vivisect/vivisect/(threads)

Thread 51 (2015-02-24):

Sniper support for x64 on windows platform

cmaruti, 2015-02-24:
Hi,
I'm trying to figure out how to handle parameters (both for reading and writing argument) on platfrom that pass arguments to the win32 API not on the stack (like x64). I guess setPreCallArgs from CallingConvention object (vivisect/envi/__init__.py) is the right way to do but I have no success.
Let me explain with a snip of code.

```
import sys
import struct
import platform

VDB_ROOT = "C:\\vivisect"
sys.path.append(VDB_ROOT)

TARGET_EXE = "C:\\Windows\\System32\\calc.exe"

from vtrace import *
import envi.memory as e_mem

_log = lambda msg: sys.stderr.write("[+] VTRACE_LOG> " + msg + "\n")
_err = lambda msg: sys.stderr.write("[!] VTRACE_ERR> " + msg + "\n")

def HaxorPreHook(event, trace, ret_addr, args, callconv):
	if trace.isValidPointer(args[2]):
		buf = trace.readMemory(args[2], 255*2)
		ubuf = buf.decode('utf-16le','ignore')
		rstr = ubuf.split('\x00')[0]
		if trace.probeMemory(args[2], 6, e_mem.MM_WRITE):
			buf = ("H4x0r\0").encode('utf-16le')
			trace.writeMemory(args[2], buf)

	#does not work..
        #tmp = args[:]
	#tmp[3] = 0x2
	#callconv.setPreCallArgs(trace.getEmulator(),argc=tmp)

trace = vtrace.getTrace()

os = trace.getMeta('Platform').lower()
print ("System platform is: %s " % os)
print ("Architecture is: %s" % platform.machine() )
print ("The size of pointer is: %d bytez" % trace.getPointerSize() )

# detect calling convention
cc = None
# number of arguments (12 for user32.CreateWindowExW)
argc = None

if '64' in trace.getMeta('Architecture'):
	cc = trace.getEmulator().getCallingConvention('msx64call')
	argc = 12

# Hook call to  kernel32.CreateWindowExW
addHook(trace, "user32.CreateWindowExW", HaxorPreHook, cc=cc, argc=argc)

# Run TARGET_EXE
trace.execute(TARGET_EXE)

# Enter in the debug loop
while trace.isAttached():
	trace.run()
```

After I understand this kind of magic I 'd like to push a new updated version of the sniper module (vivisect/vdb/recon/sniper.py) that works both for 32 and 64 os

invisig0th, 2015-02-24:
Hey man! so the following code works for me on both i386 and amd64:

```
import vtrace
import vtrace.breakpoints as v_bp

def hookfunc(event, trace, retaddr, args, cc):
    print('ret: 0x%.8x: %r' % (retaddr,args))
    if trace.isValidPointer(args[2]):
        if trace.readMemory(args[2],20).decode('utf-16le') == 'Calculator':
            trace.writeMemory(args[2],'woot\x00'.encode('utf-16le'))

trace = vtrace.getTrace()

v_bp.addHook( trace, 'user32.CreateWindowExW', hookfunc )

trace.execute(r'c:\windows\system32\calc.exe')
trace.setMode('RunForever', True)
trace.run()
```

If you wanted, you could probably modify "args" and use setCallArgs(trace,args).  Keep in mind that when the breakpoint hits, we're *in* the function entry point, so setCallArgs rather than setPreCallArgs().

cmaruti, 2015-02-24:
Thanks; I will get a closer look at it tomorrow following your suggestion
Il 24/feb/2015 22:30 "invisig0th" <notifications@github.com> ha scritto:

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

cmaruti, 2015-02-27:
Trying this way
```
def HaxorPreHook(event, trace, ret_addr, args, callconv):
	new_args = args[:]
	new_args[3] = 0x8 #WS_EX_TOPMOST
	callconv.setCallArgs(trace.getEmulator(), args=new_args)
```
get my a segment violation error (Pre hook callback "<function HaxorPreHook at 0x0000000002A56978>" exception: SegmentationViolation('Bad Memory Access: 0x28L',). Any ideas or suggestion?

cmaruti, 2015-03-10:
the last problem I had reported seems related to the number of arguments passed to the addHook function (12); btw the below code does not achieve its goals :(
```
import vtrace
import vtrace.breakpoints as v_bp

def hookfunc(event, trace, retaddr, args, cc):
    if(args[0] == 0x100):
        print "make always on top..."
        args[0] = 0x8 #WS_EX_TOPMOST
        cc.setCallArgs(trace.getEmulator(), args=args)

trace = vtrace.getTrace()

if '64' in trace.getMeta('Architecture'):
	cc = trace.getEmulator().getCallingConvention('msx64call')
	argc = 4

v_bp.addHook( trace, 'user32.CreateWindowExW', hookfunc, cc=cc, argc=argc )

```

cmaruti, 2015-03-16:
Ok I figured out the problem. I incorrectly used the trace.getEmulator() obj instead of trace obj while calling the setCallArgs() function. I left here for further reference...

Closed 2015-03-16.

Thread 57 (2015-03-25):

generic ptr analysis on PEs should be ditched if relocatible

invisig0th, 2015-03-25:
A PE being compatible with rebasing means every in-memory pointer (that's legit) will have a reloc slot.  PEs that can be rebased should *not* be subject to generic ptr finding.

invisig0th, 2015-03-26:
fixed in mainline ( only opened the ticket because I thought I might not get a chance to squash immediately )

Closed 2015-03-26.

Thread 58 (2015-04-06):

Vdb exec inversed logic of continue after attached.

bat-serjo, 2015-04-06:
By default "config -s vdb.BreakOnEntry" is false. But behaves as if true!
example
serj@debian:~/examples/CRACKME$ python ~/netstock/vivisect/vdbbin Crackme
Invalid VDB_EXT_PATH dir: /home/serj/examples/CRACKME/vdb/ext
vdb > config
cli.verbose=false
vdb.BreakOnEntry=false
vdb.BreakOnMain=false
vdb.KillOnQuit=false
vdb.SymbolCacheActive=true
vdb.SymbolCachePath="/home/serj/.envi/symcache"
vdb > exec Crackme

ERROR: (Exception) PT_ATTACH failed! linux platformExec
vdb > exec Crackme
PID 4445 exited: 5 (0x00000005)
vdb > exec Crackme
vdb > Attached to : 4450
Loading Binary: /home/serj/examples/CRACKME/Crackme
Loading Binary: /lib/x86_64-linux-gnu/ld-2.19.so
Loading Binary: [vdso]
Thread: 4450 NOTIFY_BREAK

------------------------------------------------------------------------------------------------
On the oposite when you set it to true -

vdb > config -s vdb.BreakOnEntry=true
vdb.BreakOnEntry=true
saved configuration file to: /home/serj/.vdb/vdb.json
vdb > config
cli.verbose=false
vdb.BreakOnEntry=true
vdb.BreakOnMain=false
vdb.KillOnQuit=false
vdb.SymbolCacheActive=true
vdb.SymbolCachePath="/home/serj/.envi/symcache"
vdb > exec Crackme
vdb > Exit Thread: 4536 (ecode: 0x00000000 (0))
Attached to : 4536
Loading Binary: /home/serj/examples/CRACKME/Crackme
Loading Binary: /lib/x86_64-linux-gnu/ld-2.19.so
Loading Binary: [vdso]
Thread: 4536 NOTIFY_BREAK
No cookies for you
PID 4536 exited: 0 (0x00000000)

It should have waited in the later example and continue in the first.
Problem was traced back to vdb/__init__.py line (423) and should be replaced with something like:

            # only respect BreakOnEntry if we exec'd something
            if self.config.vdb.BreakOnEntry and trace.hasMeta('ExecCommand'):
                self.runagain = False # skip initial break
            else:
                self.runagain = True

invisig0th, 2015-04-11:
haha, looks like a good catch! i'll confirm and fix shortly :)

bat-serjo, 2015-04-13:
Glad to help.
Really like the code base, clean and ordered.

2015-04-11 23:49 GMT+02:00 invisig0th <notifications@github.com>:

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

l1berty, 2015-04-15:
The described symptoms appears to be a combination of 2 conditions:
1.  race condition due to parent/child relationship race for PT_TRACE_ME / PT_ATTACH
(https://github.com/vivisect/vivisect/blob/master/vtrace/platforms/linux.py#L313)
2.  not finding the __entry symbol
(https://github.com/vivisect/vivisect/blob/master/vdb/__init__.py#L78)

For example, I can repro the issue if I peg my other core's and remove the time.sleep call.

This does not appear to be inverted behavior of the BreakOnEntry.  @bat-serjo Can you confirm?

note: still should improve synchronization between parent/child.

bat-serjo, 2015-04-16:
Yes especially the race between [attach_me, attach] is easily
reproducible on my (weak) machine Sometime i get attached to the children
before it's address space have been repopulated and see the memory map of
the vdb.
I believe the parent must perform wait on the child for (i don't remember
the signals name) and then attach to it.

About the entry point symbol I have not experienced this yet even thou I
played with a little crackme that subverts the entry point.

However these two are independent from the logic behind the vdb
configuration for attach on entry.

2015-04-16 1:55 GMT+02:00 l1berty <notifications@github.com>:

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

bat-serjo, 2015-04-24:
After some experimenting in vtrace/platforms/linux.py this seems to be rock solid.
@v_base.threadwrap
    def platformExec(self, cmdline):
        # Very similar to posix, but not
        # quite close enough...
        self.execing = True
        cmdlist = e_cli.splitargs(cmdline)
        os.stat(cmdlist[0])

        pid = os.fork()

        # Child will be blocked after execv because of trace me!
        if pid == 0:
            v_posix.ptrace(v_posix.PT_TRACE_ME, 0, 0, 0)
            os.execv(cmdlist[0], cmdlist)
            sys.exit(-1)

        # Parent will wait for the child
        for i in xrange(0, 33):
            rid, status, rusage = os.wait4(pid, os.WCONTINUED |
                                                os.WUNTRACED  |
                                                os.WNOHANG)
            if status != 0:
                break
        
        res = v_posix.ptrace(PT_ATTACH, pid, 0, 0)
        if res < 0:
            raise Exception("Oh no can't PTRACE!")
            
        self.pthreads = [pid,]
        self.setMeta("ExeName", self._findExe(pid))
        return pid

Looks like the logic in vdb is perfectly fine! The problem was in this function.

Closed 2015-09-21.

Thread 61 (2015-04-28):

win32 platformResumeThread

cmaruti, 2015-04-28:
Seems that platformResumeThread doesn't work as expected on win32 systems. I track down the problem to the following code fragment (file `vtrace/platforms/win32.py`)

```
def platformResumeThread(self, thrid):
        if kernel32.ResumeThread(thrid) == 0xffffffff:
            raiseWin32Error()
```

Accordingly to the MSDN definition (https://msdn.microsoft.com/en-us/library/windows/desktop/ms685086(v=vs.85).aspx) and also the declaration at line `896` in the aforementioned source file, the function call takes an HANDLE as input parameter. Instead the code pass a the thread id so the final result is not consistent. Make sense?

invisig0th, 2015-05-09:
Yep! i'll go take a look.  sorry about the laaaag.  :)

invisig0th, 2015-05-09:
Committed a fix, dunno how that managed to stay dorked so long, thanks!

Closed 2015-05-09.

Thread 81 (2015-08-03):

Exception when trying to "go" rather than "stepi" for PE32 driver

msftsecurityteam, 2015-08-03:
Hi guys, I am trying to emulate a portion of code in a 32-bit PE Windows .sys driver.  I can "stepi" through the code but after setting a breakpoint, issuing "go" gives an exception.

vdb > bp 0x24ea8
 [ Breakpoints ]
[0] 0x00024ea8 Breakpoint: 0x24ea8 enabled: True fast: False
vdb > go
Running Tracer (use 'break' to stop it)

ERROR: (AttributeError) 'TraceEmulator' object has no attribute 'archGetBreakInstr'
vdb >

invisig0th, 2015-08-03:
Hrm, looks like the TraceEmulator may be either missing an arch mixin or be using an outdated API.  I'll take a look ( hopefully this afternoon ).  Probably an easy fix, but may be one of those "on to the next bug" situations in rarely traveled code :)

Thread 86 (2015-09-22):

Vivisect chokes on this file

bat-serjo, 2015-09-22:
This library chokes vivisect.
https://www.fireeye.com/blog/threat-research/2015/09/flare-on_challenges.html

How do you upload files here ?!?

It comes from the flare-on challenge. Level 6.
Validates the input. Should return "That's it!".
Basically forces you to enter the email your self.

```
libvalidate.so: ELF 32-bit LSB shared object, ARM, EABI5 version 1 (SYSV), dynamically linked, interpreter /system/bin/linker, stripped

serj@debian:~/examples/CRACKME/FLARE/6$ ~/netstock/vivisect/vivbin -B ./libvalidate.so                                                                                                 
Traceback (most recent call last):                                                                                                                                                     
File "/home/serj/netstock/vivisect/vivbin", line 142, in <module>                                                                                                                    
    main()                                                                                                                                                                             
File "/home/serj/netstock/vivisect/vivbin", line 98, in main                                                                                                                         
    vw.loadFromFile(fname, fmtname=parsemod)                                                                                                                                           
File "/home/serj/netstock/vivisect/vivisect/__init__.py", line 2071, in loadFromFile                                                                                                 
    fname = mod.parseFile(self, filename)                                                                                                                                              
File "/home/serj/netstock/vivisect/vivisect/parsers/elf.py", line 15, in parseFile                                                                                                   
    return loadElfIntoWorkspace(vw, elf, filename=filename)                                                                                                                            
File "/home/serj/netstock/vivisect/vivisect/parsers/elf.py", line 92, in loadElfIntoWorkspace                                                                                        
    platform = elf.getPlatform()                                                                                                                                                       
File "/home/serj/netstock/vivisect/Elf/__init__.py", line 535, in getPlatform                                                                                                        
    for note in self.getNotes():                                                                                                                                                       
File "/home/serj/netstock/vivisect/Elf/__init__.py", line 524, in getNotes                                                                                                           
    offset = note.vsParse(notebytes,offset=offset)                                                                                                                                     
File "/home/serj/netstock/vivisect/vstruct/__init__.py", line 143, in vsParse                                                                                                        
    offset = fobj.vsParse(sbytes, offset=offset)                                                                                                                                       
File "/home/serj/netstock/vivisect/vstruct/primitives.py", line 147, in vsParse                                                                                                      
    self._vs_value = struct.unpack(self._vs_fmt, b)[0]                                                                                                                                 
struct.error: unpack requires a string argument of length 4                                                                                                                            
serj@debian:~/examples/CRACKME/FLARE/6$
```

after some dirty pcatching i got

```
Loaded (0.1182 sec) ./libvalidate.so
parseOpcode error at 0x0200141f: InvalidInstruction("p_mult: invalid instruction 'd10f2a07' at 0x2001427L",)
parseOpcode error at 0x02001c15: InvalidInstruction("p_mult: invalid instruction 'b50f1c87' at 0x2001c1dL",)
parseOpcode error at 0x020017a7: InvalidInstruction("p_mult: invalid instruction 'b5041cc7' at 0x20017afL",)
parseOpcode error at 0x0200132d: InvalidInstruction("p_uncond (ontop=0): invalid instruction '6c7047f0' at 0x2001335L",)
parseOpcode error at 0x02001331: InvalidInstruction("p_uncond (ontop=2): invalid instruction 'b5cb6bf9' at 0x2001339L",)
parseOpcode error at 0x02001469: InvalidInstruction("p_mult: invalid instruction 'd10f2a07' at 0x2001471L",)
parseOpcode error at 0x02000e71: local variable 'Rn' referenced before assignment
ANALYSIS TIME: 0.89896607399
stats: {'functions': 38, 'relocations': 0}
Saving workspace: ./libvalidate.so.viv

~/netstock/vivisect/vivbin  ./libvalidate.so.viv
Loaded (0.0172 sec) ./libvalidate.so.viv
```

So far so good. Strings workspaces are there. Elf structures are parsed. Imports, Exports. Some functions exit but they don't look very good.
At one point we start getting this error

```
.text:0x020013f3  FUNC: void unknown libvalidate._Unwind_DeleteException( ) [1 XREFS]
.text:0x020013f3
.text:0x020013f3  Stack Variables:
.text:0x020013f3
.text:0x020013f3  b5836801         streqh r8,[r8, #-0x35]!
.text:0x020013f7  1c002b01         bxeq r12
.text:0x020013fb  d0012098         stmloda r0!,{r4, r6, r7, r8, }
.text:0x020013ff  4708bd10         adcnes r0,sp,r7, asr #16
.text:0x02001403
.text:0x02001403  FUNC: void unknown libvalidate._Unwind_VRS_Get( ) [0 XREFS]
.text:0x02001403
.text:0x02001403  Stack Variables:
.text:0x02001403
.text:0x02001403  b5041c04         ldreq r0,[r12] #-0x4b5
.text:0x02001407  2913d808         ldmeqia r8,{r0, r3, r5, r8, r9, r12, }^
.text:0x0200140b  1c00f072         rscvcs r0,r0,#0x1c
.text:0x0200140f  fd050311         strned r0,[r3, -sp]
.text:0x02001413  03030001         mrseq r0,
Render Exception At 0x2001413L: cannot concatenate 'str' and 'NoneType' objects
.text:0x02001413  03030001         mrseq r0,
Exception At 0x2001413L: Traceback (most recent call last):
File "/home/serj/netstock/vivisect/envi/memcanvas/__init__.py", line 304, in renderMemoryAppend
    rsize = rend.render(self, va)
File "/home/serj/netstock/vivisect/vivisect/renderers/__init__.py", line 51, in render
    self.renderLocation(mcanv, loc, name, func, cmnt, extra)
File "/home/serj/netstock/vivisect/vivisect/renderers/__init__.py", line 158, in renderLocation
    mcanv.addText("Opcode Render Failed: %s\n" % repr(extra))
File "/home/serj/netstock/vivisect/envi/archs/arm/disasm.py", line 1461, in __repr__
    x.append(o.repr(self))
File "/home/serj/netstock/vivisect/envi/archs/arm/disasm.py", line 2089, in repr
    return psrs[self.psr] + '_' + fields[self.val]
TypeError: cannot concatenate 'str' and 'NoneType' objects
```

Also code analisys doesn't do well.

```
.text:0x02000e65  FUNC: void unknown libvalidate.Java_com_flareon_flare_ValidateActivity_validate( ) [0 XREFS]
.text:0x02000e65
.text:0x02000e65  Stack Variables:
.text:0x02000e65
.text:0x02000e65  b5504c05         streqb r5,[r12, #-0xb5]
.text:0x02000e69  1c0021a5         strge r0,[r1, #-0x1c]!
.text:0x02000e6d  4402921e         cdpne p2,9,c0,c2,c4,2
.text:0x02000e71  a8
.text:0x02000e72  4e
.text:0x02000e73  4a
.text:0x02000e74  01
.text:0x02000e75  f0
.text:0x02000e76  48
.text:0x02000e77  f8
.text:0x02000e78  4d
.text:0x02000e79  49
.text:0x02000e7a  5c
.text:0x02000e7b  22
```

And some like this occurs

```
.plt:0x02000de4
.plt:0x02000de4  FUNC: void unknown sub_02000de4( ) [1 XREFS]
.plt:0x02000de4
.plt:0x02000de4  Stack Variables:
.plt:0x02000de4
.plt:0x02000de4  00c68fe2         adr r12,loc_02000dec
.plt:0x02000de8  04ca8ce2         add r12,r12,#0x4000
.plt:0x02000dec  loc_02000dec: [1 XREFS]
.plt:0x02000dec  00f2bce5         ldr pc,[r12, #0x200]!
.plt:0x02000df0  00
.plt:0x02000df1  c6
.plt:0x02000df2  8f
.plt:0x02000df3  e2
.plt:0x02000df4  loc_02000df4: [1 XREFS]
.plt:0x02000df4  04
.plt:0x02000df5  ca
.plt:0x02000df6  8c
.plt:0x02000df7  e2
.plt:0x02000df8  f8
.plt:0x02000df9  f1
.plt:0x02000dfa  bc
```

atlas0fd00m, 2015-09-22:
sergey,

could you please send the library to my email address atlas@r4780y.com?

thanks,
@

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
)
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
in
> __repr__ x.append(o.repr(self))
> 	File "/home/serj/netstock/vivisect/envi/archs/arm/disasm.py", line 2089,
in
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

--
3031303030303131303131303131313130313130313130313031313030313031303031303030303030313130313131303031313031313131303031303030303030313130303131303031313130313031303131313030313030313131303130303031313031303030303131303031303130313131303031303030313031313030303031303030303030313130303131303031313031313131303131313030313030303130303030303031313030313030303131303031303130313130303030313031313130313030303131303130303030303130303030303031313030303031303131313031313130313130303030313031313031303031303131313031303030313131303031313030313030303030303131313130303130313130313131313031313130313031303031303030303030313130303030313031313031313030303131303131303030303130303030303031313130313131303131303130303130313131303130303031313031303030303031303030303030313130313131303031313030303031303131313030313130313131303130303031313131303031303031303131303030303130303030303031313030303130303131303130303130313130303131313030313031313030303031303030303030313131303030303031313031313131303131303130303130313130313131303031313130313030303131313130303130303130303030303031313130313030303131303031303130313130303130313031313130313030303131303130303030303030313031300A

Closed 2016-11-15.

Thread 90 (2015-10-06):

makeName(None) exceptions

atlas0fd00m, 2015-10-06:
currently VivWorkspace indicates this method in order to remove a name:  "makeName(None)".

when attempting to clear out a name in the workspace (to reuse it), the following exception occurs.
this appears to be due to updates to the call graph.

Traceback (most recent call last):
  File ".../vivisect/base.py", line 499, in _fireEvent
    self.ehand[event](einfo)
  File ".../vivisect/base.py", line 314, in _handleSETNAME
    self._call_graph.setNodeProp(fnode,'repr',name)
  File ".../visgraph/graphcore.py", line 186, in setNodeProp
    raise Exception('graph prop values may not be None! %r' % (node,))
Exception: graph prop values may not be None! (33559537L, {'repr': 'libvalidate._Unwind_Complete'})

Closed 2020-07-27.

Thread 120 (2016-03-30):

Walk through

redheadedrod, 2016-03-30:
Can someone walk me through how to use this program?

And maybe have some example code to use with this?

Looks like I will be doing some work extending this software this summer but I want to demo it in my Architecture class to the other students for my end of semester presentation. I have briefly looked through the software but if someone could walk me through a basic run of the program that would save me a LOT of time and get me on the ground running for this summer. I don't really see much documentation on using it so a little help would go a long ways.

Thank you!

williballenthin, 2016-03-30:
There's a lot in vivisect, and sample code is spread all over the place. Here's a few quick points that definitely do not do the tool justice.

show vivisect analysis results and ui: `vivbin -A /usr/bin/ls`
debug with vivisect vdb: `vdb -Q /usr/bin/ls`

load a workspace:

    vw = vivisect.VivWorkspace()
    vw.verbose = verbose
    vw.config.viv.parsers.pe.nx = True
    vw.loadFromFile("/usr/bin/ls")
    vw.analyze()
    vw.saveWorkspace()

disassemble an instruction:

    o = vw.parseOpcode(0x401000)
    print(o)
    print(dir(o))

list functions:

    vw.getFunctions()

get cross references:

    vw.getXrefsTo(0x401000)

get basic blocks for function:

    vw.getFunctionBlocks(0x401000)

There's hundreds of functions and thousands of things you can easily do, so this is the smallest taste of its functionality. But hopefully it gives you ideas for some things you can include during your demo.

cmaruti, 2016-03-30:
I have collected a lot of pointers over the years to various vivisect materials. Here you go:
- https://www.singlehop.com/blog/binary-vivisection-part-1/
- https://www.singlehop.com/blog/binary-vivisection-part-2/
- https://www.singlehop.com/blog/binary-vivisection-part-3/
- http://nest.unm.edu/files/5514/1254/9114/Malware_Analysis_with_Vivsect.pdf
- https://www.fireeye.com/blog/threat-research/2013/02/custom-vdb-debugger-exploit-analysis.html
- https://github.com/fireeye/flare-dbg/
- http://shellsherpa.nl/stealing-keepasswords-with-vivisect
- http://dvlabs.tippingpoint.com/blog/2012/04/02/mindshare-vtrace-input-tracking

A bit outdated but still a good references:
- https://www.defcon.org/images/defcon-16/dc16-presentations/defcon-16-atlas.pdf
- https://github.com/pdasilva/vtrace_scripts

redheadedrod, 2016-04-01:
Thanks for the pointers. I will try working with this this weekend and go from there. I am going to try doing a demo of using this program for my Architecture class  so I have a couple weeks to learn how to use it.

I also received some other pointers offline so hopefully I have enough to get started playing with it.

Rodney

redheadedrod, 2016-04-09:
While trying these there seems to be a bug/issue that has come up.
With the part-1 the file reverseme.exe is converted to a .viv file and then opened up in the gui.
The instructions say to click on the "strings" tab which has nothing in it. I have tried this with other programs and I am
getting the same result. I have tried this on a machine running Windows 10, Windows 8.1 and under Ubuntu 15.10 and they all show the same issue so I am under the impression it is a bug at this point in time.

Or am I missing something?
I have been able to do some other stuff and look through stuff as well but I just don't see the strings.
I have also tried the atlas fork as well as the main fork for this.

Rodney

Date: Wed, 30 Mar 2016 08:42:15 -0700
From: notifications@github.com
To: vivisect@noreply.github.com
CC: redheadedrod@hotmail.com
Subject: Re: [vivisect/vivisect] Walk through (#120)

I have collected a lot of pointers over the years to various vivisect materials. Here you go:

https://www.singlehop.com/blog/binary-vivisection-part-1/
https://www.singlehop.com/blog/binary-vivisection-part-2/
https://www.singlehop.com/blog/binary-vivisection-part-3/
http://nest.unm.edu/files/5514/1254/9114/Malware_Analysis_with_Vivsect.pdf
https://www.fireeye.com/blog/threat-research/2013/02/custom-vdb-debugger-exploit-analysis.html
https://github.com/fireeye/flare-dbg/
http://shellsherpa.nl/stealing-keepasswords-with-vivisect
http://dvlabs.tippingpoint.com/blog/2012/04/02/mindshare-vtrace-input-tracking

A bit outdated but still a good references:

https://www.defcon.org/images/defcon-16/dc16-presentations/defcon-16-atlas.pdf
https://github.com/pdasilva/vtrace_scripts

—
You are receiving this because you authored the thread.
Reply to this email directly or view it on GitHub

cmaruti, 2016-04-11:
Hi @redheadedrod
first of all did you load a layout? (Use _View->Layouts->Load and select vivisect/qt/default.lyt_).
I just tested the binary referenced in the tutorial and I can see the strings pane correctly filled up...

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

redheadedrod, 2016-04-11:
Yes I am using the default load out.
I downloaded the latest vivisect from github by downloading a zip and copied this to its own directory as late as 4/8.

I am using anaconda under windows 10 and loaded the pyqt class.
Using ipython which is using the 2.7 python kernel.
Everything else I try is working so far but not the strings portion. Ive loaded all three of the programs mentioned in the first 3 tutorials but I am not seeing strings in any of them.

Ive also tried it under windows 8.1 and Ubuntu 15.10. The ubuntu I installed ipython via anaconda.

I wonder if I am missing something in the folder that might be preventing it from working?

Did you try it with the current github version?

I have also had issues when I maximize the screen that shows the graph. When I close it out my instance of vivisect crashes and I have to restart it.  So I have learned not to maximize the graph.

Thanks for your help! I really want to get down to the nitty gritty with this program in the next week or so since I hope to demo using this program end of next week as my presentation in my architecture class.

I look forward to working with this framework this summer and hopefully I will be productive in extending it in whatever manner my mentor has in mind for me. I do appreciate any help you or anyone else provides as it accelerates my understanding and hopefully will help me be productive that much sooner.

cmaruti, 2016-04-11:
Just checked out the last master and I had the same problem reported by @redheadedrod cc: @atlas0fd00m @invisig0th

atlas0fd00m, 2016-04-11:
i've been noticing a serious degradation of string identification recently.  so much so that i've written a temporary string-scraping script for some firmware i'm tearing apart right now.  we need to look into it better.  i believe i saw that only function analysis looks for strings in xrefs from within the functions.  ideally that would be enough, but with string arrays and such, this seems insufficient.

redheadedrod, 2016-04-12:
It seems to be a sporatic thing. I have tried running it on my laptop yesterday under Windows 10 and something must have been updated because now the strings are working but the layout system is touchy but just on my laptop. If I load a new layout instead of replacing the current layout it just takes some portion of the screen and combines it together in a weird manner. On my desktop running Win 8.1 but with same exact ipython setup I don't see the strings but the layouts work fine. I will try working with this under ubuntu a little more and see if anything changes. The lack of strings issue was happening on my desktop on a ubuntu 15.10 VM but my laptop triple boots so I will try to install it under Ubuntu 15.10 and Kali2.0 rolling and see if I have any better luck.

Date: Mon, 11 Apr 2016 08:54:04 -0700
From: notifications@github.com
To: vivisect@noreply.github.com
CC: redheadedrod@hotmail.com
Subject: Re: [vivisect/vivisect] Walk through (#120)

Just checked out the last master and I had the same problem reported by @redheadedrod cc: @atlas0fd00m @invisig0th

—
You are receiving this because you were mentioned.
Reply to this email directly or view it on GitHub

atlas0fd00m, 2016-04-12:
the strings analysis should happen during Bulk Analysis (vivbin -B somebin.exe) which doesn't use the GUI.  then the generated file (somebin.exe.viv) can be loaded on either machine.

can you describe exactly what happens?  try doing bulk analysis on both systems and loading both generated .viv files on both machines.  let us know if you can isolate anything further.  differences between systems is very odd for viv.

@

--
GUYTKOBVGE3DONJZGUZTIMRWIE2UCNJYGRATGMBVHE2TONSDG42TIOJUHA2DENZWGYYTKNZTGUZTANBZGQ3TMQZXGU2DSNBYGUZDOMBWGI2TONJVG4ZTIOJUHA2TENSGGVATKMZUGI3TSNKBGU4DINRTGE3DCNJYGRATMQZVIE2DGNBSG4ZTKQJVHA2UCNSDGYZDIMZUGI3TMNKBGY4TIMRWIE3DEMZSGMYTONZWGM3EINJWGZDDKQJVG4ZTKN2BGYYTKNZTHE3TKNBZGQ4DKMRXGY2DSNBXGQ3DMQJWGE2DONSDGZBTMNBWIQ2TKNRXGU4TKMZUGI3UCNRUGU3TIRJWIE2UCNJYGRCTOQJVIE3EKNJWG4ZTIOJUG42TMMZUGYZTINZXHA3TMNRRGU4DKMRWHA3DINBXGZBTONRWGI3DSNBSG44TKQJVG42DMNSBGYYTINZVGY3UCNBZGQ4DKMRWIY2UCNJTGQZDMQZVIE2DONRUGZBTIOJUG4ZTSNSEGQ4TINZWIM3TKNRTGMZDINRXGU3DCNJYGUZDGNJUIM3DSNBSGU2TMMJUG42TKNRXGYZTGMZUGI3TANRTGZCDMQZTGA2DSNBXGMYTMQZWGI2DQNJSG5ATIOJUHA3DINZQGY2DINZWG43DONRSGU3TINRWII3DENSEGU3DOQJWGM3TSNZXGY3TMNBTGI2TKNRXGY2DINZVGY3TINRTGQ3TGOJXHE2TSNJYGRATOMBWGI2DQNSCGY3TMMRUG4ZTSNZWGYZTGMRVGU3DONJZGU3TOOBXGM2DSNBXG42DOMBWGI3EINJRGY3TMMRTGI2TSNRXGYZTMRBUGYZTANRRGU3TGOJXGU2TSNJXG44DOMBWGQ2DQNSCGY3TKOJVG4ZTKNSCGQ4TIOBWGQ3EGNBZGQ3TKNRXGU3DINBXGU3DOOJUHE2DONBVGY3TMMZTGM2TENRYGY2DINZVGU3DONRSGMZDKOJWG43DCNJXG44DOMZWGQ2TOMZRG4YDMMRWIQ2DMMZQGYYTKNZTHE3TKNCDGY4TIMJXGQ2DSNBYGVATMQRVGE2DQNBSGZDDMMZWIQ2DMNSBGYYTOOJTGU3TMNRTGZCDMMZUII======

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

redheadedrod, 2016-04-12:
How I am doing this is running vivbin -B reverseme.exe which produces a reverseme.exe.viv file.

I then load this by using the command vivbin reverseme.exe.viv

I have tried this both in windows and linux and get the same result. This is a simple windows program that expects a key and kicks out with "evaluation period has ended". It is special made for reverse engineering to remove the "evaluation period has ended" warning. When you bypass the key it says something like "You completed it!"

While I can see strings in the .DATA segment I am seeing absolutely nothing in the Strings tab...
The strings in the .DATA segment show references in the listing so the program knows they are there.
And they also end with a 00 so it should be easy for the program to pick up those strings.

I get a little different response when running ELF binaries.

I compiled conditional.c from one of the tutorial links and loaded it via using the same command as before:
vivbin -B conditional
Then run the GUI via:
vivbin conditional.viv

With this I DO get some entries in the strings tab but they seem to be references to libraries installed by the program and I see a puts\x00 and printf\x00  Otherwise it appears to just be listing the libraries it is using and some versioning related to the libraries.

I do seem to be getting the same results with the strings tab regardless of where I am going and is very repeatable. I am not familiar enough (yet) with ELF format to know where to find strings.

Update on the layouts issue I was having too...
When loading a new layout the layout is laid on top of the current layout. In order to properly load a new layout I have to remove all of the windows until I just have the interactive window. Shouldn't the program clear the current layout before loading a new layout over the top of the screen? It really looks weird if you load the default layout over the top of the default layout.

Note I am a new user to this program and have not touched upon the CLI much yet. I have been trying to understand the program as much as I can for my presentation next week.

cmaruti, 2016-04-14:
@redheadedrod commit [#124](https://github.com/vivisect/vivisect/commit/e37aa4b3b649cd368be13171d405c5b503e301e1) resolve the issue you reported

Closed 2022-01-20.

Thread 122 (2016-04-11):

syscomments to allow the disassembly/analysis to insert/delete "system" comments without mucking with manual comments.

atlas0fd00m, 2016-04-11:
for example:
ARM binaries often perform a GOT-offset calculation and store the GOT location in a register, allowing register-math to access all the resources in a position-independent way.  it would be awesome to be able to have analysis modules look for such pointer math and stick a comment about where it points.  this may not be the end result for handling this particular PIE-like thing... but quickly devving up an impromptu analysis module which can write comments without fear of collision with user comments is a big plus.  being able to delete them (programmatically, or as a user interaction) without mucking with user comments is a great thing as well (eg. clean up after a bad analysis pass).

atlas0fd00m, 2021-03-12:
not worth the effort at this time...  best to just make the comment (prepending if one exists) which is just an extra 3 lines of code.

Closed 2021-03-12.

Thread 123 (2016-04-12):

Automatizing Strings + inline commented

jags613, 2016-04-12:
Hi!

I see that strings only show up in the strings pane if manually designated as such.

Is it possible to have automatic analysis to add strings (even if it adds some garbage or false positives)?
And if so, could these then be shown in line when referenced in the assembly/graph views?

This can be very helpful when analyzing for functionality.

Thanks!

invisig0th, 2016-04-12:
The automatic analysis pass (for most plaforms/formats) should be able to identify string constants in general.  Would you mind sharing a bit more about the circumstances?  Also, vivisect *strongly* prefers "correctness" over "completeness" ( primarily designed to facilitate algorithmic approaches rather than humon review ) so loosening strings and causing more false positives will probably not work.

jags613, 2016-04-12:
In that case, let me backtrack, the strings pane doesn't include anything (running vivisect on OS10.11) both when analyzing PE or Mach-O binaries. If I find the string and designate it as such then it'll show up but not otherwise.

invisig0th, 2016-04-12:
Did you create the workspace yourself ( via the API ) or via the cli?  ( If you were working directly with the workspace API, dont forget to call analyze() ).  Do you see functions and such?

jags613, 2016-04-12:
Not sure where the analyze() instruction would go (haven't found documentation for the API, though would love a means to invoke standalone emulator features if that's already in there). I'm creating/launching with vivbin -B <binary>. Am I missing a step for the analysis?

invisig0th, 2016-04-12:
Nope, vivbin -B should be doing the analysis pass and then saving the results (including emulation).

cmaruti, 2016-04-12:
Here you go with a sample snippet of code I did in the past to practice with the API
```python
import sys

VDB_ROOT = "K:\\vivisect_20140803"
sys.path.append(VDB_ROOT)

import vivisect.cli as viv_cli
import vivisect.parsers as viv_parsers

TARGET_NAME = "C:\\Windows\System32\calc.exe"
DEBUG = True

vw = viv_cli.VivCli()
parsemod = viv_parsers.guessFormatFilename(TARGET_NAME)
vw.loadFromFile(TARGET_NAME, fmtname=parsemod)
vw.analyze()

print "Segments #: %d" % len(vw.getSegments())

if DEBUG:
  print "[Segments]"
  for seg in vw.getSegments():
    print seg

print "Imports #: %d" % len(vw.getImports())

if DEBUG:
  print "[Imports]"
  for imp in vw.getImports():
    print imp

print "Exports #: %d" % len(vw.getExports())

if DEBUG:
  print "[Exports]"
  for exp in vw.getExports():
    print exp

print "Functions #: %d" % len(vw.getFunctions())

if DEBUG:
  print "[Functions list]"
  for func in vw.getFunctions():
    print "\t0x%08x %s" % (func, vw.getName(func))

print "Names #: %d" % len(vw.getNames())

if DEBUG:
  print "[Names]"
  for addr, name in vw.getNames():
    print "\t0x%08x %s" % (addr, name)```

atlas0fd00m, 2016-04-12:
i like to set verbose mode to 4 before calling analyze:

...
vw.verbose=4
vw.analyze()
...

but that's because i love all the nummy details (probably cuz it helps me develop)

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
--
4B5255474B345446454255584749444F4E34514732594C484E465253413544504542525736334C514F5632474B345454465151473633544D5045514732594C484E46525753594C4F4F4D5841553D3D3D
> https://github.com/vivisect/vivisect/issues/123#issuecomment-208962075

jags613, 2016-04-13:
Thank you for the script! I'll play around with this a bit.

Should I chuck up the no-string problem to OSX issues or is there a way to fix this?

atlas0fd00m, 2016-04-13:
@invisig0th visi: VivWorkspace.detectString() is horribly broken.  it bails if the second byte of a potential string is not a location....

invisig0th, 2016-04-15:
Commited your fix.  Without more specifics to address i'd like to close this ticket ( and start fresh if there are more issues )

atlas0fd00m, 2016-04-15:
works for me.  @jags613 work for you?  please pull the latest code and test.

jags613, 2016-04-15:
Thank you for the hard work guys!
Strings work perfectly on OSX host analyzing Windows binaries.
Not getting good results on macho binaries, either no strings at all or some chopped up strings.

Thread 149 (2016-09-13):

envi.memory.parseOpcode cannot decode instructions in last 15 bytes of section

williballenthin, 2016-09-13:
`envi.memory.IMemory.parseOpcode()` cannot decode instructions in the last 15 bytes of a memory map because it blindly asks for 16 bytes from which to decode instructions. see here: https://github.com/vivisect/vivisect/blob/master/envi/memory.py#L301

this always fails in the last 15 bytes because `.readMemory()` calls `.probeMemory()` on 16 bytes, and because at least one byte overruns the section, the entire return buffer is taint data ("AAAAAAA...").

a potential fix is to take 16 bytes, unless we're at the end of the section, and then fetch data only to the end of the section.

Closed 2021-03-08.

Thread 152 (2016-09-18):

Segment mismatch on PE binary

cmaruti, 2016-09-18:
I found that vivisect analyze() detect less segments than the PE parser. The following PoC presents the issue (you can find the sample binary used in the code fragment at the following URL http://www.singlehop.com/blog/wp-content/uploads/reverseme.exe.exe)

```python
import sys

VDB_ROOT = "C:\\vivisect-master"
sys.path.append(VDB_ROOT)

import PE
import vstruct
import vivisect.cli as viv_cli
import vivisect.parsers as viv_parsers

TARGET_NAME = "C:\\Users\\cm\\Documents\\reverseme.exe"

vw = viv_cli.VivCli()

parse_mod = viv_parsers.guessFormatFilename(TARGET_NAME)

if parse_mod != "pe":
	sys.exit("[!] Executable file format not supported by vivisect...");

vw.loadFromFile(TARGET_NAME, fmtname=parse_mod)
vw.analyze()

print("vivisect analyze() detect the following segments:")
for seg in vw.getSegments():
	print seg

def parseSections(pe):
	sections = []
	off = pe.IMAGE_DOS_HEADER.e_lfanew + len(pe.IMAGE_NT_HEADERS)

	secsize = len(vstruct.getStructure("pe.IMAGE_SECTION_HEADER"))

	sbytes = pe.readAtOffset(off, secsize * pe.IMAGE_NT_HEADERS.FileHeader.NumberOfSections)
	while sbytes:
		s = vstruct.getStructure("pe.IMAGE_SECTION_HEADER")
		s.vsParse(sbytes[:secsize])
		print s.Name
		sections.append(s)
		sbytes = sbytes[secsize:]

print("PE detect the following segments:")
pe = PE.peFromFileName(TARGET_NAME)
parseSections(pe)
```
And here is the output:
```
vivisect analyze() detect the following segments:
(4194304, 4096, 'PE_Header', 'reverseme')
(4198400, 4096, 'CODE', 'reverseme')
(4202496, 4096, 'DATA', 'reverseme')
(4206592, 4096, '.idata', 'reverseme')
(4210688, 4096, '.reloc', 'reverseme')
PE detect the following segments:
CODE
DATA
.idata
.reloc
.rsrc
```

Thread 203 (2017-12-29):

Website from the README (http://visi.kenshoto.com/) is down

pfalcon, 2017-12-29:
README refers to http://visi.kenshoto.com/ for additional information, but that site can't be contacted. More specifically, "visi.kenshoto.com" or "kenshoto.com" domain names can't be resolved, including when using Google's DNS 8.8.8.8. This happens at least for 2nd day.

Note that without that site, the README barely gives any information about the project, for example Vdb's descriptions starts with:

> As in previous vdb releases, the command python vdbbin

How is that relevant for a new user?

And Vivisect is described as:

> Fairly un-documented static analysis / emulation / symbolik analysis framework

follower, 2019-02-24:
FWIW archive.org has snapshots of the page to which that URL originally redirected:

 * Most recent: [http://visi.kenshoto.com/viki/MainPage (on archive.org)](http://web.archive.org/web/20161225225334/http://visi.kenshoto.com:80/viki/MainPage)

Snapshots of sub pages also seem to be present.

9527KGG, 2019-05-10:
Is it possible to move the doc to github? just wondering~

rakuy0, 2021-03-12:
Possibly? Though it be be more worth it to create new ones since I don't have ready access to them, so I have no idea what state they're in.

They're also definitely pre-python3 vivisect, so even if we migrated them, they'd need some touch ups.

But honestly, me or @atlas0fd00m need to carve out time to just make new docs. Enough has changed in the last few years. We've just been super busy. It's been a long time TODO, but I'm hoping now that python3 is off my plate and some of atlas's big PRs are coming down the home stretch we can carve out time for them.

TL;DR: Been super busy, gonna circle back once some big ticket items are done to write some fresher examples.

(and sorry about the delay in response. I completely missed the notifications about this thread)

Closed 2021-03-12.

Thread 211 (2018-04-21):

8d14f500000000 decodes incorrectly

atlas0fd00m, 2018-04-21:

atlas0fd00m, 2018-04-22:
Currently:
  .text:0x020b80fc  8d14f500000000   lea edx,dword [0x00000000 + esi * 8]

Should be:
  lea     edx, ds:0[esi*8]

rakuy0, 2019-05-09:
@atlas0fd00m Is this still valid (and do you have the binary that displays it)?

I've got a super small test binary that has that byte string in it, and nasm, binary ninja, vivisect, https://onlinedisassembler.com/odaweb/, and https://defuse.ca/online-x86-assembler.htm all seem to agree that 8d14f500000000 all encodes/decodes to lea edx,dword [0x00000000 + esi * 8].

Or does whatever binary this is also have some other segment shenanigans going on and we need to push segment info through the decoding or analysis passes?

atlas0fd00m, 2019-05-10:
damn, i'm dense.  for some reason i thought that said gs:.
closed.

Closed 2019-05-10.

Thread 260 (2019-11-25):

vdb View->Memory Maps crash: trace==None

atlas0fd00m, 2019-11-25:
when attached to a process ("vdbbin -Q -p ####") and attempting a "View->Memory Maps", vdb crashes with this error:

Traceback (most recent call last):
  File "/OTHER/home/atlas/hacking/git/vivisect/vivisect/vqt/menubuilder.py", line 87, in __call__
    return self.callback(*self.args, **self.kwargs)
  File "/OTHER/home/atlas/hacking/git/vivisect/vivisect/vdb/qt/main.py", line 347, in menuViewMemMaps
    self.vqBuildDockWidget('VQMemoryMapView')
  File "/OTHER/home/atlas/hacking/git/vivisect/vivisect/vqt/application.py", line 128, in vqBuildDockWidget
    obj = cls(*args)
  File "/OTHER/home/atlas/hacking/git/vivisect/vivisect/vtrace/qt.py", line 510, in __init__
    envi_qt_memmap.VQMemoryMapView.__init__(self, trace, parent=parent)
  File "/OTHER/home/atlas/hacking/git/vivisect/vivisect/envi/qt/memorymap.py", line 30, in __init__
    self.vqLoad()
  File "/OTHER/home/atlas/hacking/git/vivisect/vivisect/vtrace/qt.py", line 513, in vqLoad
    if not self.trace.isAttached():
AttributeError: 'NoneType' object has no attribute 'isAttached'
Aborted

rakuy0, 2019-11-27:
Interesting. Just tried this on a custom built vim I've got, and it works fine. At least on ubuntu linux. But there's a variety of other things that could have aligned to mess yours up.

Do you happen to have the binary that causes it laying around? Any other recreation steps (like what you were doing at the time, did you click on anything else)?

rakuy0, 2020-05-07:
Poke ^^

Thread 279 (2020-04-21):

ImportError:No module named constants vstruct.constants  as vs_const

maoguai, 2020-04-21:
i was able to use vivisect before ,but now when i import vivisect, i meet ImportError problem

rakuy0, 2020-04-21:
Odd. There's only one place we call `import vstruct.constants as vs_const` and that's in vivisect/base.py. That hasn't changed in a long time and the CI builds for vivisect's master branch say they still work. So that's a bit weird.

So a couple questions to try and help narrow down the problem:
* Do you have any idea as to what changed to make it not work all of a sudden? Was it a git pull or something else?
* What vivisect branch and commit hash are you on?
* Do you have any changes to vivisect sitting on your checkout?
* Just in case, do you have the full exception traceback?
* What python version are you on?
* What's your PYTHONPATH env var look like?

maoguai, 2020-04-22:
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
I use python 2.7,i meet this problem that i just import vivisect .
I use sys.path.append() to add vivisect to my path.
vivisect-master I used MD5 (vivisect-master.zip) = b9a93f09d87b3f201cf29a18c9d9c095 sha1= 280b299d2ff233f878bdadd66ba87637181a5206
I have no idea what have changed

rakuy0, 2020-04-22:
Can you re-download the latest vivisect (I don't know what git commit that md5 of vivisect corresponds to, but the latest zip file md5 is `16061452f7eda084c8399ebb91da1584` and I know that one works). Or you can git clone the latest vivisect master branch like so:
`git clone https://github.com/vivisect/vivisect.git`

That way we're at least on the same version, which should make debugging easier.

maoguai, 2020-04-22:
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
I have updated to the lastest vivisect, but it still doesn't work in python 2.7. could you make it work in python 2.7?
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

rakuy0, 2020-04-22:
It works for me on python 2.7.15 just as you're doing it, which makes me think something else is going on, like a mismatched path or you're colliding with something else like floss.

If you do `import vstruct`, and assuming that doesn't blow up, and then `print(vstruct.__file__)`, what comes out?

And if you just try to run vivbin directly using python, what happens?

maoguai, 2020-04-22:
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
Is problem happened in there?

rakuy0, 2020-04-22:
Yea, you have some conflicting versions of vivisect on your machine, one you seem to have installed via pip and another you're trying to just download and use. The constants module should still exist, which is odd, but conflicting versions are weird, so as a final check, can you do `import vstruct.constants` and `print(vstructs.constants.__file__)`?

But best to just remove the old version in any case and see if that fixes it.

maoguai, 2020-04-22:
ohh,i probably find the mistake that is mismatched path. I delete the vstruct file in python and now it works. Thanks for your patient reply. vivisect is very useful

williballenthin, 2020-04-22:
i bet this guy was the culprit: https://pypi.org/project/vivisect-vstruct-wb/ 😇

Closed 2020-04-22.

Thread 280 (2020-04-25):

vdb with fast-break, target exits on segfault

atlas0fd00m, 2020-04-25:
i would very much like to inspect what segfaults...
but with fast-break, this seems impossible.

without the fastbreakpoint:
```
vdb > Process Recieved Signal 11 (0x0000000b) (Thread: 13171 (0x00003373))
vdb > gui
```

with the following breakpoint:
```
bp -f binary.function+153
bpedit 0 "print '0x%x: 0x%x' % (poi(trace.getRegisterByName('rbp')-24), trace.getRegisterByName('al'))"
```
and we get:

```
Process Recieved Signal 11 (0x0000000b) (Thread: 13082 (0x0000331a))
PID 13082 exited: 0 (0x00000000)
```

the fastbreak is hit repeatedly before the crash.  this seems to be important

Thread 282 (2020-04-25):

vdbbin on amd64 reads memory oddly... and i'm not sure it's correct

atlas0fd00m, 2020-04-25:
you can see the "80484a8* at 0x200 below... but it's offset 4 bytes from what should be.
other seemingly 32-bit numbers look to be the upper 32 of a 64-bit address (see the stack-like addresses in f7f* adn f7e*).  such as the line with `(savedpc)` on it... clearly not in libc if it's a 32-bit number.

furthermore, the initial display of the stack addresses only show the lower 32bits.
see memory maps below.

```
vdb > dr rsp
 0    : 0xffdf16e0 (rsp)   : 0x400ffdf1748
 8    : 0xffdf16e8         : 0xf7dc5cd708f33570
 16   : 0xffdf16f0         : 0x6dcb300000000
 24   : 0xffdf16f8         : 0xf7eb5860f7d522f9
 32   : 0xffdf1700         : 0xf7eb5860f7d52c97
 40   : 0xffdf1708         : 0xf7d52188f7eb75c0
 48   : 0xffdf1710         : 0x8f3357000000000
 56   : 0xffdf1718         : 0x700000400
 64   : 0xffdf1720         : 0x7d4fbad2a84
 72   : 0xffdf1728         : 0xf7eb7d80f7eb5200
 80   : 0xffdf1730         : 0xf7ee9ff808049798
 88   : 0xffdf1738         : 0xf7eb75c0f7d5204b
 96   : 0xffdf1740         : 0xf7eb7000f7eb5860
 104  : 0xffdf1748 (rbp)   : 0xf7d532abffdf17a8(frame1)
 112  : 0xffdf1750         : 0xf7eb75c0(savepc) -rw- libc._IO_2_1_stdin_ + 0
 120  : 0xffdf1758         : 0xf7d52fbcffdf177c
 128  : 0xffdf1760         : 0xf7ed50c0f7d53277
 136  : 0xffdf1768         : 0xf7d463d9f7eb75c0
 144  : 0xffdf1770         : 0xf7ce36d8f7eb75c0
 152  : 0xffdf1778         : 0xf7eb7000f7d53b69
 160  : 0xffdf1780         : 0xf7ee9f49         -r-x 81c7b780010083ec2c8b48348b5...
 168  : 0xffdf1788         : 0xffdf1830f7eb7000
 176  : 0xffdf1790         : 0xf7eefe20ffdf18b8
 184  : 0xffdf1798         : 0xf7eb889c         -rw- libc.__abort_msg + 1748
 192  : 0xffdf17a0         : 0xffdf1824f7eb7000
 200  : 0xffdf17a8         : 0x80484a8ffdf18b8
 208  : 0xffdf17b0         : 0xffdf18acffdf1830
 216  : 0xffdf17b8         : 0xf7cec43800000001
 224  : 0xffdf17c0         : 0x6f6c6c6548
 232  : 0xffdf17c8         : 0x00000000
 240  : 0xffdf17d0         : 0x00000000
 248  : 0xffdf17d8         : 0x00000000
vdb > maps
[ address ] [ size ] [ perms ] [ File ]
0x08048000      4K      -r-x    /home/atlas/formatflaw
0x08049000      4K      -rw-    /home/atlas/formatflaw
0x08f33000    136K      -rw-    [heap]
0xf7cdf000   1876K      -r-x    /lib/i386-linux-gnu/libc-2.27.so
0xf7eb4000      4K      ----    /lib/i386-linux-gnu/libc-2.27.so
0xf7eb5000      8K      -r--    /lib/i386-linux-gnu/libc-2.27.so
0xf7eb7000      4K      -rw-    /lib/i386-linux-gnu/libc-2.27.so
0xf7eb8000     12K      -rw-
0xf7ed4000      8K      -rw-
0xf7ed6000     12K      -r--    [vvar]
0xf7ed9000      8K      -r-x    [vdso]
0xf7edb000    152K      -r-x    /lib/i386-linux-gnu/ld-2.27.so
0xf7f01000      4K      -r--    /lib/i386-linux-gnu/ld-2.27.so
0xf7f02000      4K      -rw-    /lib/i386-linux-gnu/ld-2.27.so
0xffdd2000    132K      -rw-    [stack]
Total Virtual Memory: 2.31 MB
```

atlas0fd00m, 2020-10-05:
this is a 32-bit binary running on 64-bit linux.  this still persists.
we have a number of things which rely on "current python's Pointersize" which *should not*.
on attach, we should identify (probably from the main proggy's ELF header) what the actual pointer-size is and use that instead of "<P" for parsing data.

Thread 294 (2020-07-22):

discussion: black and isort for code formatting

williballenthin, 2020-07-22:
Despite having written Python for some years, I've really appreciated using [black](https://github.com/psf/black) and [isort](https://pypi.org/project/isort/) recently. They generally align to my personal style (which is somewhat close to viv, with the exception of snake casing), and they take away all effort required to keep things consistent. Would the viv project consider using these tools to keep all code in a consistent format?

rakuy0, 2020-07-22:
I'm all for having code in a consistent format so that it all looks, feels, smells, tastes, and gives all glory to the hypnotoad the same. And I like how isort looks. it falls generally in line with how I already like to organize imports. So I'm down for using isort.

Though for most other things, I prefer flake8 or yapf enforcing pep8. There's no strong technical reason for them, I'm just boring and generally like single quotes and how they lay out long lists of function parameters as compared to how black lays them out.

@atlas0fd00m your opinions?

atlas0fd00m, 2020-10-05:
i like the idea of consistent cleanup.  i'm concerned about tools that are too prescriptive of what that looks like.  for instance, i'm a *huge* fan of camel-case for most things.  my personal style would take a serious hit if i were to have to use snake_case for everything.  i'm also a fan of import-ordering from small to large (Christmas-tree-like), but i also prefer having the Vivisect imports separate from external imports.
can `black` be made to support some sort of normalcy around camel-case for objects/classes/methods?

williballenthin, 2020-10-06:
black will format the code, but not rename symbols. however, it has a very specific style and there are essentially no options to configure it. in a way, that's part of the charm - to leave the style up to someone else. though, after years of python coding, we all have our ideal style.

isort has a mode to order by line length, and break the imports into groups: stdlib, external, current project.

we've been using this setup for capa and its pretty nice. takes any sort of debate away from how the code should be laid out. example here: https://github.com/fireeye/capa/blob/master/capa/main.py

williballenthin, 2021-02-08:
bump. with the wide ranging py3 fixes, this is a great time to reformat all the code into a consistent format.

would you accept a PR if i provided a configuration that could be run in GH actions? and/or with all the source reformatted?

williballenthin, 2021-02-08:
alternatively, please close out this issue if it will not be addressed.

rakuy0, 2021-02-08:
I agree that it's a good time to reformat things. And I would definitely accept a PR for something to be run in github actions to yell about formatting.

I'm undecided on bluntly have it refactor everything all at once, but I definitely want  to have it scream about making formatting/imports all look the same.

atlas0fd00m, 2021-02-08:
problem with reformatting everything is that the API's will change.

williballenthin, 2021-02-08:
@atlas0fd00m can you clarify what you mean? neither `black` nor `isort` will change the semantics or symbols of a program, but they will reformat the layout of text on/across lines.

williballenthin, 2021-02-08:
> I'm undecided on bluntly have it refactor everything all at once

understood, though with the recent merge of a 45k line PR across almost every file, it seemed now might be a ripe time to do wide ranging cleanup.

atlas0fd00m, 2021-02-09:
sorry, brainfart.
i was referring to a previous conversation about camel-case versus snake-case, and i thought i was tied into this discussion.  my bad.

rakuy0, 2021-02-10:
@williballenthin -- Ehh, it's more that I've never been particularly in love with how black formats code (having used it on previous projects). But that's a personal preference that I need to set aside since having an autoformatter is more important. It's not awful, I'm just picky.

I'll go merge #356  unless you have more you want to put in there?

williballenthin, 2021-02-10:
the action is simply going to fail if the format doesn't match what `black`/`isort` produces. therefore, you'll probably want to do a big reformat. i guess you could reconfigure it to warn, not fail, though i'm don't know how to limit its inspection to just a specific diff, so that probably wont be very helpful either.

rakuy0, 2021-02-11:
I'm okay with it failing, but yea. I'll throw up a big reformat later once all the current active branches (the latest 4) are merged in.

williballenthin, 2021-02-11:
sounds great, thank you!

Thread 296 (2020-07-24):

i386: incorrect disassembly for `6A FF`

williballenthin, 2020-07-24:
for intel x86/64, `6A FF` should be decoded to `push 0xFFFFFFFF[FFFFFFFF]`; however, its currently decoded to `push 0xFF`

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

originally identified here: https://github.com/fireeye/capa-rules/issues/49#issuecomment-663288748

i can provide a test case once i get a handle on this bug. i figure the relevant line is here: https://github.com/vivisect/vivisect/blob/master/envi/archs/i386/opcode86.py#L121

williballenthin, 2020-07-24:
i *think* we're dealing with this case:
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
https://www.intel.com/content/dam/www/public/us/en/documents/manuals/64-ia-32-architectures-software-developer-instruction-set-reference-manual-325383.pdf

rakuy0, 2020-07-24:
Ah. Yea. That's my copy of the manual says. The instruction declares that operand as a 8 bit value, but the intel manual sneaks in: `If the source operand is an immediate of size less than the operand size, a sign-extended value is pushed on the stack.`

So that line needs an OP_SIGNED and the decoder needs some other tweaks to better handle operand sizes for that. I should have something up by early next week to deal with this.

williballenthin, 2020-07-24:
awesome, thanks!

williballenthin, 2020-07-27:
thank you!

Closed 2020-07-27.

Thread 322 (2020-10-02):

vivisect 0.1.0 loops indefinitely

ankhazam, 2020-10-02:
Hi, while using flare-capa 1.3.0 (which uses vivisect 0.1.0) vivisect gets stuck on generating workspace (via viv-utils) for the attached file
[xonotic.zip](https://github.com/vivisect/vivisect/files/5317777/xonotic.zip)
Is there a way to prevent this from happening or introduces a timeout when vivisect aborts the analysis?

Killing the process gives the following stack-trace:
`Traceback (most recent call last):
  File "/usr/local/bin/capa", line 8, in <module>
    sys.exit(main())
  File "/usr/local/lib/python2.7/site-packages/capa/main.py", line 563, in main
    extractor = get_extractor(args.sample, args.format, disable_progress=args.quiet)
  File "/usr/local/lib/python2.7/site-packages/capa/main.py", line 309, in get_extractor
    return get_extractor_py2(path, format, disable_progress=disable_progress)
  File "/usr/local/lib/python2.7/site-packages/capa/main.py", line 282, in get_extractor_py2
    vw = get_workspace(path, format, should_save=False)
  File "/usr/local/lib/python2.7/site-packages/capa/main.py", line 267, in get_workspace
    vw = viv_utils.getWorkspace(path, should_save=should_save)
  File "/usr/local/lib/python2.7/site-packages/viv_utils/__init__.py", line 88, in getWorkspace
    vw.analyze()
  File "/usr/local/lib/python2.7/site-packages/vivisect/__init__.py", line 721, in analyze
    mod.analyze(self)
  File "/usr/local/lib/python2.7/site-packages/vivisect/analysis/generic/entrypoints.py", line 8, in analyze
    vw.processEntryPoints()
  File "/usr/local/lib/python2.7/site-packages/vivisect/__init__.py", line 705, in processEntryPoints
    self.makeFunction(eva)
  File "/usr/local/lib/python2.7/site-packages/vivisect/__init__.py", line 1406, in makeFunction
    realfva = self.cfctx.addEntryPoint(va, arch=arch)
  File "/usr/local/lib/python2.7/site-packages/envi/codeflow.py", line 278, in addEntryPoint
    calls_from = self.addCodeFlow(va, arch=arch)
  File "/usr/local/lib/python2.7/site-packages/envi/codeflow.py", line 254, in addCodeFlow
    self.addEntryPoint(fva, arch=arch)
  File "/usr/local/lib/python2.7/site-packages/envi/codeflow.py", line 278, in addEntryPoint
    calls_from = self.addCodeFlow(va, arch=arch)
  File "/usr/local/lib/python2.7/site-packages/envi/codeflow.py", line 254, in addCodeFlow
    self.addEntryPoint(fva, arch=arch)
  File "/usr/local/lib/python2.7/site-packages/envi/codeflow.py", line 278, in addEntryPoint
    calls_from = self.addCodeFlow(va, arch=arch)
  File "/usr/local/lib/python2.7/site-packages/envi/codeflow.py", line 254, in addCodeFlow
    self.addEntryPoint(fva, arch=arch)
  File "/usr/local/lib/python2.7/site-packages/envi/codeflow.py", line 278, in addEntryPoint
    calls_from = self.addCodeFlow(va, arch=arch)
  File "/usr/local/lib/python2.7/site-packages/envi/codeflow.py", line 254, in addCodeFlow
    self.addEntryPoint(fva, arch=arch)
  File "/usr/local/lib/python2.7/site-packages/envi/codeflow.py", line 278, in addEntryPoint
    calls_from = self.addCodeFlow(va, arch=arch)
  File "/usr/local/lib/python2.7/site-packages/envi/codeflow.py", line 254, in addCodeFlow
    self.addEntryPoint(fva, arch=arch)
  File "/usr/local/lib/python2.7/site-packages/envi/codeflow.py", line 284, in addEntryPoint
    self._cb_function(va, {'CallsFrom': calls_from})
  File "/usr/local/lib/python2.7/site-packages/vivisect/base.py", line 751, in _cb_function
    vw.analyzeFunction(fva)
  File "/usr/local/lib/python2.7/site-packages/vivisect/__init__.py", line 734, in analyzeFunction
    fmod.analyzeFunction(self, fva)
  File "/usr/local/lib/python2.7/site-packages/vivisect/analysis/amd64/emulation.py", line 127, in analyzeFunction
    emu.runFunction(fva, maxhit=1)
  File "/usr/local/lib/python2.7/site-packages/vivisect/impemu/emulator.py", line 386, in runFunction
    iscall = self.checkCall(starteip, endeip, op)
  File "/usr/local/lib/python2.7/site-packages/vivisect/impemu/emulator.py", line 188, in checkCall
    ret = self.emumon.apicall(self, op, endeip, api, argv)
  File "/usr/local/lib/python2.7/site-packages/vivisect/impemu/monitor.py", line 211, in apicall
    self.vw.makeFunction(pc, arch=op.iflags & envi.ARCH_MASK)
  File "/usr/local/lib/python2.7/site-packages/vivisect/__init__.py", line 1406, in makeFunction
    realfva = self.cfctx.addEntryPoint(va, arch=arch)
  File "/usr/local/lib/python2.7/site-packages/envi/codeflow.py", line 278, in addEntryPoint
    calls_from = self.addCodeFlow(va, arch=arch)
  File "/usr/local/lib/python2.7/site-packages/envi/codeflow.py", line 254, in addCodeFlow
    self.addEntryPoint(fva, arch=arch)
  File "/usr/local/lib/python2.7/site-packages/envi/codeflow.py", line 278, in addEntryPoint
    calls_from = self.addCodeFlow(va, arch=arch)
  File "/usr/local/lib/python2.7/site-packages/envi/codeflow.py", line 254, in addCodeFlow
    self.addEntryPoint(fva, arch=arch)
  File "/usr/local/lib/python2.7/site-packages/envi/codeflow.py", line 278, in addEntryPoint
    calls_from = self.addCodeFlow(va, arch=arch)
  File "/usr/local/lib/python2.7/site-packages/envi/codeflow.py", line 254, in addCodeFlow
    self.addEntryPoint(fva, arch=arch)
  File "/usr/local/lib/python2.7/site-packages/envi/codeflow.py", line 278, in addEntryPoint
    calls_from = self.addCodeFlow(va, arch=arch)
  File "/usr/local/lib/python2.7/site-packages/envi/codeflow.py", line 254, in addCodeFlow
    self.addEntryPoint(fva, arch=arch)
  File "/usr/local/lib/python2.7/site-packages/envi/codeflow.py", line 278, in addEntryPoint
    calls_from = self.addCodeFlow(va, arch=arch)
  File "/usr/local/lib/python2.7/site-packages/envi/codeflow.py", line 254, in addCodeFlow
    self.addEntryPoint(fva, arch=arch)
  File "/usr/local/lib/python2.7/site-packages/envi/codeflow.py", line 284, in addEntryPoint
    self._cb_function(va, {'CallsFrom': calls_from})
  File "/usr/local/lib/python2.7/site-packages/vivisect/base.py", line 751, in _cb_function
    vw.analyzeFunction(fva)
  File "/usr/local/lib/python2.7/site-packages/vivisect/__init__.py", line 734, in analyzeFunction
    fmod.analyzeFunction(self, fva)
  File "/usr/local/lib/python2.7/site-packages/vivisect/analysis/amd64/emulation.py", line 127, in analyzeFunction
    emu.runFunction(fva, maxhit=1)
  File "/usr/local/lib/python2.7/site-packages/vivisect/impemu/emulator.py", line 386, in runFunction
    iscall = self.checkCall(starteip, endeip, op)
  File "/usr/local/lib/python2.7/site-packages/vivisect/impemu/emulator.py", line 188, in checkCall
    ret = self.emumon.apicall(self, op, endeip, api, argv)
  File "/usr/local/lib/python2.7/site-packages/vivisect/impemu/monitor.py", line 211, in apicall
    self.vw.makeFunction(pc, arch=op.iflags & envi.ARCH_MASK)
  File "/usr/local/lib/python2.7/site-packages/vivisect/__init__.py", line 1406, in makeFunction
    realfva = self.cfctx.addEntryPoint(va, arch=arch)
  File "/usr/local/lib/python2.7/site-packages/envi/codeflow.py", line 278, in addEntryPoint
    calls_from = self.addCodeFlow(va, arch=arch)
  File "/usr/local/lib/python2.7/site-packages/envi/codeflow.py", line 254, in addCodeFlow
    self.addEntryPoint(fva, arch=arch)
  File "/usr/local/lib/python2.7/site-packages/envi/codeflow.py", line 278, in addEntryPoint
    calls_from = self.addCodeFlow(va, arch=arch)
  File "/usr/local/lib/python2.7/site-packages/envi/codeflow.py", line 254, in addCodeFlow
    self.addEntryPoint(fva, arch=arch)
  File "/usr/local/lib/python2.7/site-packages/envi/codeflow.py", line 278, in addEntryPoint
    calls_from = self.addCodeFlow(va, arch=arch)
  File "/usr/local/lib/python2.7/site-packages/envi/codeflow.py", line 254, in addCodeFlow
    self.addEntryPoint(fva, arch=arch)
  File "/usr/local/lib/python2.7/site-packages/envi/codeflow.py", line 278, in addEntryPoint
    calls_from = self.addCodeFlow(va, arch=arch)
  File "/usr/local/lib/python2.7/site-packages/envi/codeflow.py", line 254, in addCodeFlow
    self.addEntryPoint(fva, arch=arch)
  File "/usr/local/lib/python2.7/site-packages/envi/codeflow.py", line 278, in addEntryPoint
    calls_from = self.addCodeFlow(va, arch=arch)
  File "/usr/local/lib/python2.7/site-packages/envi/codeflow.py", line 254, in addCodeFlow
    self.addEntryPoint(fva, arch=arch)
  File "/usr/local/lib/python2.7/site-packages/envi/codeflow.py", line 278, in addEntryPoint
    calls_from = self.addCodeFlow(va, arch=arch)
  File "/usr/local/lib/python2.7/site-packages/envi/codeflow.py", line 254, in addCodeFlow
    self.addEntryPoint(fva, arch=arch)
  File "/usr/local/lib/python2.7/site-packages/envi/codeflow.py", line 278, in addEntryPoint
    calls_from = self.addCodeFlow(va, arch=arch)
  File "/usr/local/lib/python2.7/site-packages/envi/codeflow.py", line 254, in addCodeFlow
    self.addEntryPoint(fva, arch=arch)
  File "/usr/local/lib/python2.7/site-packages/envi/codeflow.py", line 278, in addEntryPoint
    calls_from = self.addCodeFlow(va, arch=arch)
  File "/usr/local/lib/python2.7/site-packages/envi/codeflow.py", line 254, in addCodeFlow
    self.addEntryPoint(fva, arch=arch)
  File "/usr/local/lib/python2.7/site-packages/envi/codeflow.py", line 278, in addEntryPoint
    calls_from = self.addCodeFlow(va, arch=arch)
  File "/usr/local/lib/python2.7/site-packages/envi/codeflow.py", line 254, in addCodeFlow
    self.addEntryPoint(fva, arch=arch)
  File "/usr/local/lib/python2.7/site-packages/envi/codeflow.py", line 278, in addEntryPoint
    calls_from = self.addCodeFlow(va, arch=arch)
  File "/usr/local/lib/python2.7/site-packages/envi/codeflow.py", line 254, in addCodeFlow
    self.addEntryPoint(fva, arch=arch)
  File "/usr/local/lib/python2.7/site-packages/envi/codeflow.py", line 278, in addEntryPoint
    calls_from = self.addCodeFlow(va, arch=arch)
  File "/usr/local/lib/python2.7/site-packages/envi/codeflow.py", line 254, in addCodeFlow
    self.addEntryPoint(fva, arch=arch)
  File "/usr/local/lib/python2.7/site-packages/envi/codeflow.py", line 278, in addEntryPoint
    calls_from = self.addCodeFlow(va, arch=arch)
  File "/usr/local/lib/python2.7/site-packages/envi/codeflow.py", line 254, in addCodeFlow
    self.addEntryPoint(fva, arch=arch)
  File "/usr/local/lib/python2.7/site-packages/envi/codeflow.py", line 278, in addEntryPoint
    calls_from = self.addCodeFlow(va, arch=arch)
  File "/usr/local/lib/python2.7/site-packages/envi/codeflow.py", line 254, in addCodeFlow
    self.addEntryPoint(fva, arch=arch)
  File "/usr/local/lib/python2.7/site-packages/envi/codeflow.py", line 278, in addEntryPoint
    calls_from = self.addCodeFlow(va, arch=arch)
  File "/usr/local/lib/python2.7/site-packages/envi/codeflow.py", line 254, in addCodeFlow
    self.addEntryPoint(fva, arch=arch)
  File "/usr/local/lib/python2.7/site-packages/envi/codeflow.py", line 278, in addEntryPoint
    calls_from = self.addCodeFlow(va, arch=arch)
  File "/usr/local/lib/python2.7/site-packages/envi/codeflow.py", line 254, in addCodeFlow
    self.addEntryPoint(fva, arch=arch)
  File "/usr/local/lib/python2.7/site-packages/envi/codeflow.py", line 278, in addEntryPoint
    calls_from = self.addCodeFlow(va, arch=arch)
  File "/usr/local/lib/python2.7/site-packages/envi/codeflow.py", line 254, in addCodeFlow
    self.addEntryPoint(fva, arch=arch)
  File "/usr/local/lib/python2.7/site-packages/envi/codeflow.py", line 278, in addEntryPoint
    calls_from = self.addCodeFlow(va, arch=arch)
  File "/usr/local/lib/python2.7/site-packages/envi/codeflow.py", line 254, in addCodeFlow
    self.addEntryPoint(fva, arch=arch)
  File "/usr/local/lib/python2.7/site-packages/envi/codeflow.py", line 284, in addEntryPoint
    self._cb_function(va, {'CallsFrom': calls_from})
  File "/usr/local/lib/python2.7/site-packages/vivisect/base.py", line 751, in _cb_function
    vw.analyzeFunction(fva)
  File "/usr/local/lib/python2.7/site-packages/vivisect/__init__.py", line 734, in analyzeFunction
    fmod.analyzeFunction(self, fva)
  File "/usr/local/lib/python2.7/site-packages/vivisect/analysis/amd64/emulation.py", line 127, in analyzeFunction
    emu.runFunction(fva, maxhit=1)
  File "/usr/local/lib/python2.7/site-packages/vivisect/impemu/emulator.py", line 386, in runFunction
    iscall = self.checkCall(starteip, endeip, op)
  File "/usr/local/lib/python2.7/site-packages/vivisect/impemu/emulator.py", line 188, in checkCall
    ret = self.emumon.apicall(self, op, endeip, api, argv)
  File "/usr/local/lib/python2.7/site-packages/vivisect/impemu/monitor.py", line 211, in apicall
    self.vw.makeFunction(pc, arch=op.iflags & envi.ARCH_MASK)
  File "/usr/local/lib/python2.7/site-packages/vivisect/__init__.py", line 1406, in makeFunction
    realfva = self.cfctx.addEntryPoint(va, arch=arch)
  File "/usr/local/lib/python2.7/site-packages/envi/codeflow.py", line 284, in addEntryPoint
    self._cb_function(va, {'CallsFrom': calls_from})
  File "/usr/local/lib/python2.7/site-packages/vivisect/base.py", line 751, in _cb_function
    vw.analyzeFunction(fva)
  File "/usr/local/lib/python2.7/site-packages/vivisect/__init__.py", line 734, in analyzeFunction
    fmod.analyzeFunction(self, fva)
  File "/usr/local/lib/python2.7/site-packages/vivisect/analysis/amd64/emulation.py", line 127, in analyzeFunction
    emu.runFunction(fva, maxhit=1)
  File "/usr/local/lib/python2.7/site-packages/vivisect/impemu/emulator.py", line 370, in runFunction
    self.executeOpcode(op)
  File "/usr/local/lib/python2.7/site-packages/envi/archs/i386/emu.py", line 228, in executeOpcode
    newpc = meth(op)
  File "/usr/local/lib/python2.7/site-packages/envi/archs/i386/emu.py", line 491, in i_add
    self.setOperValue(op, 0, ures)
  File "/usr/local/lib/python2.7/site-packages/envi/__init__.py", line 673, in setOperValue
    return oper.setOperValue(op, self, value)
  File "/usr/local/lib/python2.7/site-packages/envi/archs/i386/disasm.py", line 297, in setOperValue
    emu.writeMemValue(self.getOperAddr(op, emu), val, self.tsize)
  File "/usr/local/lib/python2.7/site-packages/envi/archs/i386/emu.py", line 205, in writeMemValue
    self.writeMemory(addr, bytes)
  File "/usr/local/lib/python2.7/site-packages/vivisect/impemu/emulator.py", line 587, in writeMemory
    return e_mem.MemoryObject.writeMemory(self, va, bytes)
  File "/usr/local/lib/python2.7/site-packages/envi/memory.py", line 472, in writeMemory
    mapdef[3] = mbytes[:offset] + bytes + mbytes[offset+len(bytes):]
KeyboardInterrupt`

rakuy0, 2020-10-02:
Ah. Fun. I think I know what this is doing. The emulator is running off into lalaland and just spinning through a bunch of bad bytes. Typically when this happens there's some edge case that we just haven't had a chance to take into account, so I'll go over this and see what's missing.

Thanks for sharing the binary! Makes fixing this a lot easier. Do you mind if I end up incorporating this into our unittests?

ankhazam, 2020-10-02:
Hey,
thanks for the fast response.
As for the binary, I don't mind. Don't know bout the owners though ;)
I've grabbed it from: https://www.xonotic.org/
BR,
Ank

rakuy0, 2021-02-02:
Should be fixed in v0.2.0

Closed 2021-02-02.

Thread 325 (2020-10-05):

Vivisect Patching API

atlas0fd00m, 2020-10-05:
Vivisect is powerful for analysis modules and fast solutions.  arguably it's greatest superpowers are symboliks, emulation, and ease of developing analysis modules.

make an easy api for Vivisect to be used for patching binaries, without having to consider `addbase`

atlas0fd00m, 2020-10-13:
woops.  i thought the first one failed to create.

Thread 348 (2021-02-02):

switch table regression in v0.2.0

williballenthin, 2021-02-02:
During upgrade of vivisect in capa, we found that one of our [test cases newly failed](https://github.com/fireeye/capa/pull/413). We traced this to a regression in vivisect's switch case analysis released with v0.2.0.

to reproduce:

[mimikatz.exe](https://github.com/fireeye/capa-testfiles/blob/master/mimikatz.exe_) (32-bit)
function: 0x0046d6ce
indirect jump at: 0x46D7D8
*want* to see instructions recognized at addresses: 0x46D9CA, 0x46D7DF, and 0x46DA23

in v0.1.0, vivisect successfully explored many instructions following this indirect jump. in v0.2.0, vivisect is stymied.

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

williballenthin, 2021-02-02:
this is probably a blocking issue for us before we upgrade capa to use viv v0.2.x.

rakuy0, 2021-02-03:
Probably. I'm triaging it now. I can easily replicate it, which is nice. I'll ping you when I put up a PR for it.

Ana06, 2021-02-10:
It seems this is fixed in master with Python 3: https://github.com/fireeye/capa/pull/421

williballenthin, 2021-03-03:
@rakuy0  can we get one last v0.2.1 on the py2 branch to address this? capa is migrating to py3 after one final minor release that should incorporate this fix, so i don't expect we'll have further requests for the py2 branch beyond this.

rakuy0, 2021-03-04:
Yea, juuuust threw up a branch. Just needed a bit of time to get back to it since I've been swamped recently.

rakuy0, 2021-03-07:
@williballenthin @Ana06 0.2.1 should be up on pypi. Let me know if it works for you.

Ana06, 2021-03-08:
It does, thanks @rakuy0!

williballenthin, 2021-03-08:
thank you @rakuy0 !

Closed 2021-03-07.

Thread 349 (2021-02-04):

-c/--config option CLI option does not work

sprout42, 2021-02-04:
I was trying to figure out why I couldn't get a vivisect configuration file created and discovered that the `--config` command line option does not save the argument as a string (https://github.com/vivisect/vivisect/blob/master/vivisect/vivbin.py#L52)
```
$ python -m vivisect.vivbin -c ~/.viv -a
Traceback (most recent call last):
  File "/Users/user/.pyenv/versions/3.8.2/bin/vivbin", line 11, in <module>
    load_entry_point('vivisect==0.2.0', 'console_scripts', 'vivbin')()
  File "/Users/user/.pyenv/versions/3.8.2/Python.framework/Versions/3.8/lib/python3.8/site-packages/vivisect/vivbin.py", line 59, in main
    vw = viv_cli.VivCli(confdir=args.config, autosave=args.autosave)
  File "/Users/user/.pyenv/versions/3.8.2/Python.framework/Versions/3.8/lib/python3.8/site-packages/vivisect/cli.py", line 53, in __init__
    vivisect.VivWorkspace.__init__(self, **kwargs)
  File "/Users/user/.pyenv/versions/3.8.2/Python.framework/Versions/3.8/lib/python3.8/site-packages/vivisect/__init__.py", line 81, in __init__
    self.vivhome = os.path.abspath(cfgdir)
  File "/Users/user/.pyenv/versions/3.8.2/Python.framework/Versions/3.8/lib/python3.8/posixpath.py", line 374, in abspath
    path = os.fspath(path)
TypeError: expected str, bytes or os.PathLike object, not bool
```

rakuy0, 2021-02-04:
Thanks! Should be easy to fix. I'll have it up after I deal with #348 , which I'm waist deep in right now.

Closed 2021-03-08.

Thread 350 (2021-02-04):

default config not created in python3

sprout42, 2021-02-04:
I'm trying out the latest python 3 changes and found if I don't have a config file already, a new one doesn't get created even when I add the `--autosave` CLI option.  If I add
```
if self.autosave:
    self.saveConfigFile()
```
to the end of the `envi.config.EnviConfig` class constructor it will save the default values into a config for me, but I'm not sure if this is what the autosave command option is meant to do.

I also had to change the file mode in `EnviConfig.saveConfigFile()` function to be "w" instead of "wb".

```
$ ls ~/.viv
ls: .viv: No such file or directory
$ python -m vivisect.vivbin -a
$ ls ~/.viv/
viv.json
```

Here is a diff of the changes I made:
```
diff --git a/envi/config.py b/envi/config.py
index 886861c..dc74000 100644
--- a/envi/config.py
+++ b/envi/config.py
@@ -67,6 +67,9 @@ class EnviConfig:
         if docs is not None:
             self.setDocsPrimitive(docs)

+        if self.autosave:
+            self.saveConfigFile()
+
     def getOptionDoc(self, optname):
         '''
         Retrieve docs about the given option if present.
@@ -219,7 +222,7 @@ class EnviConfig:
             filename = self.filename

         cfgdict = self.getConfigPrimitive()
-        with open(filename, 'wb') as fd:
+        with open(filename, 'w') as fd:
             json.dump(cfgdict, fd, indent=2)

     def loadConfigFile(self, filename=None):
```

rakuy0, 2021-02-04:
So autosave (originally) would only save config options on change. So if nothing deviates from the defaults, nothing should get written (as there's no need as of yet to write the file out). There was an ask a while ago to make it so that the .viv directory wouldn't get automagically generated (PR #310 ). So unless autosave is on and someone has changed a config option, the config file shouldn't get generated unless a save is explicitly requested. But we should expose something to make that a little easier.

As for the `wb` -> `w` stuff, if you just left it as the `wb` version, does it error out? Or does it just produce garbage? In either case, I'm open to switching that up (I can do it or you can throw up a PR for it, just lemme know). I'm more just curious what's happening.

But Overall, the config stuff hasn't been touched in a while. It's kinda become a second class citizen now since we've been focusing so much on getting analysis more correct.

sprout42, 2021-02-04:
if I don't do the `wb`->`w` change I get this error when trying to save the config:
```
Traceback (most recent call last):
  File "/Users/user/.pyenv/versions/3.8.2/Python.framework/Versions/3.8/lib/python3.8/runpy.py", line 193, in _run_module_as_main
    return _run_code(code, main_globals, None,
  File "/Users/user/.pyenv/versions/3.8.2/Python.framework/Versions/3.8/lib/python3.8/runpy.py", line 86, in _run_code
    exec(code, run_globals)
  File "/Users/user/.local/src/vivisect/vivisect/vivbin.py", line 150, in <module>
    main()
  File "/Users/user/.local/src/vivisect/vivisect/vivbin.py", line 59, in main
    vw = viv_cli.VivCli(confdir=args.config, autosave=args.autosave)
  File "/Users/user/.local/src/vivisect/vivisect/cli.py", line 53, in __init__
    vivisect.VivWorkspace.__init__(self, **kwargs)
  File "/Users/user/.local/src/vivisect/vivisect/__init__.py", line 97, in __init__
    self.config = e_config.EnviConfig(filename=cfgpath, defaults=defconfig, docs=docconfig, autosave=autosave)
  File "/Users/user/.local/src/vivisect/envi/config.py", line 71, in __init__
    self.saveConfigFile()
  File "/Users/user/.local/src/vivisect/envi/config.py", line 226, in saveConfigFile
    json.dump(cfgdict, fd, indent=2)
  File "/Users/user/.pyenv/versions/3.8.2/Python.framework/Versions/3.8/lib/python3.8/json/__init__.py", line 180, in dump
    fp.write(chunk)
TypeError: a bytes-like object is required, not 'str'
```
I suppose the `EnviConfig.loadConfigFile()` function needs similar changes.

sprout42, 2021-02-04:
Regarding the autosave functionality - is there a preferred way to get vivisect to generate a default config file?  If I don't have a configuration file then I am not sure what the preferred way to generate one is.  I have a blob file that I was trying to analyze and I couldn't figure out how to change the `baseaddr` to be 0 before running an analysis on it.

I thought that perhaps the autosave option could do it, but as I said in the issue description I wasn't sure if that is correct or not.

rakuy0, 2021-02-05:
So there's two ways to get a default config. Best way I can think of, is If you're in the UI, drop into the python REPL, and then try and call `vw.config.saveConfigFile()`.

I'm not quite sure what the best way to go about making that a little easier to use it yet, but I would like to keep it so it doesn't just autogenerate the configson startup, since we've had requests to specifically not do that in the past. But it does need to change.

And I'll wrap your bytes changes into my general bugfix branch that should be up later today. Thanks for that find!

sprout42, 2021-02-05:
Makes sense, thanks!

Closed 2022-04-29.

Thread 358 (2021-02-10):

Analysis Exception introduced with Python3 (maximum recursion depth exceeded in comparison)

Ana06, 2021-02-10:
Vivisect doesn't extract the same features for this file with the current master (Python 3) and with vivisect 0.2.0 (Python 2):
https://github.com/fireeye/capa-testfiles/blob/master/kernel32.dll_

I think it is caused by the following exception I see in the logs:
```
INFO:vivisect:Function Analysis Exception for function 0x7de00e11, module: vivisect.analysis.i386.calling
INFO:vivisect:Exception Traceback: Traceback (most recent call last):
  File "/path/vivisect/__init__.py", line 781, in analyzeFunction
    fmod.analyzeFunction(self, fva)
  File "/path/vivisect/analysis/i386/calling.py", line 142, in analyzeFunction
    emumon.addAnalysisResults(vw, emu)
  File "/path/vivisect/impemu/monitor.py", line 112, in addAnalysisResults
    reprargs = [emu.reprVivValue(val) for val in argv]
  File "/path/vivisect/impemu/monitor.py", line 112, in <listcomp>
    reprargs = [emu.reprVivValue(val) for val in argv]
  File "/path/vivisect/impemu/emulator.py", line 578, in reprVivValue
    return self.reprVivTaint(taint)
  File "/path/vivisect/impemu/emulator.py", line 548, in reprVivTaint
    argsstr = ','.join([self.reprVivValue(x) for x in argv])
  File "/path/vivisect/impemu/emulator.py", line 548, in <listcomp>
    argsstr = ','.join([self.reprVivValue(x) for x in argv])
  File "/path/vivisect/impemu/emulator.py", line 578, in reprVivValue

[...]

  File "/path/vivisect/impemu/emulator.py", line 578, in reprVivValue
    return self.reprVivTaint(taint)
  File "/path/vivisect/impemu/emulator.py", line 547, in reprVivTaint
    callstr = self.reprVivValue(pc)
  File "/path/vivisect/impemu/emulator.py", line 571, in reprVivValue
    taint = self.getVivTaint(val)
  File "/path/vivisect/impemu/emulator.py", line 510, in getVivTaint
    return self.taints.get( va & self.taintmask )
RecursionError: maximum recursion depth exceeded in comparison
```

### Steps to reproduce

```
> python 3
>>> # Enable logging
>>> import logging
>>> logging.basicConfig(level=logging.INFO)
>>>
>>> import vivisect
>>> file = 'kernel32.dll_' # https://github.com/fireeye/capa-testfiles/blob/master/kernel32.dll_
>>> vw = vivisect.VivWorkspace()
>>> vw.loadFromFile(file)
>>> vw.analyze() # Exception!
```

rakuy0, 2021-02-10:
Cool. I'm triaging this today. I'm naively hopeful my cleanup branch will address this, but I have nothing to base that on, but I will update this once I get a chance to run it.

Ana06, 2021-02-11:
I have just tried master + Py3 Cleanup (#353) + Python3 fixes (#357) and this still happens.

rakuy0, 2021-02-11:
Yea, I saw the same this morning when I tried it. Unfortunate, but I wasn't confident it would fix it. I'll dig deeper into this once I get some of the other bugfix branches merged.

rakuy0, 2021-02-12:
Oh, as with the other ticket, can you be more specific about what features are missing? That way I know what to look for once I squash this bug and can confirm things are working.

Ana06, 2021-02-12:
I have just checked again, and it seems that the feature extraction problem is solved in master + Py3 Cleanup (#353) + Python3 fixes (#357). This also means that this was not related to the exception above, because it still happens. Sorry, I should have checked both things.

Closed 2021-02-12.

Thread 359 (2021-02-11):

Analysis Exception introduced with Python3 (Attempt to get location)

Ana06, 2021-02-11:
Vivisect doesn't extract the same features for this binary with the Python 3 (master) and with Python 2 (vivisect 0.2.0):
[https://github.com/fireeye/capa-testfiles/blob/master/9ff8e68343cc29c1036650fc153e69f7.exe_](https://github.com/fireeye/capa-testfiles/blob/master/9ff8e68343cc29c1036650fc153e69f7.exe_)

I think it is caused by this exceptions I see in the logs:
```
INFO:vivisect:Function Analysis Exception for function 0x412783, module: vivisect.analysis.generic.nore
INFO:vivisect:Exception Traceback: Traceback (most recent call last):
  File "/path/vivisect/__init__.py", line 781, in analyzeFunction
    fmod.analyzeFunction(self, fva)
  File "/path/vivisect/analysis/generic/noret.py", line 31, in analyzeFunction
    g = v_t_graph.buildFunctionGraph(vw, fva)
  File "/path/vivisect/tools/graphutil.py", line 470, in buildFunctionGraph
    raise Exception("buildFunctionGraph: Attempt to get location at 0x%x" % nextva)
Exception: buildFunctionGraph: Attempt to get location at 0x4127c0
```

### Steps to reproduce

```
> python 3
>>> # Enable logging
>>> import logging
>>> logging.basicConfig(level=logging.INFO)
>>>
>>> import vivisect
>>> file = '9ff8e68343cc29c1036650fc153e69f7.exe_' # https://github.com/fireeye/capa-testfiles/blob/master/9ff8e68343cc29c1036650fc153e69f7.exe_
>>> vw = vivisect.VivWorkspace()
>>> vw.loadFromFile(file)
>>> vw.analyze() # Exception!
```

rakuy0, 2021-02-11:
So could you point out what features are missing or different? Maybe not all of them, but if you could point out a couple, that would go a long way in helping us track down what changed.

But that exception message may (or may not, it depends) be a red herring in that it does happen from time to time in terms when trying to determine if a function is no-return. It is still something we need to fix, but I'd hesitate to say that that message is the definitive cause of the missing features (because that message has appeared in both py2 and py3).

Ana06, 2021-02-12:
Similarly as with https://github.com/vivisect/vivisect/issues/358, this is also fixed in current master + Py3 Cleanup #353 + Python3 fixes #357.

> but I'd hesitate to say that that message is the definitive cause of the missing features (because that message has appeared in both py2 and py3).

You are right that this message appeared in py2:
```
Function Analysis Exception for 0x4096f8 vivisect.analysis.generic.noret: buildFunctionGraph: Attempt to get location at 0x409791
Function Analysis Exception for 0x42b550 vivisect.analysis.generic.noret: buildFunctionGraph: Attempt to get location at 0x42b5ce
Function Analysis Exception for 0x43d5d0 vivisect.analysis.generic.noret: buildFunctionGraph: Attempt to get location at 0x43d5f3
Function Analysis Exception for 0x409788 vivisect.analysis.generic.noret: buildFunctionGraph: Attempt to get location at 0x409791
Function Analysis Exception for 0x42bb28 vivisect.analysis.generic.noret: buildFunctionGraph: Attempt to get location at 0x42bb2e
Function Analysis Exception for 0x401408 vivisect.analysis.generic.noret: buildFunctionGraph: Attempt to get location at 0x4014c5
Function Analysis Exception for 0x447154 vivisect.analysis.generic.noret: buildFunctionGraph: Attempt to get location at 0x4471e9
```

but in py3 it appears one more time:
`Exception: buildFunctionGraph: Attempt to get location at 0x4127c0`

Closed 2021-02-12.

Thread 363 (2021-02-17):

Python2 .viv files are not compatible with Python3

Ana06, 2021-02-17:
Calling `loadWorkspace` using an old `.viv` file generated by vivisect 0.2.0 (Python2) with current master (Python3) raises the following error:
```
  File "/path/vivisect/__init__.py", line 262, in loadWorkspace
    mod.loadWorkspace(self, wsname)
  File "/path/vivisect/storage/basicfile.py", line 57, in loadWorkspace
    events = vivEventsFromFile(filename)
  File "/path/vivisect/storage/basicfile.py", line 47, in vivEventsFromFile
    events.extend(pickle.load(f))
UnicodeDecodeError: 'ascii' codec can't decode byte 0x90 in position 2: ordinal not in range(128)
```

I think this is caused by Python3 default encoding being UTF-8, while it is ASCII for Python2. This could be a problem for applications relaying in the compatibility of .viv files. It may be a good idea to continue storing `.viv` files in ASCII or to provide a compatibility option. Otherwise the next release should document this breaking change.

rakuy0, 2021-02-17:
So...this is a compatibility thing caused by python's pickle module. I can try later to see if encoding='latin1' or something else works, but as a failsafe measure I also plumbed `vivisect/storage/mpfile.py`, as a compatibility option for 2 to 3 (it's msgpack based instead of pickle).

But yes this is on my list of things to document for the release. I just have to devote most of my time this month to contract work, which is why I haven't been able to do any of the last fiddly bits for a release yet.

So until @atlas0fd00m or I can get around to seeing if we can pickle to work across 2/3, can you give the msgpack module a whirl and see if it works for you? You should be able to invoke it from vivbin via `python -m vivisect.vivbin -s vivisect.storage.mpfile`.

rakuy0, 2021-04-06:
So with the migration scripts and what not, @Ana06 do those help alleviate this?

Ana06, 2021-04-07:
We decided in the end not to support compatibility between Python2 and Python3 `.viv` files. We have documented it and we raise an `IncompatibleVivVersion`: https://github.com/williballenthin/viv-utils/blob/master/viv_utils/__init__.py#L70  So this can be closed if you want.

Closed 2021-04-07.

Thread 383 (2021-03-25):

New vivisect release

mr-tz, 2021-03-25:
Can you estimate when there's going to be a new release?

capa's currently blocked in multiple places and we're joyfully anticipating your fixes and improvements 😉

evandrix, 2021-03-28:
on a related note of `capa`/`vivisect`, is there any way (e.g. command-line switch parameter) to disable the creation of the extra ".viv" workspace file?

rakuy0, 2021-03-29:
@mr-tz - Aye, should be relatively soon. I'm just trying to get two last relatively important bugfix PRs into master before that  (#384 and #385). Everything else is too far in the WIP stage to consider being in the release.

@evandrix - So that's a separate issue, but vivisect doesn't automatically save the workspace to the .viv file after analysis is done, unless you're doing bulk analysis via the vivbin script, (at which point you're accepting that the workspace file will be created). I don't have specifics on how capa uses vivisect, so I would raise this question towards the capa devs.

mr-tz, 2021-03-29:
Great, thank you!

@evandrix let's discuss the workspace creation in https://github.com/fireeye/capa/issues/507

mr-tz, 2021-04-05:
Would it be a good time for a new release now with the two PRs merged?

rakuy0, 2021-04-05:
I ended up taking the weekend off to celebrate easter with my family (I actually forgot it was this last weekend until someone told me :laughing:). That, and there were two last things I wanted in for vdb/intel decodings.

Those are all in and v1.0.1 is up on pypi/tagged on github.

rakuy0, 2021-04-05:
(@Ana06 @williballenthin pinging you guys for awareness as well)

mr-tz, 2021-04-06:
Thank you very much!

Closed 2021-03-29.

Thread 414 (2021-08-09):

i386 idiv emulation faulty

atlas0fd00m, 2021-08-09:
while stepping the emulator and debugger side by side, i noticed the results of IDIV are different.

duplicate the bug here:
```
import envi.archs.i386.emu as eaie
emu = eaie.IntelEmulator()
emu.addMemoryMap(0x41414140, 7, 'foo', b'\xf7\xff')
op = emu.parseOpcode(0x41414140)

emu.setRegisterByName('eax', 0xffffffe2)
emu.setRegisterByName('edx', 0xffffffff)
emu.setRegisterByName('edi', 60)

emu.executeOpcode(op)

print("eax: ", hex(emu.getRegisterByName('eax')))
print("edx: ", hex(emu.getRegisterByName('edx')))
```

our emulator currently gives these results:
```
eax:  0xffffffff
edx:  0x1e
```

but the real processor gives:
```
eax:  0x0
edx:  0xffffffe2
```

Closed 2021-12-08.

Thread 415 (2021-08-10):

platforms/win32 broken on non-Windows platforms

williballenthin, 2021-08-10:
```
> python vivisect/vivbin.py --bulk samples/004e32a0f3610532cf08ce0ca4ee3ce2628faa0a143b732151706a8b7fda0df1                                                                    
Traceback (most recent call last):
  File "vivisect/vivbin.py", line 144, in <module>
    main()
  File "vivisect/vivbin.py", line 98, in main
    vw.loadFromFile(fname, fmtname=args.parsemod)
  File "/home/user/code/vivisect/vivisect/__init__.py", line 2724, in loadFromFile
    mod = viv_parsers.getParserModule(fmtname)
  File "/home/user/code/vivisect/vivisect/parsers/__init__.py", line 89, in getParserModule
    __import__(mname)
  File "/home/user/code/vivisect/vivisect/parsers/pe.py", line 13, in <module>
    import vtrace.platforms.win32 as vt_win32
  File "/home/user/code/vivisect/vtrace/platforms/win32.py", line 32, in <module>
    from ctypes import wintypes
  File "/usr/lib/python3.8/ctypes/wintypes.py", line 20, in <module>
    class VARIANT_BOOL(ctypes._SimpleCData):
ValueError: _type_ 'v' not supported
```

see: https://stackoverflow.com/a/63274446/87207 and https://bugs.python.org/issue16396

ultimately, as far as i can tell, `ctypes.wintypes` should not be used on anything but Windows. so, its not appropriate to be used in [vtrace.platform.win32](https://github.com/vivisect/vivisect/blob/726afe014aee77dafe745380daa293c363b3eae3/vtrace/platforms/win32.py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). we may need to revert a portion of #404 that introduced these changes. also, I'd recommend configuring CI to also run on Linux/MacOS so similar issues can be caught sooner.

rakuy0, 2021-08-10:
So our CI is already configured to run on linux. That's how it's always been. We don't (currently) run on windows/macos mostly because those are waaaay more expensive than running on a linux box, to the point we'd be blowing the time allotment we get as an open source project on just a couple PRs.

But also, I can't recreate this. And looking at our CI logs, neither can it. So can you give us a few details  about what versions of vivisect and python you're running under? I'm on python3.9 and ubuntu 18.04 and I can't recreate this at all.

williballenthin, 2021-08-10:
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

williballenthin, 2021-08-10:
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

rakuy0, 2021-08-10:
Yea. I see it now on 3.8.5. I like making sure that I can also reproduce issues like this in case it pops up again.

The other thing that I'd like to confirm is that unit tests still pass on windows. Can you confirm that your branch still passes the unit tests on windows? If yes, then I'll update your branch and merge it along with a couple others, since I know there's some dependency's between them.

williballenthin, 2021-08-10:
see #430. let me do a test case diff with my PR and then you decide if to merge.

williballenthin, 2021-08-11:
PR #416 shows the same test behavior as master, no regressions.

```
(env) PS C:\Users\user\Downloads\vivisect> git log -1
commit a9230c69199f7f5d0c3946480cdc0da3614734f7 (HEAD -> fix-415)
Author: William Ballenthin <william.ballenthin@fireeye.com>
Date:   Mon Aug 9 19:33:06 2021 -0600

    win32: remove wintypes import

    closes #415
(env) PS C:\Users\user\Downloads\vivisect> python -V
Python 3.8.5

======================================================================
ERROR: test_cobra_proxy (cobra.tests.testbasic.CobraBasicTest)
----------------------------------------------------------------------
Traceback (most recent call last):
  File "C:\Users\user\Downloads\vivisect\cobra\tests\testbasic.py", line 21, in test_cobra_proxy
    daemon = cobra.CobraDaemon(port=60600)
  File "C:\Users\user\Downloads\vivisect\cobra\__init__.py", line 512, in __init__
    ThreadingTCPServer.__init__(self, (host, port), CobraRequestHandler)
  File "c:\users\user\appdata\local\programs\python\python38\lib\socketserver.py", line 452, in __init__
    self.server_bind()
  File "c:\users\user\appdata\local\programs\python\python38\lib\socketserver.py", line 466, in server_bind
    self.socket.bind(self.server_address)
OSError: [WinError 10013] An attempt was made to access a socket in a way forbidden by its access permissions
    self._target(*self._args, **self._kwargs)

======================================================================
  File "C:\Users\user\Downloads\vivisect\vtrace\platforms\base.py", line 177, in _doWait
ERROR: test_cobra_newobj (cobra.tests.testnewobj.CobraNewObjTest)
----------------------------------------------------------------------
    self.platformProcessEvent(event)
Traceback (most recent call last):
  File "C:\Users\user\Downloads\vivisect\cobra\tests\testnewobj.py", line 18, in test_cobra_newobj
    daemon = cobra.CobraDaemon(port=60500, msgpack=True)
  File "C:\Users\user\Downloads\vivisect\cobra\__init__.py", line 512, in __init__
    ThreadingTCPServer.__init__(self, (host, port), CobraRequestHandler)
  File "c:\users\user\appdata\local\programs\python\python38\lib\socketserver.py", line 452, in __init__
    self.server_bind()
  File "c:\users\user\appdata\local\programs\python\python38\lib\socketserver.py", line 466, in server_bind
    self.socket.bind(self.server_address)
OSError: [WinError 10013] An attempt was made to access a socket in a way forbidden by its access permissions
  File "C:\Users\user\Downloads\vivisect\vtrace\platforms\win32.py", line 1684, in platformProcessEvent

======================================================================
ERROR: test_emu_lockstep (envi.tests.test_emu_lockstep.LockStepTest)
----------------------------------------------------------------------
Traceback (most recent call last):
  File "C:\Users\user\Downloads\vivisect\vtrace\tests\__init__.py", line 31, in tearDown
    self.trace.run()
  File "C:\Users\user\Downloads\vivisect\vtrace\__init__.py", line 283, in run
    self.wait()
  File "C:\Users\user\Downloads\vivisect\vtrace\platforms\base.py", line 167, in wait
    self._doWait()
  File "C:\Users\user\Downloads\vivisect\vtrace\platforms\base.py", line 177, in _doWait
    self.platformProcessEvent(event)
  File "C:\Users\user\Downloads\vivisect\vtrace\platforms\win32.py", line 1684, in platformProcessEvent
    self.platformDetach()
  File "C:\Users\user\Downloads\vivisect\vtrace\platforms\base.py", line 890, in trfunc
    raise ret
  File "C:\Users\user\Downloads\vivisect\vtrace\platforms\base.py", line 924, in run
    queue.put(meth(*args, **kwargs))
  File "C:\Users\user\Downloads\vivisect\vtrace\platforms\win32.py", line 1440, in platformDetach
    kernel32.CloseHandle(phandle)
ctypes.ArgumentError: argument 1: <class 'TypeError'>: wrong type

    self.platformDetach()
======================================================================
  File "C:\Users\user\Downloads\vivisect\vtrace\platforms\base.py", line 890, in trfunc
ERROR: test_vdb_stalker (vdb.tests.teststalker.VdbStalkerTest)
----------------------------------------------------------------------
    raise ret
  File "C:\Users\user\Downloads\vivisect\vtrace\platforms\base.py", line 924, in run
Traceback (most recent call last):
  File "C:\Users\user\Downloads\vivisect\vdb\tests\teststalker.py", line 19, in test_vdb_stalker
    self.runUntilExit()
  File "C:\Users\user\Downloads\vivisect\vtrace\tests\__init__.py", line 62, in runUntilExit
    self.trace.run()
  File "C:\Users\user\Downloads\vivisect\vtrace\__init__.py", line 283, in run
    self.wait()
  File "C:\Users\user\Downloads\vivisect\vtrace\platforms\base.py", line 167, in wait
    self._doWait()
  File "C:\Users\user\Downloads\vivisect\vtrace\platforms\base.py", line 177, in _doWait
    self.platformProcessEvent(event)
  File "C:\Users\user\Downloads\vivisect\vtrace\platforms\win32.py", line 1684, in platformProcessEvent
    self.platformDetach()
  File "C:\Users\user\Downloads\vivisect\vtrace\platforms\base.py", line 890, in trfunc
    raise ret
  File "C:\Users\user\Downloads\vivisect\vtrace\platforms\base.py", line 924, in run
    queue.put(meth(*args, **kwargs))
  File "C:\Users\user\Downloads\vivisect\vtrace\platforms\win32.py", line 1440, in platformDetach
    kernel32.CloseHandle(phandle)
ctypes.ArgumentError: argument 1: <class 'TypeError'>: wrong type
    queue.put(meth(*args, **kwargs))
  File "C:\Users\user\Downloads\vivisect\vtrace\platforms\win32.py", line 1440, in platformDetach

======================================================================
ERROR: test_symboliks_reduce_op_and (vivisect.symboliks.tests.test_reduce.TestReduceCase)
    kernel32.CloseHandle(phandle)
ctypes.ArgumentError: argument 1: <class 'TypeError'>: wrong type
----------------------------------------------------------------------
Traceback (most recent call last):
  File "C:\Users\user\Downloads\vivisect\vivisect\symboliks\tests\test_reduce.py", line 34, in test_symboliks_reduce_op_and
    self.assertReduce('foo[5] & 0', '0')
  File "C:\Users\user\Downloads\vivisect\vivisect\symboliks\tests\test_reduce.py", line 11, in assertReduce
    sym1 = symexp(s1).reduce(foo=True)
  File "C:\Users\user\Downloads\vivisect\vivisect\symboliks\expression.py", line 40, in symexp
    return p.parseExpression(expr)
  File "C:\Users\user\Downloads\vivisect\vivisect\symboliks\expression.py", line 67, in parseExpression
    return self.astToSymboliks(a.body[0])
  File "C:\Users\user\Downloads\vivisect\vivisect\symboliks\expression.py", line 90, in astToSymboliks
    return self.astToSymboliks(a.value)
  File "C:\Users\user\Downloads\vivisect\vivisect\symboliks\expression.py", line 93, in astToSymboliks
    left = self.astToSymboliks(a.left)
  File "C:\Users\user\Downloads\vivisect\vivisect\symboliks\expression.py", line 135, in astToSymboliks
    raise Exception('Unsupported Expression (symbolik width index)')
Exception: Unsupported Expression (symbolik width index)

======================================================================
ERROR: test_mimikatz_segments (vivisect.tests.testpe.PETests)
----------------------------------------------------------------------
Traceback (most recent call last):
  File "C:\Users\user\Downloads\vivisect\vivisect\tests\testpe.py", line 501, in test_mimikatz_segments
    self.assertEqual(ans[sname][0], sva)
KeyError: '.rsrc'

======================================================================
ERROR: test_firefox_segments (vivisect.tests.testvivisect.VivisectTest)
----------------------------------------------------------------------
Traceback (most recent call last):
  File "C:\Users\user\Downloads\vivisect\vivisect\tests\testvivisect.py", line 830, in test_firefox_segments
    self.assertEqual(ans[sname][0], sva)
KeyError: '.rsrc'

======================================================================
ERROR: vqt.tests.testmenubuilder (unittest.loader._FailedTest)
----------------------------------------------------------------------
ImportError: Failed to import test module: vqt.tests.testmenubuilder
Traceback (most recent call last):
  File "c:\users\user\appdata\local\programs\python\python38\lib\unittest\loader.py", line 436, in _find_test_path
    module = self._get_module_from_name(name)
  File "c:\users\user\appdata\local\programs\python\python38\lib\unittest\loader.py", line 377, in _get_module_from_name
    __import__(name)
  File "C:\Users\user\Downloads\vivisect\vqt\tests\testmenubuilder.py", line 3, in <module>
    import vqt.menubuilder as vmb
  File "C:\Users\user\Downloads\vivisect\vqt\menubuilder.py", line 3, in <module>
    from PyQt5.QtWidgets import *
ModuleNotFoundError: No module named 'PyQt5'

======================================================================
ERROR: vstruct.qt (unittest.loader._FailedTest)
----------------------------------------------------------------------
ImportError: Failed to import test module: vstruct.qt
Traceback (most recent call last):
  File "c:\users\user\appdata\local\programs\python\python38\lib\unittest\loader.py", line 470, in _find_test_path
    package = self._get_module_from_name(name)
  File "c:\users\user\appdata\local\programs\python\python38\lib\unittest\loader.py", line 377, in _get_module_from_name
    __import__(name)
  File "C:\Users\user\Downloads\vivisect\vstruct\qt\__init__.py", line 4, in <module>
    import vqt.tree as vq_tree
  File "C:\Users\user\Downloads\vivisect\vqt\tree.py", line 1, in <module>
    from PyQt5 import QtCore
ModuleNotFoundError: No module named 'PyQt5'

======================================================================
ERROR: test_baselib (vtrace.tests.test_expressions.VtraceExpressionTest)
----------------------------------------------------------------------
Traceback (most recent call last):
  File "C:\Users\user\Downloads\vivisect\vtrace\tests\__init__.py", line 31, in tearDown
    self.trace.run()
  File "C:\Users\user\Downloads\vivisect\vtrace\__init__.py", line 283, in run
    self.wait()
  File "C:\Users\user\Downloads\vivisect\vtrace\platforms\base.py", line 167, in wait
    self._doWait()
  File "C:\Users\user\Downloads\vivisect\vtrace\platforms\base.py", line 177, in _doWait
    self.platformProcessEvent(event)
  File "C:\Users\user\Downloads\vivisect\vtrace\platforms\win32.py", line 1684, in platformProcessEvent
    self.platformDetach()
  File "C:\Users\user\Downloads\vivisect\vtrace\platforms\base.py", line 890, in trfunc
    raise ret
  File "C:\Users\user\Downloads\vivisect\vtrace\platforms\base.py", line 924, in run
    queue.put(meth(*args, **kwargs))
  File "C:\Users\user\Downloads\vivisect\vtrace\platforms\win32.py", line 1440, in platformDetach
    kernel32.CloseHandle(phandle)
ctypes.ArgumentError: argument 1: <class 'TypeError'>: wrong type

======================================================================
ERROR: test_vtrace_sym (vtrace.tests.test_expressions.VtraceExpressionTest)
----------------------------------------------------------------------
Traceback (most recent call last):
  File "C:\Users\user\Downloads\vivisect\vtrace\tests\__init__.py", line 31, in tearDown
    self.trace.run()
  File "C:\Users\user\Downloads\vivisect\vtrace\__init__.py", line 283, in run
    self.wait()
  File "C:\Users\user\Downloads\vivisect\vtrace\platforms\base.py", line 167, in wait
    self._doWait()
  File "C:\Users\user\Downloads\vivisect\vtrace\platforms\base.py", line 177, in _doWait
    self.platformProcessEvent(event)
  File "C:\Users\user\Downloads\vivisect\vtrace\platforms\win32.py", line 1684, in platformProcessEvent
    self.platformDetach()
  File "C:\Users\user\Downloads\vivisect\vtrace\platforms\base.py", line 890, in trfunc
    raise ret
  File "C:\Users\user\Downloads\vivisect\vtrace\platforms\base.py", line 924, in run
    queue.put(meth(*args, **kwargs))
  File "C:\Users\user\Downloads\vivisect\vtrace\platforms\win32.py", line 1440, in platformDetach
    kernel32.CloseHandle(phandle)
ctypes.ArgumentError: argument 1: <class 'TypeError'>: wrong type

======================================================================
ERROR: test_vtrace_breakpoint (vtrace.tests.testbasic.VtraceBasicExecTest)
----------------------------------------------------------------------
Traceback (most recent call last):
  File "C:\Users\user\Downloads\vivisect\vtrace\tests\testbasic.py", line 38, in test_vtrace_breakpoint
    self.runUntilExit()
  File "C:\Users\user\Downloads\vivisect\vtrace\tests\__init__.py", line 90, in runUntilExit
    self.trace.run()
  File "C:\Users\user\Downloads\vivisect\vtrace\__init__.py", line 283, in run
    self.wait()
  File "C:\Users\user\Downloads\vivisect\vtrace\platforms\base.py", line 167, in wait
    self._doWait()
  File "C:\Users\user\Downloads\vivisect\vtrace\platforms\base.py", line 177, in _doWait
    self.platformProcessEvent(event)
  File "C:\Users\user\Downloads\vivisect\vtrace\platforms\win32.py", line 1684, in platformProcessEvent
    self.platformDetach()
  File "C:\Users\user\Downloads\vivisect\vtrace\platforms\base.py", line 890, in trfunc
    raise ret
  File "C:\Users\user\Downloads\vivisect\vtrace\platforms\base.py", line 924, in run
    queue.put(meth(*args, **kwargs))
  File "C:\Users\user\Downloads\vivisect\vtrace\platforms\win32.py", line 1440, in platformDetach
    kernel32.CloseHandle(phandle)
ctypes.ArgumentError: argument 1: <class 'TypeError'>: wrong type

======================================================================
ERROR: test_vtrace_exename (vtrace.tests.testbasic.VtraceBasicExecTest)
----------------------------------------------------------------------
Traceback (most recent call last):
  File "C:\Users\user\Downloads\vivisect\vtrace\tests\__init__.py", line 83, in tearDown
    self.trace.run()
  File "C:\Users\user\Downloads\vivisect\vtrace\__init__.py", line 283, in run
    self.wait()
  File "C:\Users\user\Downloads\vivisect\vtrace\platforms\base.py", line 167, in wait
    self._doWait()
  File "C:\Users\user\Downloads\vivisect\vtrace\platforms\base.py", line 177, in _doWait
    self.platformProcessEvent(event)
  File "C:\Users\user\Downloads\vivisect\vtrace\platforms\win32.py", line 1684, in platformProcessEvent
    self.platformDetach()
  File "C:\Users\user\Downloads\vivisect\vtrace\platforms\base.py", line 890, in trfunc
    raise ret
  File "C:\Users\user\Downloads\vivisect\vtrace\platforms\base.py", line 924, in run
    queue.put(meth(*args, **kwargs))
  File "C:\Users\user\Downloads\vivisect\vtrace\platforms\win32.py", line 1440, in platformDetach
    kernel32.CloseHandle(phandle)
ctypes.ArgumentError: argument 1: <class 'TypeError'>: wrong type

======================================================================
ERROR: test_vtrace_getregisters (vtrace.tests.testbasic.VtraceBasicExecTest)
----------------------------------------------------------------------
Traceback (most recent call last):
  File "C:\Users\user\Downloads\vivisect\vtrace\tests\testbasic.py", line 18, in test_vtrace_getregisters
    self.runUntilExit()
  File "C:\Users\user\Downloads\vivisect\vtrace\tests\__init__.py", line 90, in runUntilExit
    self.trace.run()
  File "C:\Users\user\Downloads\vivisect\vtrace\__init__.py", line 283, in run
    self.wait()
  File "C:\Users\user\Downloads\vivisect\vtrace\platforms\base.py", line 167, in wait
    self._doWait()
  File "C:\Users\user\Downloads\vivisect\vtrace\platforms\base.py", line 177, in _doWait
    self.platformProcessEvent(event)
  File "C:\Users\user\Downloads\vivisect\vtrace\platforms\win32.py", line 1684, in platformProcessEvent
    self.platformDetach()
  File "C:\Users\user\Downloads\vivisect\vtrace\platforms\base.py", line 890, in trfunc
    raise ret
  File "C:\Users\user\Downloads\vivisect\vtrace\platforms\base.py", line 924, in run
    queue.put(meth(*args, **kwargs))
  File "C:\Users\user\Downloads\vivisect\vtrace\platforms\win32.py", line 1440, in platformDetach
    kernel32.CloseHandle(phandle)
ctypes.ArgumentError: argument 1: <class 'TypeError'>: wrong type

======================================================================
ERROR: test_vtrace_mmaps (vtrace.tests.testbasic.VtraceBasicExecTest)
----------------------------------------------------------------------
Traceback (most recent call last):
  File "C:\Users\user\Downloads\vivisect\vtrace\tests\__init__.py", line 83, in tearDown
    self.trace.run()
  File "C:\Users\user\Downloads\vivisect\vtrace\__init__.py", line 283, in run
    self.wait()
  File "C:\Users\user\Downloads\vivisect\vtrace\platforms\base.py", line 167, in wait
    self._doWait()
  File "C:\Users\user\Downloads\vivisect\vtrace\platforms\base.py", line 177, in _doWait
    self.platformProcessEvent(event)
  File "C:\Users\user\Downloads\vivisect\vtrace\platforms\win32.py", line 1684, in platformProcessEvent
    self.platformDetach()
  File "C:\Users\user\Downloads\vivisect\vtrace\platforms\base.py", line 890, in trfunc
    raise ret
  File "C:\Users\user\Downloads\vivisect\vtrace\platforms\base.py", line 924, in run
    queue.put(meth(*args, **kwargs))
  File "C:\Users\user\Downloads\vivisect\vtrace\platforms\win32.py", line 1440, in platformDetach
    kernel32.CloseHandle(phandle)
ctypes.ArgumentError: argument 1: <class 'TypeError'>: wrong type

======================================================================
ERROR: test_vtrace_setregisters (vtrace.tests.testbasic.VtraceBasicExecTest)
----------------------------------------------------------------------
Traceback (most recent call last):
  File "C:\Users\user\Downloads\vivisect\vtrace\tests\testbasic.py", line 27, in test_vtrace_setregisters
    self.runUntilExit()
  File "C:\Users\user\Downloads\vivisect\vtrace\tests\__init__.py", line 90, in runUntilExit
    self.trace.run()
  File "C:\Users\user\Downloads\vivisect\vtrace\__init__.py", line 283, in run
    self.wait()
  File "C:\Users\user\Downloads\vivisect\vtrace\platforms\base.py", line 167, in wait
    self._doWait()
  File "C:\Users\user\Downloads\vivisect\vtrace\platforms\base.py", line 177, in _doWait
    self.platformProcessEvent(event)
  File "C:\Users\user\Downloads\vivisect\vtrace\platforms\win32.py", line 1684, in platformProcessEvent
    self.platformDetach()
  File "C:\Users\user\Downloads\vivisect\vtrace\platforms\base.py", line 890, in trfunc
    raise ret
  File "C:\Users\user\Downloads\vivisect\vtrace\platforms\base.py", line 924, in run
    queue.put(meth(*args, **kwargs))
  File "C:\Users\user\Downloads\vivisect\vtrace\platforms\win32.py", line 1440, in platformDetach
    kernel32.CloseHandle(phandle)
ctypes.ArgumentError: argument 1: <class 'TypeError'>: wrong type

======================================================================
ERROR: test_vtrace_breakpoint (vtrace.tests.testbasic.VtraceBasicTest)
----------------------------------------------------------------------
Traceback (most recent call last):
  File "C:\Users\user\Downloads\vivisect\vtrace\tests\testbasic.py", line 38, in test_vtrace_breakpoint
    self.runUntilExit()
  File "C:\Users\user\Downloads\vivisect\vtrace\tests\__init__.py", line 62, in runUntilExit
    self.trace.run()
  File "C:\Users\user\Downloads\vivisect\vtrace\__init__.py", line 283, in run
    self.wait()
  File "C:\Users\user\Downloads\vivisect\vtrace\platforms\base.py", line 167, in wait
    self._doWait()
  File "C:\Users\user\Downloads\vivisect\vtrace\platforms\base.py", line 177, in _doWait
    self.platformProcessEvent(event)
  File "C:\Users\user\Downloads\vivisect\vtrace\platforms\win32.py", line 1684, in platformProcessEvent
    self.platformDetach()
  File "C:\Users\user\Downloads\vivisect\vtrace\platforms\base.py", line 890, in trfunc
    raise ret
  File "C:\Users\user\Downloads\vivisect\vtrace\platforms\base.py", line 924, in run
    queue.put(meth(*args, **kwargs))
  File "C:\Users\user\Downloads\vivisect\vtrace\platforms\win32.py", line 1440, in platformDetach
    kernel32.CloseHandle(phandle)
ctypes.ArgumentError: argument 1: <class 'TypeError'>: wrong type

======================================================================
ERROR: test_vtrace_exename (vtrace.tests.testbasic.VtraceBasicTest)
----------------------------------------------------------------------
Traceback (most recent call last):
  File "C:\Users\user\Downloads\vivisect\vtrace\tests\__init__.py", line 31, in tearDown
    self.trace.run()
  File "C:\Users\user\Downloads\vivisect\vtrace\__init__.py", line 283, in run
    self.wait()
  File "C:\Users\user\Downloads\vivisect\vtrace\platforms\base.py", line 167, in wait
    self._doWait()
  File "C:\Users\user\Downloads\vivisect\vtrace\platforms\base.py", line 177, in _doWait
    self.platformProcessEvent(event)
  File "C:\Users\user\Downloads\vivisect\vtrace\platforms\win32.py", line 1684, in platformProcessEvent
    self.platformDetach()
  File "C:\Users\user\Downloads\vivisect\vtrace\platforms\base.py", line 890, in trfunc
    raise ret
  File "C:\Users\user\Downloads\vivisect\vtrace\platforms\base.py", line 924, in run
    queue.put(meth(*args, **kwargs))
  File "C:\Users\user\Downloads\vivisect\vtrace\platforms\win32.py", line 1440, in platformDetach
    kernel32.CloseHandle(phandle)
ctypes.ArgumentError: argument 1: <class 'TypeError'>: wrong type

======================================================================
ERROR: test_vtrace_getregisters (vtrace.tests.testbasic.VtraceBasicTest)
----------------------------------------------------------------------
Traceback (most recent call last):
  File "C:\Users\user\Downloads\vivisect\vtrace\tests\testbasic.py", line 18, in test_vtrace_getregisters
    self.runUntilExit()
  File "C:\Users\user\Downloads\vivisect\vtrace\tests\__init__.py", line 62, in runUntilExit
    self.trace.run()
  File "C:\Users\user\Downloads\vivisect\vtrace\__init__.py", line 283, in run
    self.wait()
  File "C:\Users\user\Downloads\vivisect\vtrace\platforms\base.py", line 167, in wait
    self._doWait()
  File "C:\Users\user\Downloads\vivisect\vtrace\platforms\base.py", line 177, in _doWait
    self.platformProcessEvent(event)
  File "C:\Users\user\Downloads\vivisect\vtrace\platforms\win32.py", line 1684, in platformProcessEvent
    self.platformDetach()
  File "C:\Users\user\Downloads\vivisect\vtrace\platforms\base.py", line 890, in trfunc
    raise ret
  File "C:\Users\user\Downloads\vivisect\vtrace\platforms\base.py", line 924, in run
    queue.put(meth(*args, **kwargs))
  File "C:\Users\user\Downloads\vivisect\vtrace\platforms\win32.py", line 1440, in platformDetach
    kernel32.CloseHandle(phandle)
ctypes.ArgumentError: argument 1: <class 'TypeError'>: wrong type

======================================================================
ERROR: test_vtrace_mmaps (vtrace.tests.testbasic.VtraceBasicTest)
----------------------------------------------------------------------
Traceback (most recent call last):
  File "C:\Users\user\Downloads\vivisect\vtrace\tests\__init__.py", line 31, in tearDown
    self.trace.run()
  File "C:\Users\user\Downloads\vivisect\vtrace\__init__.py", line 283, in run
    self.wait()
  File "C:\Users\user\Downloads\vivisect\vtrace\platforms\base.py", line 167, in wait
    self._doWait()
  File "C:\Users\user\Downloads\vivisect\vtrace\platforms\base.py", line 177, in _doWait
    self.platformProcessEvent(event)
  File "C:\Users\user\Downloads\vivisect\vtrace\platforms\win32.py", line 1684, in platformProcessEvent
    self.platformDetach()
  File "C:\Users\user\Downloads\vivisect\vtrace\platforms\base.py", line 890, in trfunc
    raise ret
  File "C:\Users\user\Downloads\vivisect\vtrace\platforms\base.py", line 924, in run
    queue.put(meth(*args, **kwargs))
  File "C:\Users\user\Downloads\vivisect\vtrace\platforms\win32.py", line 1440, in platformDetach
    kernel32.CloseHandle(phandle)
ctypes.ArgumentError: argument 1: <class 'TypeError'>: wrong type

======================================================================
ERROR: test_vtrace_setregisters (vtrace.tests.testbasic.VtraceBasicTest)
----------------------------------------------------------------------
Traceback (most recent call last):
  File "C:\Users\user\Downloads\vivisect\vtrace\tests\testbasic.py", line 27, in test_vtrace_setregisters
    self.runUntilExit()
  File "C:\Users\user\Downloads\vivisect\vtrace\tests\__init__.py", line 62, in runUntilExit
    self.trace.run()
  File "C:\Users\user\Downloads\vivisect\vtrace\__init__.py", line 283, in run
    self.wait()
  File "C:\Users\user\Downloads\vivisect\vtrace\platforms\base.py", line 167, in wait
    self._doWait()
  File "C:\Users\user\Downloads\vivisect\vtrace\platforms\base.py", line 177, in _doWait
    self.platformProcessEvent(event)
  File "C:\Users\user\Downloads\vivisect\vtrace\platforms\win32.py", line 1684, in platformProcessEvent
    self.platformDetach()
  File "C:\Users\user\Downloads\vivisect\vtrace\platforms\base.py", line 890, in trfunc
    raise ret
  File "C:\Users\user\Downloads\vivisect\vtrace\platforms\base.py", line 924, in run
    queue.put(meth(*args, **kwargs))
  File "C:\Users\user\Downloads\vivisect\vtrace\platforms\win32.py", line 1440, in platformDetach
    kernel32.CloseHandle(phandle)
ctypes.ArgumentError: argument 1: <class 'TypeError'>: wrong type

======================================================================
ERROR: test_emulatorFromTrace (vtrace.tests.tests_envitools.EnvitoolsTests)
----------------------------------------------------------------------
Traceback (most recent call last):
  File "C:\Users\user\Downloads\vivisect\vtrace\tests\__init__.py", line 31, in tearDown
    self.trace.run()
  File "C:\Users\user\Downloads\vivisect\vtrace\__init__.py", line 283, in run
    self.wait()
  File "C:\Users\user\Downloads\vivisect\vtrace\platforms\base.py", line 167, in wait
    self._doWait()
  File "C:\Users\user\Downloads\vivisect\vtrace\platforms\base.py", line 177, in _doWait
    self.platformProcessEvent(event)
  File "C:\Users\user\Downloads\vivisect\vtrace\platforms\win32.py", line 1684, in platformProcessEvent
    self.platformDetach()
  File "C:\Users\user\Downloads\vivisect\vtrace\platforms\base.py", line 890, in trfunc
    raise ret
  File "C:\Users\user\Downloads\vivisect\vtrace\platforms\base.py", line 924, in run
    queue.put(meth(*args, **kwargs))
  File "C:\Users\user\Downloads\vivisect\vtrace\platforms\win32.py", line 1440, in platformDetach
    kernel32.CloseHandle(phandle)
ctypes.ArgumentError: argument 1: <class 'TypeError'>: wrong type

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

Thread 417 (2021-08-10):

Exception: Machine aa64 is not supported for PE!

williballenthin, 2021-08-10:
```
> python vivisect/vivbin.py --bulk samples/004e32a0f3610532cf08ce0ca4ee3ce2628faa0a143b732151706a8b7fda0df1                                                                            fix-415?
Traceback (most recent call last):
  File "vivisect/vivbin.py", line 144, in <module>
    main()
  File "vivisect/vivbin.py", line 98, in main
    vw.loadFromFile(fname, fmtname=args.parsemod)
  File "/home/user/code/vivisect/vivisect/__init__.py", line 2725, in loadFromFile
    fname = mod.parseFile(self, filename=filename, baseaddr=baseaddr)
  File "/home/user/code/vivisect/vivisect/parsers/pe.py", line 37, in parseFile
    return loadPeIntoWorkspace(vw, pe, filename=filename, baseaddr=baseaddr)
  File "/home/user/code/vivisect/vivisect/parsers/pe.py", line 90, in loadPeIntoWorkspace
    raise Exception("Machine %.4x is not supported for PE!" % mach)
Exception: Machine aa64 is not supported for PE!
```

would like a more specific exception that can be handled and rendered by a client application.

source: https://github.com/fireeye/capa/issues/702
sample: https://www.virustotal.com/gui/file/004e32a0f3610532cf08ce0ca4ee3ce2628faa0a143b732151706a8b7fda0df1/details

rakuy0, 2021-08-10:
Aye, more specific exceptions are good :+1:

Closed 2021-08-11.

Thread 419 (2021-08-10):

ZeroDivisionError: integer division or modulo by zero

williballenthin, 2021-08-10:
```
> python vivisect/vivbin.py --bulk samples/007ab1f8eb4ef62e9ea7607363dbacd205c7e89b159e5db554cfebef308a4c42                                                                          1 fix-417?
Traceback (most recent call last):
  File "vivisect/vivbin.py", line 144, in <module>
    main()
  File "vivisect/vivbin.py", line 98, in main
    vw.loadFromFile(fname, fmtname=args.parsemod)
  File "/home/user/code/vivisect/vivisect/__init__.py", line 2725, in loadFromFile
    fname = mod.parseFile(self, filename=filename, baseaddr=baseaddr)
  File "/home/user/code/vivisect/vivisect/parsers/pe.py", line 38, in parseFile
    return loadPeIntoWorkspace(vw, pe, filename=filename, baseaddr=baseaddr)
  File "/home/user/code/vivisect/vivisect/parsers/pe.py", line 181, in loadPeIntoWorkspace
    secrem = len(header) % secalign
ZeroDivisionError: integer division or modulo by zero
```

this file appears corrupt. still, it would be nice for a specific exception to be raised, such as `CorruptFile("invalid section alignment")`

source: https://github.com/fireeye/capa/issues/704

williballenthin, 2021-08-10:
clearly corrupt file:

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

rakuy0, 2021-08-10:
Similar to the others, I like more specific exceptions :+1:

Closed 2021-08-11.

Thread 421 (2021-08-10):

struct.error: unpack requires a buffer of 4 bytes

williballenthin, 2021-08-10:
```
> python vivisect/vivbin.py --bulk samples/021aa79573478322e1e3f419f20be9c7543d9754d99cad9d6499e7f43596a068                                                                            fix-415?
Traceback (most recent call last):
  File "vivisect/vivbin.py", line 144, in <module>
    main()
  File "vivisect/vivbin.py", line 98, in main
    vw.loadFromFile(fname, fmtname=args.parsemod)
  File "/home/user/code/vivisect/vivisect/__init__.py", line 2725, in loadFromFile
    fname = mod.parseFile(self, filename=filename, baseaddr=baseaddr)
  File "/home/user/code/vivisect/vivisect/parsers/pe.py", line 37, in parseFile
    return loadPeIntoWorkspace(vw, pe, filename=filename, baseaddr=baseaddr)
  File "/home/user/code/vivisect/vivisect/parsers/pe.py", line 523, in loadPeIntoWorkspace
    pebytes = subpe.readAtOffset(0, subpe.getFileSize())
  File "/home/user/code/vivisect/PE/carve.py", line 68, in getFileSize
    for sec in self.getSections():
  File "/home/user/code/vivisect/PE/__init__.py", line 489, in getSections
    return self.sections
  File "/home/user/code/vivisect/PE/__init__.py", line 1208, in __getattr__
    self.parseSections()
  File "/home/user/code/vivisect/PE/__init__.py", line 709, in parseSections
    s.vsParse(sbytes[:secsize])
  File "/home/user/code/vivisect/vstruct/__init__.py", line 167, in vsParse
    offset = fobj.vsParse(sbytes, offset=offset)
  File "/home/user/code/vivisect/vstruct/primitives.py", line 186, in vsParse
    self._vs_value = struct.unpack(self._vs_fmt, b)[0]
struct.error: unpack requires a buffer of 4 bytes
```

this file appears corrupt. still, it would be nice for a specific exception to be raised, such as `CorruptFile("truncated section data")`.

source: https://github.com/fireeye/capa/issues/705

rakuy0, 2021-08-10:
:+1:

Closed 2021-08-11.

Thread 423 (2021-08-10):

ModuleNotFoundError: No module named 'vivisect.impapi.windows.arm'

williballenthin, 2021-08-10:
```
> python vivisect/vivbin.py --bulk samples/0391b7a9407757a5efb72cff837509bc07635da64eb5645d3aa3284052287c17                                                                            working?
Traceback (most recent call last):
  File "vivisect/vivbin.py", line 144, in <module>
    main()
  File "vivisect/vivbin.py", line 98, in main
    vw.loadFromFile(fname, fmtname=args.parsemod)
  File "/home/user/code/vivisect/vivisect/__init__.py", line 2730, in loadFromFile
    self._snapInAnalysisModules()
  File "/home/user/code/vivisect/vivisect/base.py", line 197, in _snapInAnalysisModules
    viv_analysis.addAnalysisModules(self)
  File "/home/user/code/vivisect/vivisect/analysis/__init__.py", line 42, in addAnalysisModules
    vw.addImpApi('windows','arm')
  File "/home/user/code/vivisect/vivisect/impapi/__init__.py", line 66, in addImpApi
    __import__(modname)
ModuleNotFoundError: No module named 'vivisect.impapi.windows.arm'
```

is there a file missing here? https://github.com/vivisect/vivisect/tree/v1.0.3/vivisect/impapi/windows

source: https://github.com/fireeye/capa/issues/706
sample: https://www.virustotal.com/gui/file/0391b7a9407757a5efb72cff837509bc07635da64eb5645d3aa3284052287c17/detection

rakuy0, 2021-08-10:
Yea, I'd want to know if @atlas0fd00m has this file floating around on his box and just forgot to commit it before just removing the ref.

atlas0fd00m, 2021-08-11:
for review: https://github.com/vivisect/vivisect/pull/431

williballenthin, 2021-08-19:
closed in #431

Closed 2021-08-19.

Thread 425 (2021-08-10):

AttributeError: 'NoneType' object has no attribute 'split'

williballenthin, 2021-08-10:
```
> python vivisect/vivbin.py --bulk samples/0a50a0582cf414bae644be1ae2164183c1549e869f0ef8ea8d6b3002a098dd0b                                                                            working?
Traceback (most recent call last):
  File "vivisect/vivbin.py", line 144, in <module>
    main()
  File "vivisect/vivbin.py", line 98, in main
    vw.loadFromFile(fname, fmtname=args.parsemod)
  File "/home/user/code/vivisect/vivisect/__init__.py", line 2725, in loadFromFile
    fname = mod.parseFile(self, filename=filename, baseaddr=baseaddr)
  File "/home/user/code/vivisect/vivisect/parsers/pe.py", line 38, in parseFile
    return loadPeIntoWorkspace(vw, pe, filename=filename, baseaddr=baseaddr)
  File "/home/user/code/vivisect/vivisect/parsers/pe.py", line 128, in loadPeIntoWorkspace
    dllname = pe.getDllName()
  File "/home/user/code/vivisect/PE/__init__.py", line 457, in getDllName
    return rawname.split(b'\x00')[0].decode('utf-8')
AttributeError: 'NoneType' object has no attribute 'split'
```

the DLL name pointer is invalid so it fails to read data and the `None` cannot be split.

rakuy0, 2021-08-10:
:+1:

Closed 2021-08-10.

Thread 427 (2021-08-10):

struct.error: unpack requires a buffer of 32754 bytes

williballenthin, 2021-08-10:
```
> python vivisect/vivbin.py --bulk samples/526ff9827564a4464da55accdbaa060655dbe831487ebb663230e454d21b81b7             
Traceback (most recent call last):
  File "vivisect/vivbin.py", line 144, in <module>
    main()
  File "vivisect/vivbin.py", line 98, in main
    vw.loadFromFile(fname, fmtname=args.parsemod)
  File "/home/user/code/vivisect/vivisect/__init__.py", line 2725, in loadFromFile
    fname = mod.parseFile(self, filename=filename, baseaddr=baseaddr)
  File "/home/user/code/vivisect/vivisect/parsers/pe.py", line 38, in parseFile
    return loadPeIntoWorkspace(vw, pe, filename=filename, baseaddr=baseaddr)
  File "/home/user/code/vivisect/vivisect/parsers/pe.py", line 349, in loadPeIntoWorkspace
    for rva, rtype in pe.getRelocations():
  File "/home/user/code/vivisect/PE/__init__.py", line 914, in getRelocations
    return self.relocations
  File "/home/user/code/vivisect/PE/__init__.py", line 1216, in __getattr__
    self.parseRelocations()
  File "/home/user/code/vivisect/PE/__init__.py", line 948, in parseRelocations
    rels = struct.unpack("<%dH" % relcnt, relbytes[8:chunksize])
struct.error: unpack requires a buffer of 32754 bytes
```

i think the file is corrupt. still, would like to see a more specific error that can be handled and rendered.

source: https://github.com/fireeye/capa/issues/713

williballenthin, 2021-08-10:
another bug `relcnt` is a float here: https://github.com/vivisect/vivisect/blob/6de41d2f238ec4531ae0f85b57ea9d11ac8d5f9e/PE/__init__.py#L935

Closed 2021-08-11.

Thread 429 (2021-08-10):

windows platformDetach reports TypeError

midgen42, 2021-08-10:
```
Loading Binary: C:\\Windows\System32\ole32.dll
Loading Binary: C:\\Windows\System32\dwmapi.dll
New Thread: 11832
Thread: 11832 NOTIFY_BREAK
vdb > quit
Detached from 7140
Traceback (most recent call last):
  File "C:\Vivisect\vdb\__init__.py", line 1509, in do_quit
    self.trace.detach()
  File "C:\Vivisect\vtrace\__init__.py", line 311, in detach
    self.platformDetach()
  File "C:\Vivisect\vtrace\platforms\base.py", line 890, in trfunc
    raise ret
  File "C:\Vivisect\vtrace\platforms\base.py", line 924, in run
    queue.put(meth(*args, **kwargs))
  File "C:\Vivisect\vtrace\platforms\win32.py", line 1438, in platformDetach
    kernel32.CloseHandle(phandle)
ctypes.ArgumentError: argument 1: <class 'TypeError'>: wrong type

Exception during quit (may need: quit force): argument 1: <class 'TypeError'>: wrong type
vdb >
```

midgen42, 2021-08-10:
need to move `self.phandle = None` after `phandle = self.phandle`  to prevent the call `kernel32.CloseHandle(phandle)` from failing

rakuy0, 2021-08-10:
Yea. @atlas0fd00m and I just found this the other day. Ends up being the result of some git conflicts that didn't get resolved properly. We'll get this sorted out shortly, but thanks for letting us know!

atlas0fd00m, 2021-08-10:
good catch and thank you for pointing it out!  yup, this is part of the current Vtrace PR we're working on.

Closed 2021-08-11.

Thread 430 (2021-08-10):

tests do not pass on Windows

williballenthin, 2021-08-10:
In summary:
  - `ctypes.ArgumentError: argument 1: <class 'TypeError'>: wrong type` in `platformDetach`
  - `Exception: Unsupported Expression (symbolik width index)` in `astToSymboliks`
  - `KeyError: '.rsrc'` in `test_mimikatz_segments` and `test_firefox_segments`
  - `AssertionError: Items in the second set but not the first:` in `test_memorymaps_basicperms`
  - `vtrace.PlatformException: Win32 Error kernel32.WriteProcessMemory failed: 998`
  - `AssertionError: Tuples differ` in `test_basic_apis`

There are some other errors in cobra and gui that I've ignored because I'm not running this as admin nor with pyqt.

I'd recommend running these tests via CI against all PRs and other commits. We have such a setup for capa that runs all tests taking 15mins each against (linux, mac, win) by (py3.6, py3.9). We do this all on GH Action free tier without any trouble. May you can adapt our config for more thorough testing of vivisect?

https://github.com/fireeye/capa/blob/master/.github/workflows/tests.yml

```
======================================================================
ERROR: test_cobra_authentication (cobra.tests.testbasic.CobraBasicTest)
----------------------------------------------------------------------
OSError: [WinError 10013] An attempt was made to access a socket in a way forbidden by its access permissions
======================================================================
ERROR: test_cobra_msgpack (cobra.tests.testbasic.CobraBasicTest)
----------------------------------------------------------------------
OSError: [WinError 10013] An attempt was made to access a socket in a way forbidden by its access permissions

======================================================================
ERROR: test_cobra_proxy (cobra.tests.testbasic.CobraBasicTest)
----------------------------------------------------------------------
OSError: [WinError 10013] An attempt was made to access a socket in a way forbidden by its access permissions

======================================================================
ERROR: test_cobra_refcount (cobra.tests.testbasic.CobraBasicTest)
----------------------------------------------------------------------
OSError: [WinError 10013] An attempt was made to access a socket in a way forbidden by its access permissions

======================================================================
ERROR: test_cobra_shadowauth (cobra.tests.testbasic.CobraBasicTest)
----------------------------------------------------------------------
OSError: [WinError 10013] An attempt was made to access a socket in a way forbidden by its access permissions

======================================================================
ERROR: test_cobra_newobj (cobra.tests.testnewobj.CobraNewObjTest)
----------------------------------------------------------------------
OSError: [WinError 10013] An attempt was made to access a socket in a way forbidden by its access permissions

======================================================================
ERROR: test_emu_lockstep (envi.tests.test_emu_lockstep.LockStepTest)
----------------------------------------------------------------------
Traceback (most recent call last):
...
  File "C:\Users\user\Downloads\vivisect\vtrace\platforms\win32.py", line 1438, in platformDetach
    kernel32.CloseHandle(phandle)
ctypes.ArgumentError: argument 1: <class 'TypeError'>: wrong type

======================================================================
ERROR: test_vdb_stalker (vdb.tests.teststalker.VdbStalkerTest)
----------------------------------------------------------------------
Traceback (most recent call last):
...
  File "C:\Users\user\Downloads\vivisect\vtrace\platforms\win32.py", line 1438, in platformDetach
    kernel32.CloseHandle(phandle)
ctypes.ArgumentError: argument 1: <class 'TypeError'>: wrong type

======================================================================
ERROR: test_symboliks_reduce_op_and (vivisect.symboliks.tests.test_reduce.TestReduceCase)
----------------------------------------------------------------------
Traceback (most recent call last):
...
  File "C:\Users\user\Downloads\vivisect\vivisect\symboliks\expression.py", line 135, in astToSymboliks
    raise Exception('Unsupported Expression (symbolik width index)')
Exception: Unsupported Expression (symbolik width index)

======================================================================
ERROR: test_mimikatz_segments (vivisect.tests.testpe.PETests)
----------------------------------------------------------------------
Traceback (most recent call last):
  File "C:\Users\user\Downloads\vivisect\vivisect\tests\testpe.py", line 501, in test_mimikatz_segments
    self.assertEqual(ans[sname][0], sva)
KeyError: '.rsrc'

======================================================================
ERROR: test_firefox_segments (vivisect.tests.testvivisect.VivisectTest)
----------------------------------------------------------------------
Traceback (most recent call last):
  File "C:\Users\user\Downloads\vivisect\vivisect\tests\testvivisect.py", line 830, in test_firefox_segments
    self.assertEqual(ans[sname][0], sva)
KeyError: '.rsrc'

======================================================================
ERROR: vqt.tests.testmenubuilder (unittest.loader._FailedTest)
----------------------------------------------------------------------
ModuleNotFoundError: No module named 'PyQt5'

======================================================================
ERROR: vstruct.qt (unittest.loader._FailedTest)
----------------------------------------------------------------------
ModuleNotFoundError: No module named 'PyQt5'

======================================================================
ERROR: test_baselib (vtrace.tests.test_expressions.VtraceExpressionTest)
----------------------------------------------------------------------
Traceback (most recent call last):
...
  File "C:\Users\user\Downloads\vivisect\vtrace\platforms\win32.py", line 1438, in platformDetach
    kernel32.CloseHandle(phandle)
ctypes.ArgumentError: argument 1: <class 'TypeError'>: wrong type

======================================================================
ERROR: test_vtrace_sym (vtrace.tests.test_expressions.VtraceExpressionTest)
----------------------------------------------------------------------
Traceback (most recent call last):
...
  File "C:\Users\user\Downloads\vivisect\vtrace\platforms\win32.py", line 1438, in platformDetach
    kernel32.CloseHandle(phandle)
ctypes.ArgumentError: argument 1: <class 'TypeError'>: wrong type

======================================================================
ERROR: test_vtrace_breakpoint (vtrace.tests.testbasic.VtraceBasicExecTest)
----------------------------------------------------------------------
Traceback (most recent call last):
...
  File "C:\Users\user\Downloads\vivisect\vtrace\platforms\win32.py", line 1438, in platformDetach
    kernel32.CloseHandle(phandle)
ctypes.ArgumentError: argument 1: <class 'TypeError'>: wrong type

======================================================================
ERROR: test_vtrace_exename (vtrace.tests.testbasic.VtraceBasicExecTest)
----------------------------------------------------------------------
Traceback (most recent call last):
...
  File "C:\Users\user\Downloads\vivisect\vtrace\platforms\win32.py", line 1438, in platformDetach
    kernel32.CloseHandle(phandle)
ctypes.ArgumentError: argument 1: <class 'TypeError'>: wrong type

======================================================================
ERROR: test_vtrace_getregisters (vtrace.tests.testbasic.VtraceBasicExecTest)
----------------------------------------------------------------------
Traceback (most recent call last):
...
  File "C:\Users\user\Downloads\vivisect\vtrace\platforms\win32.py", line 1438, in platformDetach
    kernel32.CloseHandle(phandle)
ctypes.ArgumentError: argument 1: <class 'TypeError'>: wrong type

======================================================================
ERROR: test_vtrace_mmaps (vtrace.tests.testbasic.VtraceBasicExecTest)
----------------------------------------------------------------------
Traceback (most recent call last):
...
  File "C:\Users\user\Downloads\vivisect\vtrace\platforms\win32.py", line 1438, in platformDetach
    kernel32.CloseHandle(phandle)
ctypes.ArgumentError: argument 1: <class 'TypeError'>: wrong type

======================================================================
ERROR: test_vtrace_setregisters (vtrace.tests.testbasic.VtraceBasicExecTest)
----------------------------------------------------------------------
Traceback (most recent call last):
...
  File "C:\Users\user\Downloads\vivisect\vtrace\platforms\win32.py", line 1438, in platformDetach
    kernel32.CloseHandle(phandle)
ctypes.ArgumentError: argument 1: <class 'TypeError'>: wrong type

======================================================================
ERROR: test_vtrace_breakpoint (vtrace.tests.testbasic.VtraceBasicTest)
----------------------------------------------------------------------
Traceback (most recent call last):
...
  File "C:\Users\user\Downloads\vivisect\vtrace\platforms\win32.py", line 1438, in platformDetach
    kernel32.CloseHandle(phandle)
ctypes.ArgumentError: argument 1: <class 'TypeError'>: wrong type

======================================================================
ERROR: test_vtrace_exename (vtrace.tests.testbasic.VtraceBasicTest)
----------------------------------------------------------------------
Traceback (most recent call last):
...
  File "C:\Users\user\Downloads\vivisect\vtrace\platforms\win32.py", line 1438, in platformDetach
    kernel32.CloseHandle(phandle)
ctypes.ArgumentError: argument 1: <class 'TypeError'>: wrong type

======================================================================
ERROR: test_vtrace_getregisters (vtrace.tests.testbasic.VtraceBasicTest)
----------------------------------------------------------------------
Traceback (most recent call last):
...
  File "C:\Users\user\Downloads\vivisect\vtrace\platforms\win32.py", line 1438, in platformDetach
    kernel32.CloseHandle(phandle)
ctypes.ArgumentError: argument 1: <class 'TypeError'>: wrong type

======================================================================
ERROR: test_vtrace_mmaps (vtrace.tests.testbasic.VtraceBasicTest)
----------------------------------------------------------------------
Traceback (most recent call last):
...
  File "C:\Users\user\Downloads\vivisect\vtrace\platforms\win32.py", line 1438, in platformDetach
    kernel32.CloseHandle(phandle)
ctypes.ArgumentError: argument 1: <class 'TypeError'>: wrong type

======================================================================
ERROR: test_vtrace_setregisters (vtrace.tests.testbasic.VtraceBasicTest)
----------------------------------------------------------------------
Traceback (most recent call last):
...
  File "C:\Users\user\Downloads\vivisect\vtrace\platforms\win32.py", line 1438, in platformDetach
    kernel32.CloseHandle(phandle)
ctypes.ArgumentError: argument 1: <class 'TypeError'>: wrong type

======================================================================
ERROR: test_emulatorFromTrace (vtrace.tests.tests_envitools.EnvitoolsTests)
----------------------------------------------------------------------
Traceback (most recent call last):
...
  File "C:\Users\user\Downloads\vivisect\vtrace\platforms\win32.py", line 1438, in platformDetach
    kernel32.CloseHandle(phandle)
ctypes.ArgumentError: argument 1: <class 'TypeError'>: wrong type

======================================================================
ERROR: test_vtrace_threads (vtrace.tests.testthread.VtraceThreadTest)
----------------------------------------------------------------------
Traceback (most recent call last):
...
  File "C:\Users\user\Downloads\vivisect\vtrace\platforms\win32.py", line 1438, in platformDetach
    kernel32.CloseHandle(phandle)
ctypes.ArgumentError: argument 1: <class 'TypeError'>: wrong type

======================================================================
ERROR: test_vtrace_writemem (vtrace.tests.testwritemem.VtraceWritememTest)
----------------------------------------------------------------------
Traceback (most recent call last):
  File "C:\Users\user\Downloads\vivisect\vtrace\tests\testwritemem.py", line 22, in test_vtrace_writemem
    self.trace.writeMemory(addr, testbuf)
  File "C:\Users\user\Downloads\vivisect\vtrace\__init__.py", line 526, in writeMemory
    self.platformWriteMemory(int(address), bytez)
  File "C:\Users\user\Downloads\vivisect\vtrace\platforms\win32.py", line 1526, in platformWriteMemory
    raiseWin32Error("kernel32.WriteProcessMemory")
  File "C:\Users\user\Downloads\vivisect\vtrace\platforms\win32.py", line 1203, in raiseWin32Error
    raise vtrace.PlatformException("Win32 Error %s failed: %s" % (name,kernel32.GetLastError()))
vtrace.PlatformException: Win32 Error kernel32.WriteProcessMemory failed: 998

======================================================================
FAIL: test_memorymaps_basicperms (vivisect.tests.testmalware.MalwareTests)
----------------------------------------------------------------------
Traceback (most recent call last):
  File "C:\Users\user\Downloads\vivisect\vivisect\tests\testmalware.py", line 36, in test_memorymaps_basicperms
    self.assertEqual(maps, set(vw.getMemoryMaps()))
AssertionError: Items in the second set but not the first:
(269000704, 436, 4, '0e25aa791c9119108af073bc9e9d0fa2')

======================================================================
FAIL: test_basic_apis (vivisect.tests.testvivisect.VivisectTest)
Test a bunch of the simpler workspace APIs
----------------------------------------------------------------------
Traceback (most recent call last):
  File "C:\Users\user\Downloads\vivisect\vivisect\tests\testvivisect.py", line 240, in test_basic_apis
    self.assertEqual(locdist, ans[loctype])
AssertionError: Tuples differ: ('Undefined', 0, 259593, 44) != ('Undefined', 0, 53337, 14)

First differing element 2:
259593
53337

- ('Undefined', 0, 259593, 44)
?                  - ---   ^

+ ('Undefined', 0, 53337, 14)
?                    +++  ^

----------------------------------------------------------------------
Ran 353 tests in 473.966s

FAILED (failures=2, errors=28, skipped=2)
```

```
(env) PS C:\Users\user\Downloads\vivisect> git log -1
commit 6453b76b9946239ef7603294d6eac2ac3f151837 (HEAD -> master, origin/master, origin/HEAD)
Author: James Gross <45212823+rakuy0@users.noreply.github.com>
Date:   Tue Aug 10 14:40:57 2021 -0400

    Change amd64 symboliks callconv class declaration (#413)

    Reorder Amd64 symboliks callconv declaration to avoid exceptions
(env) PS C:\Users\user\Downloads\vivisect> python -V
Python 3.8.5
(env) PS C:\Users\user\Downloads\vivisect> pip freeze
cxxfilt==0.2.2
msgpack==1.0.2
pyasn1==0.4.8
pyasn1-modules==0.2.8
pycparser==2.20
-e git+ssh://git@github.com/vivisect/vivisect.git@6453b76b9946239ef7603294d6eac2ac3f151837#egg=vivisect
```

williballenthin, 2021-08-11:
on linux, things look *better*:

```
======================================================================
ERROR: test_symboliks_reduce_op_and (vivisect.symboliks.tests.test_reduce.TestReduceCase)
----------------------------------------------------------------------
Traceback (most recent call last):
  File "/home/user/code/vivisect/vivisect/symboliks/tests/test_reduce.py", line 34, in test_symboliks_reduce_op_and
    self.assertReduce('foo[5] & 0', '0')
  File "/home/user/code/vivisect/vivisect/symboliks/tests/test_reduce.py", line 11, in assertReduce
    sym1 = symexp(s1).reduce(foo=True)
  File "/home/user/code/vivisect/vivisect/symboliks/expression.py", line 40, in symexp
    return p.parseExpression(expr)
  File "/home/user/code/vivisect/vivisect/symboliks/expression.py", line 67, in parseExpression
    return self.astToSymboliks(a.body[0])
  File "/home/user/code/vivisect/vivisect/symboliks/expression.py", line 90, in astToSymboliks
    return self.astToSymboliks(a.value)
  File "/home/user/code/vivisect/vivisect/symboliks/expression.py", line 93, in astToSymboliks
    left = self.astToSymboliks(a.left)
  File "/home/user/code/vivisect/vivisect/symboliks/expression.py", line 135, in astToSymboliks
    raise Exception('Unsupported Expression (symbolik width index)')
Exception: Unsupported Expression (symbolik width index)

----------------------------------------------------------------------
Ran 353 tests in 382.084s

FAILED (errors=1, skipped=3)
```

rakuy0, 2021-08-11:
`I'd recommend running these tests via CI against all PRs and other commits`
* So the original reason we did this is because back when we migrated off of travis, GH Actions and Circle seemed comparable in terms of how much time we got, and it wasn't enough to support more than a handful of windows runs (which wasn't particular worth it to setup if we were only going to get like 5 runs total). Is that no longer the case?
* And just so I can bound this for my own testing, most of this is specifc to py3.8 correct?

atlas0fd00m, 2021-08-11:
bless you, @williballenthin !  thank you for the feedback and insight and PRs to improve Viv!  your help is very much appreciated!

@

atlas0fd00m, 2021-08-11:
some of these are fixed in PR's we're working to get merged in.
some of these are installation problems (we can't have the unittests install pyqt5, for example.
some of these are new and need some attention!
one or two of these look like "ghost in the box" issues i can see on one of my dev boxes where i've changed something ( i know not what) and tests fail that i cannot explain (even tho the same installation on a diff system works fine and unittests work on CI)

we'll def kill the `    kernel32.CloseHandle(phandle)` bug soon.

williballenthin, 2021-08-11:
thank you all!

> Is that no longer the case?

I can only speak from my experience, and I have a suspicion that GH Actions doesn't track their usage very closely, so things have the potential to change...

We run our full test suite against all pushes to master & PRs. For your amusement, the testing history is here: https://github.com/fireeye/capa/actions/workflows/tests.yml It should illustrate that we run up to a few dozen full workflows per week, ranging from 30-90mins each. I'm not really sure how to check our quota, and tbh, I'm not sure I want to know. But, I can confirm it works well and we haven't had any trouble.

I recently backported our capa setup to floss and it took maybe 15 minutes. I hope you could do the same with vivisect (only if you want). The key details are here: https://github.com/fireeye/capa/blob/master/.github/workflows/tests.yml#L66-L90 Although 3.6 is old, we keep that around as its the last version to run on Win7.

> most of this is specifc to py3.8 correct?

I have no idea - 3.8 is just what I had handy on my laptop. I haven't had a chance to triage the failures but I did want to report them while I had the details handy.

rakuy0, 2021-08-11:
Ah, thank you @williballenthin. Wouldn't have realized any of this without you.

`It should illustrate that we run up to a few dozen full workflows per week`
That is promising. It seems like they've been putting a lot of work into it. I'll talk with atlas about it, but it does seem tempting if it can support you guys like that (especially on the windows front).

`3.8 is just what I had handy on my laptop`
That's fair. 3.9 is what's handy on mine, and why I probably didn't notice any of this. But it seems like a lot of it was <3.9 (they deprecated some things in 3.9 and swapped around some types). That's more so I know what things I need to test before submitting a PR.

But hopefully we can resolve this in a couple days, and maybe cut a release too :smile:

atlas0fd00m, 2021-12-04:
is this resolved?

williballenthin, 2021-12-06:
no, tests do not pass under Windows:

```
======================================================================
ERROR: test_do_cmds (envi.tests.test_cli.EnviCliTest)
----------------------------------------------------------------------
Traceback (most recent call last):
  File "C:\Users\user\Documents\code\vivisect\envi\tests\test_cli.py", line 98, in test_do_cmds
    ecli.do_memdump('0x41410001 /tmp/foo40 20')
  File "C:\Users\user\Documents\code\vivisect\envi\cli.py", line 768, in do_memdump
    with open(fname, 'wb') as f:
FileNotFoundError: [Errno 2] No such file or directory: '/tmp/foo40'
======================================================================
ERROR: test_emu_lockstep (envi.tests.test_emu_lockstep.LockStepTest)
----------------------------------------------------------------------
Traceback (most recent call last):
  File "C:\Users\user\Documents\code\vivisect\envi\tests\test_emu_lockstep.py", line 143, in test_emu_lockstep
    lock.stepi(stepcount)
  File "C:\Users\user\Documents\code\vivisect\envi\tests\test_emu_lockstep.py", line 89, in stepi
    self.cmpregs(op1, op2)
  File "C:\Users\user\Documents\code\vivisect\envi\tests\test_emu_lockstep.py", line 104, in cmpregs
    raise Exception('LockStep: emu 0x%.8x %s %s=0x%.8x | trace 0x%.8x %s %s=0x%.8x' % (emuop.va, repr(emuop), regname, regval, traceop.va, repr(traceop), regname, traceval))
Exception: LockStep: emu 0x7ffce01a9527 shr cx,8 eflags=0x00000203 | trace 0x7ffce01a9527 shr cx,8 eflags=0x00000a03
======================================================================
FAIL: test_symbol (vtrace.tests.test_symcache.VtraceSymbolTest)
----------------------------------------------------------------------
Traceback (most recent call last):
  File "C:\Users\user\Documents\code\vivisect\vtrace\tests\test_symcache.py", line 12, in test_symbol
    self.assertGreater(len(symlist), 1000)
AssertionError: 37 not greater than 1000
----------------------------------------------------------------------
Ran 308 tests in 19.727s

FAILED (failures=1, errors=4, skipped=19)
```

atlas0fd00m, 2022-04-29:
is this resolved?

Thread 433 (2021-08-19):

Exception: Invalid String Size: -1

williballenthin, 2021-08-19:
```
> python ~/code/vivisect/vivisect/vivbin.py --bulk samples/538f5401738b524c299b74c5cbba34bc070e18a642f3abfca408e15d6de03897
Traceback (most recent call last):
  File "/home/user/code/vivisect/vivisect/vivbin.py", line 144, in <module>
    main()
  File "/home/user/code/vivisect/vivisect/vivbin.py", line 98, in main
    vw.loadFromFile(fname, fmtname=args.parsemod)
  File "/home/user/code/vivisect/vivisect/__init__.py", line 2725, in loadFromFile
    fname = mod.parseFile(self, filename=filename, baseaddr=baseaddr)
  File "/home/user/code/vivisect/vivisect/parsers/pe.py", line 38, in parseFile
    return loadPeIntoWorkspace(vw, pe, filename=filename, baseaddr=baseaddr)
  File "/home/user/code/vivisect/vivisect/parsers/pe.py", line 433, in loadPeIntoWorkspace
    vw.makeString(rva+baseaddr)
  File "/home/user/code/vivisect/vivisect/__init__.py", line 2136, in makeString
    raise Exception("Invalid String Size: %d" % size)
Exception: Invalid String Size: -1
```

when there is an invalid forwarder in the PE loader
https://github.com/vivisect/vivisect/blob/ad6fbba99a6e82ddefbbf8137e7e4e450fe5fc11/vivisect/parsers/pe.py#L433

`asciiStringSize` returns -1 when it cannot find the NULL terminator.
https://github.com/vivisect/vivisect/blob/ad6fbba99a6e82ddefbbf8137e7e4e450fe5fc11/vivisect/__init__.py#L2265

so `makeString` gets unhappy
https://github.com/vivisect/vivisect/blob/master/vivisect/__init__.py#L2136

williballenthin, 2021-08-19:
i'll submit a PR shortly

williballenthin, 2021-08-19:
turns out the forwarder is not invalid; rather, viv incorrectly returns data from the end of a section (doesn't pad/align the section maybe? or read is truncated? not sure yet). will report and triage this separately.

williballenthin, 2021-08-19:
#436 fixes the underlying section alignment issue. #437 will fix the exception raised here.

Closed 2021-09-13.

Thread 435 (2021-08-19):

viv fails to read strings at the end of some sections

williballenthin, 2021-08-19:
In [538f5401738b524c299b74c5cbba34bc070e18a642f3abfca408e15d6de03897](https://www.virustotal.com/gui/file/538f5401738b524c299b74c5cbba34bc070e18a642f3abfca408e15d6de03897/detection) viv fails to read the ASCII string found at 0x100023FE that is referenced as an export forwarder (see #433).

there should be at least 0x26 bytes from the section data (and padded out until 0x10002600):

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

however, viv can only read 0xC bytes (until 0x1000240A):

```
getByteDef(0x100023fe )
-> offset: 0x3fe
   length: 0x40a
   data: 00000000: 57 69 6E 33 32 49 6E 73  2E 66 74 73              Win32Ins.fts
```

williballenthin, 2021-08-19:
viv memory map:
```py
In [6]: for addr, size, perms, filename in vw.getMemoryMaps():
   ...:     print(hex(addr), "0x%04x" % size, hex(addr+size))
   ...:
0x10000000 0x1000 0x10001000
0x10001000 0x0274 0x10001274
0x10002000 0x040a 0x1000240a
0x10003000 0x006c 0x1000306c
0x10004000 0x0076 0x10004076
```

williballenthin, 2021-08-19:
there's already a bit of logic to partly handle this case here: https://github.com/vivisect/vivisect/blob/ad6fbba99a6e82ddefbbf8137e7e4e450fe5fc11/vivisect/parsers/pe.py#L320

but needs to be more thorough. i'll open a PR shortly.

Closed 2021-08-19.

Thread 438 (2021-08-19):

TypeError: a bytes-like object is required, not 'NoneType'

williballenthin, 2021-08-19:
```
> python ~/code/vivisect/vivisect/vivbin.py --bulk samples/471ce36855fec6b44398b9b1e3cfb9e74b122fb2cc20fdf6603ebda39f86dddf                                                           1
Traceback (most recent call last):
  File "/home/user/code/vivisect/vivisect/vivbin.py", line 144, in <module>
    main()
  File "/home/user/code/vivisect/vivisect/vivbin.py", line 98, in main
    vw.loadFromFile(fname, fmtname=args.parsemod)
  File "/home/user/code/vivisect/vivisect/__init__.py", line 2725, in loadFromFile
    fname = mod.parseFile(self, filename=filename, baseaddr=baseaddr)
  File "/home/user/code/vivisect/vivisect/parsers/pe.py", line 45, in parseFile
    return loadPeIntoWorkspace(vw, pe, filename=filename, baseaddr=baseaddr)
  File "/home/user/code/vivisect/vivisect/parsers/pe.py", line 395, in loadPeIntoWorkspace
    for rva, lname, iname in pe.getDelayImports():
  File "/home/user/code/vivisect/PE/__init__.py", line 479, in getDelayImports
    return self.delayImports
  File "/home/user/code/vivisect/PE/__init__.py", line 1212, in __getattr__
    self.parseDelayImports()
  File "/home/user/code/vivisect/PE/__init__.py", line 836, in parseDelayImports
    self.delayImports = self.parseImportTable(x, irva, is_imports=False)
  File "/home/user/code/vivisect/PE/__init__.py", line 879, in parseImportTable
    ibn_rva = self.readPointerAtRva(imp_by_name+arrayoff)
  File "/home/user/code/vivisect/PE/__init__.py", line 765, in readPointerAtRva
    return self.readPointerAtOffset(off)
  File "/home/user/code/vivisect/PE/__init__.py", line 761, in readPointerAtOffset
    return struct.unpack(fmt, self.readAtOffset(off, self.psize))[0]
TypeError: a bytes-like object is required, not 'NoneType'
```

looks like an issue with parseDelayImports

williballenthin, 2021-08-19:
will triage and report back here.

williballenthin, 2021-08-19:
trying to read the the following:
```
imp_by_name: 0x4dcbb0
arrayoff: 0x0
imp_by_name+arrayoff: 0x4dcbb0
```

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

williballenthin, 2021-08-19:
this is a known weird fact about delayed imports: they *usually* contain an RVA but they *may* contain a VA (esp from VS6): https://reverseengineering.stackexchange.com/a/16266/17194

so, when processing delayed imports, we should try to recognize when dealing with VAs rather than RVAs and take appropriate action.

williballenthin, 2021-08-19:
also a bug: this is a large binary (mapped size at least 0x685de8) and this size is larger than its base address (0x401000) so a naive "is potential RVA < base address?" doesn't work here.

Thread 440 (2021-08-20):

UnicodeDecodeError: 'utf-8' codec can't decode byte 0x98 in position 0: invalid start byte

williballenthin, 2021-08-20:
```
   1   │ Traceback (most recent call last):
   2   │   File "/usr/lib/python3.8/runpy.py", line 194, in _run_module_as_main
   3   │     return _run_code(code, main_globals, None,
   4   │   File "/usr/lib/python3.8/runpy.py", line 87, in _run_code
   5   │     exec(code, run_globals)
   6   │   File "/home/user/code/capa-pub/capa/main.py", line 991, in <module>
   7   │     sys.exit(main())
   8   │   File "/home/user/code/capa-pub/capa/main.py", line 899, in main
   9   │     extractor = get_extractor(
  10   │   File "/home/user/code/capa-pub/capa/main.py", line 464, in get_extractor
  11   │     vw = get_workspace(path, format, sigpaths)
  12   │   File "/home/user/code/capa-pub/capa/main.py", line 412, in get_workspace
  13   │     vw = viv_utils.getWorkspace(path, analyze=False, should_save=False)
  14   │   File "/home/user/env/lib/python3.8/site-packages/viv_utils-0.6.5-py3.8.egg/viv_utils/__init__.py", line 101, in getWorkspace
  15   │     vw.loadFromFile(fp)
  16   │   File "/home/user/env/lib/python3.8/site-packages/vivisect/__init__.py", line 2676, in loadFromFile
  17   │     fname = mod.parseFile(self, filename, baseaddr=baseaddr)
  18   │   File "/home/user/env/lib/python3.8/site-packages/vivisect/parsers/pe.py", line 36, in parseFile
  19   │     return loadPeIntoWorkspace(vw, pe, filename, baseaddr=baseaddr)
  20   │   File "/home/user/env/lib/python3.8/site-packages/vivisect/parsers/pe.py", line 366, in loadPeIntoWorkspace
  21   │     for rva, lname, iname in pe.getImports():
  22   │   File "/home/user/env/lib/python3.8/site-packages/PE/__init__.py", line 452, in getImports
  23   │     return self.imports
  24   │   File "/home/user/env/lib/python3.8/site-packages/PE/__init__.py", line 1172, in __getattr__
  25   │     self.parseImports()
  26   │   File "/home/user/env/lib/python3.8/site-packages/PE/__init__.py", line 796, in parseImports
  27   │     self.imports = self.parseImportTable(x, irva, is_imports=True)
  28   │   File "/home/user/env/lib/python3.8/site-packages/PE/__init__.py", line 878, in parseImportTable
  29   │     funcname = ibn.Name
  30   │   File "/home/user/env/lib/python3.8/site-packages/vstruct/__init__.py", line 420, in __getattr__
  31   │     return r.vsGetValue()
  32   │   File "/home/user/env/lib/python3.8/site-packages/vstruct/primitives.py", line 601, in vsGetValue
  33   │     s = self._vs_value.split(b'\x00')[0].decode('utf-8')
  34   │ UnicodeDecodeError: 'utf-8' codec can't decode byte 0x98 in position 0: invalid start byte
```
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
IDA is surprisingly forgiving. I don't think we should be. if invalid ASCII then skip.

note there are valid k32 entries before and after the corrupt ones, so we should skip the bad ones rather then bail.

Closed 2021-08-20.

Thread 443 (2021-08-23):

ELF regression: read exception in symbol table parsing

williballenthin, 2021-08-23:
```
> vivbin -B ~/code/capa-pub/tests/data/7351f8a40c5450557b24622417fc478d.elf_
Traceback (most recent call last):
  File "/home/user/code/vivisect/env/bin/vivbin", line 11, in <module>
    load_entry_point('vivisect', 'console_scripts', 'vivbin')()
  File "/home/user/code/vivisect/vivisect/vivbin.py", line 98, in main
    vw.loadFromFile(fname, fmtname=args.parsemod)
  File "/home/user/code/vivisect/vivisect/__init__.py", line 2728, in loadFromFile
    fname = mod.parseFile(self, filename=filename, baseaddr=baseaddr)
  File "/home/user/code/vivisect/vivisect/parsers/elf.py", line 30, in parseFile
    return loadElfIntoWorkspace(vw, elf, filename=filename, baseaddr=baseaddr)
  File "/home/user/code/vivisect/vivisect/parsers/elf.py", line 525, in loadElfIntoWorkspace
    valu = vw.readMemoryPtr(sva)
  File "/home/user/code/vivisect/envi/memory.py", line 181, in readMemoryPtr
    return self.readMemValue(va, self.imem_psize)
  File "/home/user/code/vivisect/envi/memory.py", line 170, in readMemValue
    raise Exception("Read gave wrong length at va: 0x%.8x (wanted %d got %d)" % (addr, size, len(bytes)))
Exception: Read gave wrong length at va: 0x00409c08 (wanted 8 got 4)
```

only started seeing this in the v1.0.4 release

sample: https://github.com/fireeye/capa-testfiles/blob/master/7351f8a40c5450557b24622417fc478d.elf_
this is our *one* ELF test file for capa, so that has me a bit worried about how thoroughly regression tested the new ELF changes are. hopefully its just a random one off :-)

williballenthin, 2021-08-23:
`sva` log:
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

exception at read pointer from 0x409c08

williballenthin, 2021-08-23:
its weird that `readMemoryPtr` can both return None and raise an exception:

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

Closed 2021-08-25.

Thread 445 (2021-08-26):

elf: analysis regression in v1.0.4

williballenthin, 2021-08-26:
as originally identified by @TcM1911 in https://github.com/fireeye/capa/issues/744, v1.0.4 regresses in its analysis coverage of ELF binaries.

to reproduce, i've developed [a script](https://gist.github.com/williballenthin/8566a1043532479c51ebb22a5b590db1) that can be run upon various viv tags and summarizes analysis coverage. we can optionally consider incorporating this script into viv proper and/or its CI.

here are results against two linux ELF files:

### RedXor malware / 7351f8a40c5450557b24622417fc478d
https://www.virustotal.com/gui/file/0423258b94e8a9af58ad63ea493818618de2d8c60cf75ec7980edcaa34dcc919/detection

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

### sudo / 9fd556b58393b71d64da277c8f782ef4d1dccffd007495709375d2efa85d1248
https://www.virustotal.com/gui/file/9fd556b58393b71d64da277c8f782ef4d1dccffd007495709375d2efa85d1248/detection

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

mr-tz, 2021-08-31:
If I restore `vivisect/analysis/elf/elfplt.py` from a7b5f8deef35dca1a31fe7ac6ff7732578cc3e76 I get better results again
```
2021-08-31 15:51:04,906:INFO:vivisect: Percentage of discovered executable surface area: 76.1% (91447 / 120100)[__init__.py:vprint:181:MainThread]
2021-08-31 15:51:04,906:INFO:vivisect:    Xrefs/Blocks/Funcs:                             (7083 / 2561 / 297)[__init__.py:vprint:181:MainThread]
2021-08-31 15:51:04,906:INFO:vivisect:    Locs,  Ops/Strings/Unicode/Nums/Ptrs/Vtables:   (17558:  15892 / 664 / 0 / 78 / 82 / 0)[__init__.py:vprint:181:MainThread]
2021-08-31 15:51:04,906:INFO:vivisect: stats: {'functions': 297, 'relocations': 80}[vivbin.py:main:128:MainThread]
```

Can you give an estimate on when you can track this down or provide pointers for me to find the issue here?

rakuy0, 2021-08-31:
So I have one fix down. It fixes one file (9fd556b58393b71d64da277c8f782ef4d1dccffd007495709375d2efa85d1248) and most of the other (0423258b94e8a9af58ad63ea493818618de2d8c60cf75ec7980edcaa34dcc919). I tracked down the second of my issues with the second binary, so now I'm mostly writing scripts to pull features from one version of synapse and bring them forward so I can encode a more explicit test on these binaries.

I should have a PR up later this week depending on my schedule and whether or not Tropical Storm Ida knocks my power out.

mr-tz, 2021-09-01:
Sounds great. Thanks for your work and the update!

Closed 2021-09-10.

Thread 446 (2021-08-30):

i386 rep emulation incorrect

mr-tz, 2021-08-30:
The current emulator runs the rep prefix for every instruction.

Per the Intel manual: "The behavior of the REP prefix is undefined when used with non-string instructions."

Example assembly resulting in incorrect / slow emulation decrementing undefined `ecx` value.
```asm
.text:00402107 74 07                             jz      short loc_402110
.text:00402109 F3 C3                             rep retn
```

References:
- https://repzret.org/p/repzret/
- https://stackoverflow.com/questions/10258918/what-happens-when-a-rep-prefix-is-attached-to-a-non-string-instruction

Closed 2021-09-01.

Thread 461 (2021-09-21):

extend funcentries database with additional common prologs

williballenthin, 2021-09-21:
we should extend the list of recognized function prologs so that more code can be brute forced. this issue stems from a key function being missed as reported here:  https://github.com/fireeye/capa/issues/783

a couple resources:
  - the patterns database used by ghidra: https://github.com/NationalSecurityAgency/ghidra/tree/79d8f164f8bb8b15cfb60c5d4faeb8e1c25d15ca/Ghidra/Processors/x86/data/patterns
  - function padding prevalence: https://gist.github.com/stevemk14ebr/d117e8d0fd1432fb2a92354a034ce5b9
  - other resources: https://github.com/williballenthin/lancelot/issues/96

alternatively, perhaps we could add more logic, like: for each pointer to executable data, does it look like code? and/or match a looser set of signatures?

atlas0fd00m, 2021-12-04:
in theory i like the idea of the intelligence being in here...
on deeper reflection, however, Viv works to never actually use the function prologs for identification, although that's something we can discuss.  instead, ideally Viv identifies functions based on code-flow and function emulation.

we have recently reworked how Viv does ELF PLT analysis, so the plt_popen and plt_recv (etc) should be better identified, even if they are not called from within the code.

Viv's philosophy has always been "better to not identify than to be wrong,"  which is why function prolog identification has been less than desirable for us.  that doesn't mean we can't fix and improve the systems which aren't doing their job.  it just means that the ways in which we improve them may not be the simplest.  ideally we'd like to identify functions by them being referenced as functions and/or called.  if they are referenced (like pushing a function pointer to the stack), we run heuristics to identify what it is most likely.  to test if it's a function, Viv spins up an WorkspaceEmulator and looks for sanity as code (eg.  we find a IF_RET (envi's arch-agnostic flag for "return") instruction, and a few other "function" tests... namely "we don't error out or fail to parse the next instruction"

has this been resolved for you?
i show that Viv identifies a few of the functions complained to be missing:

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

i don't want this to drop off the radar if it's not satisfactory for your team.

thanks,
@

williballenthin, 2021-12-06:
yup, understood. recorded it here for awareness, but i get that its not a planned feature for vivisect. i believe we can add such functionality/analysis passes outside of viv, so no problems here.

ma77carpenter, 2021-12-06:
this is still an open conversation in my opinion.  let's keep talking.

if, after my comment, you still want prolog-hunting,  what do you think about an analysis module that digs through at the end of autoanalysis (like we do with Pointers), but is an optional analysis module (not enabled by default)?

how would you feel about providing a PR to consider (just for the analysis and prefixes/prologs)?  then we can decide how best to enable/disable it?

atlas0fd00m, 2021-12-06:
this is still an open conversation in my opinion. let's keep talking.

if, after my comment, you still want prolog-hunting, what do you think about an analysis module that digs through at the end of autoanalysis (like we do with Pointers), but is an optional analysis module (not enabled by default)?

how would you feel about providing a PR to consider (just for the analysis and prefixes/prologs)? then we can decide how best to enable/disable it?

williballenthin, 2021-12-06:
> what do you think about an analysis module that digs through at the end of autoanalysis (like we do with Pointers), but is an optional analysis module (not enabled by default)?

yeah, this is probably what I'm talking about. such an analysis pass can live either within or external to vivisect, [like we do with FLIRT](https://github.com/williballenthin/viv-utils/blob/master/viv_utils/flirt.py).

> how would you feel about providing a PR to consider

absolutely. im happy to provide an implementation once i've figured out what we want. i wouldn't expect to lay that effort on you. though, i dont have a timeframe on this - probably just when i feel like we want it again.

Closed 2021-12-06.

Thread 468 (2021-10-28):

Emulate ELF 32bit ARM EABI4 linux ERROR

bat-serjo, 2021-10-28:
Works for any ARM thumb binary.

```
$ file 868bae84fefa69c4715540f1d509fb61
868bae84fefa69c4715540f1d509fb61: ELF 32-bit LSB executable, ARM, EABI4 version 1 (SYSV), statically linked, with debug_info, not stripped
```

Open in vivbin and try run command "emulate  <some_function_name_from_the_binary>"
```
> emulate  868bae84fefa69c4715540f1d509fb61.table_init

ERROR: (ModuleNotFoundError) No module named 'envi.archs.arm.thumb'
```

Seems like this part of the code has lagged behind.

Closed 2021-11-16.

Thread 484 (2021-12-10):

feature/bugfix: View Prefs saved periodically during Remote Workspace session

atlas0fd00m, 2021-12-10:
currently view preferences (what windows are open and where they live) is saved when you save a workspace.  since remote workspaces aren't ever explicitly saved from the client end, this never occurs.

Thread 485 (2021-12-10):

feature: list Keystroke Bindings in help

atlas0fd00m, 2021-12-10:
we can also make them user-modifiable, but at least we should let the user figure out how to be faster and more powerful from the keyboard.

Thread 497 (2022-01-13):

elf: SegmentationViolation on simple Linux kernel module

williballenthin, 2022-01-13:
```
❯ python -m capa.main ~/Downloads/82dae644c7a956a41d70097b7a749ca26fc6e04f0fa3186ee72955b2b5c550b6
loading : 100%|███████████████████████████| 658/658 [00:00<00:00, 2485.65 rules/s]
..  analyzing programINFO:Elf:self._parsePheaders
INFO:Elf:self._parseDynLinkInfo
INFO:Elf:self._parseSections
INFO:Elf:self._parseDynamicsFromSections
INFO:Elf:self._parseDynStrs
INFO:Elf:no dynamic string tableinfo found: DT_STRTAB: None  DT_STRSZ: None
INFO:Elf:self._parseDynSyms
INFO:Elf:self._parseDynRelocs
INFO:Elf:self._parseDynSymsFromSections
INFO:Elf:self._parseSectionSymbols
INFO:Elf:self._parseSectionRelocs
WARNING:Elf:_parseSectionRelocs: Reloc section differs from Dynamics: 0x8e0
INFO:Elf:section reloc: reloc: @0x1 4
INFO:Elf:section reloc: reloc: @0x8 11
INFO:Elf:section reloc: reloc: @0xd 4
WARNING:Elf:_parseSectionRelocs: Reloc section differs from Dynamics: 0x928
INFO:Elf:section reloc: reloc: @0x3 11
WARNING:Elf:_parseSectionRelocs: Reloc section differs from Dynamics: 0x958
INFO:Elf:section reloc: reloc: @0x0 1
WARNING:Elf:_parseSectionRelocs: Reloc section differs from Dynamics: 0x970
INFO:Elf:section reloc: reloc: @0x4 2
INFO:Elf:section reloc: reloc: @0xc 2
WARNING:Elf:_parseSectionRelocs: Reloc section differs from Dynamics: 0x9d0
INFO:Elf:section reloc: reloc: @0x150 1
INFO:Elf:section reloc: reloc: @0x380 1
INFO:Elf:done parsing ELF
INFO:vivisect:elf: no program headers found!
WARNING:vivisect.parsers.elf:unknown reloc type: 4  (at 0x1)
WARNING:vivisect.parsers.elf:00000000 (24) Elf64Reloca: reloc: @0x1 4
00000000 (08)   r_offset: 0x00000001 (1)
00000008 (08)   r_info: 0x1300000004 (81604378628)
00000010 (08)   r_addend: 0xfffffffffffffffc (18446744073709551612)

WARNING:vivisect.parsers.elf:unknown reloc type: 11  (at 0x8)
WARNING:vivisect.parsers.elf:00000000 (24) Elf64Reloca: reloc: @0x8 11
00000000 (08)   r_offset: 0x00000008 (8)
00000008 (08)   r_info: 0x30000000b (12884901899)
00000010 (08)   r_addend: 0x00000000 (0)

WARNING:vivisect.parsers.elf:unknown reloc type: 4  (at 0xd)
WARNING:vivisect.parsers.elf:00000000 (24) Elf64Reloca: reloc: @0xd 4
00000000 (08)   r_offset: 0x0000000d (13)
00000008 (08)   r_info: 0x1500000004 (90194313220)
00000010 (08)   r_addend: 0xfffffffffffffffc (18446744073709551612)

WARNING:vivisect.parsers.elf:unknown reloc type: 11  (at 0x3)
WARNING:vivisect.parsers.elf:00000000 (24) Elf64Reloca: reloc: @0x3 11
00000000 (08)   r_offset: 0x00000003 (3)
00000008 (08)   r_info: 0x30000000b (12884901899)
00000010 (08)   r_addend: 0x00000011 (17)

WARNING:vivisect.parsers.elf:unknown reloc type: 1  (at 0x0)
WARNING:vivisect.parsers.elf:00000000 (24) Elf64Reloca: reloc: @0x0 1
00000000 (08)   r_offset: 0x00000000 (0)
00000008 (08)   r_info: 0x100000001 (4294967297)
00000010 (08)   r_addend: 0x00000000 (0)

WARNING:vivisect.parsers.elf:unknown reloc type: 2  (at 0x4)
WARNING:vivisect.parsers.elf:00000000 (24) Elf64Reloca: reloc: @0x4 2
00000000 (08)   r_offset: 0x00000004 (4)
00000008 (08)   r_info: 0x100000002 (4294967298)
00000010 (08)   r_addend: 0x00000014 (20)

WARNING:vivisect.parsers.elf:unknown reloc type: 2  (at 0xc)
WARNING:vivisect.parsers.elf:00000000 (24) Elf64Reloca: reloc: @0xc 2
00000000 (08)   r_offset: 0x0000000c (12)
00000008 (08)   r_info: 0x200000002 (8589934594)
00000010 (08)   r_addend: 0x0000000c (12)

WARNING:vivisect.parsers.elf:unknown reloc type: 1  (at 0x150)
WARNING:vivisect.parsers.elf:00000000 (24) Elf64Reloca: reloc: @0x150 1
00000000 (08)   r_offset: 0x00000150 (336)
00000008 (08)   r_info: 0x1400000001 (85899345921)
00000010 (08)   r_addend: 0x00000000 (0)

WARNING:vivisect.parsers.elf:unknown reloc type: 1  (at 0x380)
WARNING:vivisect.parsers.elf:00000000 (24) Elf64Reloca: reloc: @0x380 1
00000000 (08)   r_offset: 0x00000380 (896)
00000008 (08)   r_info: 0x1200000001 (77309411329)
00000010 (08)   r_addend: 0x00000000 (0)

INFO:vivisect.parsers.elf:sva==0, using relocation name: 1: ''
INFO:vivisect.parsers.elf:sva==0, using relocation name: 1: ''
INFO:vivisect.parsers.elf:sva==0, using relocation name: 1: ''
INFO:vivisect.parsers.elf:sva==0, using relocation name: 1: ''
INFO:vivisect.parsers.elf:sva==0, using relocation name: 1: ''
INFO:vivisect.parsers.elf:sva==0, using relocation name: 1: ''
INFO:vivisect.parsers.elf:sva==0, using relocation name: 1: ''
INFO:vivisect.parsers.elf:sva==0, using relocation name: 1: ''
INFO:vivisect.parsers.elf:sva==0, using relocation name: 1: ''
INFO:vivisect.parsers.elf:sva==0, using relocation name: 1: ''
INFO:vivisect.parsers.elf:sva==0, using relocation name: 1: ''
INFO:vivisect.parsers.elf:sva==0, using relocation name: 1: ''
INFO:vivisect.parsers.elf:sva==0, using relocation name: 1: ''
INFO:vivisect.parsers.elf:sva==0, using relocation name: 1: ''
INFO:vivisect.parsers.elf:sva==0, using relocation name: 1: ''
INFO:vivisect.parsers.elf:sva==0, using relocation name: 1: ''
INFO:vivisect.parsers.elf:sva==0, using relocation name: 1: ''
INFO:vivisect:Failed to find file for 0x00000000 (__this_module) (and filelocal == True!)
Traceback (most recent call last):
  File "/usr/lib/python3.8/runpy.py", line 194, in _run_module_as_main
    return _run_code(code, main_globals, None,
  File "/usr/lib/python3.8/runpy.py", line 87, in _run_code
    exec(code, run_globals)
  File "/home/user/code/capa-pub/capa/main.py", line 1095, in <module>
    sys.exit(main())
  File "/home/user/code/capa-pub/capa/main.py", line 986, in main
    extractor = get_extractor(
  File "/home/user/code/capa-pub/capa/main.py", line 463, in get_extractor
    vw = get_workspace(path, format, sigpaths)
  File "/home/user/code/capa-pub/capa/main.py", line 403, in get_workspace
    vw = viv_utils.getWorkspace(path, analyze=False, should_save=False)
  File "/home/user/code/viv-utils/viv_utils/__init__.py", line 106, in getWorkspace
    vw.loadFromFile(fp)
  File "/home/user/env/lib/python3.8/site-packages/vivisect-1.0.5-py3.8.egg/vivisect/__init__.py", line 2737, in loadFromFile
    fname = mod.parseFile(self, filename=filename, baseaddr=baseaddr)
  File "/home/user/env/lib/python3.8/site-packages/vivisect-1.0.5-py3.8.egg/vivisect/parsers/elf.py", line 31, in parseFile
    return loadElfIntoWorkspace(vw, elf, filename=filename, baseaddr=baseaddr)
  File "/home/user/env/lib/python3.8/site-packages/vivisect-1.0.5-py3.8.egg/vivisect/parsers/elf.py", line 531, in loadElfIntoWorkspace
    valu = vw.readMemoryPtr(sva)
  File "/home/user/env/lib/python3.8/site-packages/vivisect-1.0.5-py3.8.egg/envi/memory.py", line 187, in readMemoryPtr
    return self.readMemValue(va, self.imem_psize)
  File "/home/user/env/lib/python3.8/site-packages/vivisect-1.0.5-py3.8.egg/envi/memory.py", line 169, in readMemValue
    bytes = self.readMemory(addr, size)
  File "/home/user/env/lib/python3.8/site-packages/vivisect-1.0.5-py3.8.egg/envi/memory.py", line 539, in readMemory
    raise envi.SegmentationViolation(va)
envi.exc.SegmentationViolation: SegmentationViolation('Bad Memory Access: 0x0')
```

originally reported here: https://github.com/mandiant/capa/issues/867

note there are no program headers, only section headers:

```
❯ readelf -a 82dae644c7a956a41d70097b7a749ca26fc6e04f0fa3186ee72955b2b5c550b6
ELF Header:
  Magic:   7f 45 4c 46 02 01 01 00 00 00 00 00 00 00 00 00
  Class:                             ELF64
  Data:                              2's complement, little endian
  Version:                           1 (current)
  OS/ABI:                            UNIX - System V
  ABI Version:                       0
  Type:                              REL (Relocatable file)
  Machine:                           Advanced Micro Devices X86-64
  Version:                           0x1
  Entry point address:               0x0
  Start of program headers:          0 (bytes into file)
  Start of section headers:          2808 (bytes into file)
  Flags:                             0x0
  Size of this header:               64 (bytes)
  Size of program headers:           0 (bytes)
  Number of program headers:         0
  Size of section headers:           64 (bytes)
  Number of section headers:         25
  Section header string table index: 24

Section Headers:
  [Nr] Name              Type             Address           Offset
       Size              EntSize          Flags  Link  Info  Align
  [ 0]                   NULL             0000000000000000  00000000
       0000000000000000  0000000000000000           0     0     0
  [ 1] .note.gnu.build-i NOTE             0000000000000000  00000040
       0000000000000024  0000000000000000   A       0     0     4
  [ 2] .note.Linux       NOTE             0000000000000000  00000064
       0000000000000024  0000000000000000   A       0     0     4
  [ 3] .text             PROGBITS         0000000000000000  00000088
       0000000000000000  0000000000000000  AX       0     0     1
  [ 4] .init.text        PROGBITS         0000000000000000  00000088
       0000000000000014  0000000000000000  AX       0     0     1
  [ 5] .rela.init.text   RELA             0000000000000000  000008e0
       0000000000000048  0000000000000018   I      22     4     8
  [ 6] .exit.text        PROGBITS         0000000000000000  0000009c
       000000000000000c  0000000000000000  AX       0     0     1
  [ 7] .rela.exit.text   RELA             0000000000000000  00000928
       0000000000000030  0000000000000018   I      22     6     8
  [ 8] .rodata.str1.1    PROGBITS         0000000000000000  000000a8
       0000000000000024  0000000000000001 AMS       0     0     1
  [ 9] __mcount_loc      PROGBITS         0000000000000000  000000cc
       0000000000000008  0000000000000000   A       0     0     1
  [10] .rela__mcount_loc RELA             0000000000000000  00000958
       0000000000000018  0000000000000018   I      22     9     8
  [11] .modinfo          PROGBITS         0000000000000000  000000d4
       00000000000000b4  0000000000000000   A       0     0     1
  [12] .orc_unwind_ip    PROGBITS         0000000000000000  00000188
       0000000000000010  0000000000000000   A       0     0     1
  [13] .rela.orc_unwind_ RELA             0000000000000000  00000970
       0000000000000060  0000000000000018   I      22    12     8
  [14] .orc_unwind       PROGBITS         0000000000000000  00000198
       0000000000000018  0000000000000000   A       0     0     1
  [15] __versions        PROGBITS         0000000000000000  000001c0
       00000000000000c0  0000000000000000   A       0     0     32
  [16] .data             PROGBITS         0000000000000000  00000280
       0000000000000000  0000000000000000  WA       0     0     1
  [17] .gnu.linkonce.thi PROGBITS         0000000000000000  00000280
       00000000000003c0  0000000000000000  WA       0     0     64
  [18] .rela.gnu.linkonc RELA             0000000000000000  000009d0
       0000000000000030  0000000000000018   I      22    17     8
  [19] .bss              NOBITS           0000000000000000  00000640
       0000000000000000  0000000000000000  WA       0     0     1
  [20] .comment          PROGBITS         0000000000000000  00000640
       0000000000000050  0000000000000001  MS       0     0     1
  [21] .note.GNU-stack   PROGBITS         0000000000000000  00000690
       0000000000000000  0000000000000000           0     0     1
  [22] .symtab           SYMTAB           0000000000000000  00000690
       0000000000000210  0000000000000018          23    17     8
  [23] .strtab           STRTAB           0000000000000000  000008a0
       000000000000003c  0000000000000000           0     0     1
  [24] .shstrtab         STRTAB           0000000000000000  00000a00
       00000000000000f2  0000000000000000           0     0     1
Key to Flags:
  W (write), A (alloc), X (execute), M (merge), S (strings), I (info),
  L (link order), O (extra OS processing required), G (group), T (TLS),
  C (compressed), x (unknown), o (OS specific), E (exclude),
  l (large), p (processor specific)

There are no section groups in this file.

There are no program headers in this file.

There is no dynamic section in this file.

Relocation section '.rela.init.text' at offset 0x8e0 contains 3 entries:
  Offset          Info           Type           Sym. Value    Sym. Name + Addend
000000000001  001300000004 R_X86_64_PLT32    0000000000000000 __fentry__ - 4
000000000008  00030000000b R_X86_64_32S      0000000000000000 .rodata.str1.1 + 0
00000000000d  001500000004 R_X86_64_PLT32    0000000000000000 printk - 4

Relocation section '.rela.exit.text' at offset 0x928 contains 2 entries:
  Offset          Info           Type           Sym. Value    Sym. Name + Addend
000000000003  00030000000b R_X86_64_32S      0000000000000000 .rodata.str1.1 + 11
000000000008  001500000004 R_X86_64_PLT32    0000000000000000 printk - 4

Relocation section '.rela__mcount_loc' at offset 0x958 contains 1 entry:
  Offset          Info           Type           Sym. Value    Sym. Name + Addend
000000000000  000100000001 R_X86_64_64       0000000000000000 .init.text + 0

Relocation section '.rela.orc_unwind_ip' at offset 0x970 contains 4 entries:
  Offset          Info           Type           Sym. Value    Sym. Name + Addend
000000000000  000100000002 R_X86_64_PC32     0000000000000000 .init.text + 0
000000000004  000100000002 R_X86_64_PC32     0000000000000000 .init.text + 14
000000000008  000200000002 R_X86_64_PC32     0000000000000000 .exit.text + 0
00000000000c  000200000002 R_X86_64_PC32     0000000000000000 .exit.text + c

Relocation section '.rela.gnu.linkonce.this_module' at offset 0x9d0 contains 2 entries:
  Offset          Info           Type           Sym. Value    Sym. Name + Addend
000000000150  001400000001 R_X86_64_64       0000000000000000 init_module + 0
000000000380  001200000001 R_X86_64_64       0000000000000000 cleanup_module + 0

The decoding of unwind sections for machine type Advanced Micro Devices X86-64 is not currently supported.

Symbol table '.symtab' contains 22 entries:
   Num:    Value          Size Type    Bind   Vis      Ndx Name
     0: 0000000000000000     0 NOTYPE  LOCAL  DEFAULT  UND
     1: 0000000000000000     0 SECTION LOCAL  DEFAULT    4
     2: 0000000000000000     0 SECTION LOCAL  DEFAULT    6
     3: 0000000000000000     0 SECTION LOCAL  DEFAULT    8
     4: 0000000000000000     0 SECTION LOCAL  DEFAULT    1
     5: 0000000000000000     0 SECTION LOCAL  DEFAULT    2
     6: 0000000000000000     0 SECTION LOCAL  DEFAULT    3
     7: 0000000000000000     0 SECTION LOCAL  DEFAULT    9
     8: 0000000000000000     0 SECTION LOCAL  DEFAULT   11
     9: 0000000000000000     0 SECTION LOCAL  DEFAULT   12
    10: 0000000000000000     0 SECTION LOCAL  DEFAULT   14
    11: 0000000000000000     0 SECTION LOCAL  DEFAULT   15
    12: 0000000000000000     0 SECTION LOCAL  DEFAULT   16
    13: 0000000000000000     0 SECTION LOCAL  DEFAULT   17
    14: 0000000000000000     0 SECTION LOCAL  DEFAULT   19
    15: 0000000000000000     0 SECTION LOCAL  DEFAULT   20
    16: 0000000000000000     0 SECTION LOCAL  DEFAULT   21
    17: 0000000000000000   960 OBJECT  GLOBAL DEFAULT   17 __this_module
    18: 0000000000000000    12 FUNC    GLOBAL DEFAULT    6 cleanup_module
    19: 0000000000000000     0 NOTYPE  GLOBAL DEFAULT  UND __fentry__
    20: 0000000000000000    20 FUNC    GLOBAL DEFAULT    4 init_module
    21: 0000000000000000     0 NOTYPE  GLOBAL DEFAULT  UND printk

No version information found in this file.

Displaying notes found in: .note.gnu.build-id
  Owner                Data size        Description
  GNU                  0x00000014       NT_GNU_BUILD_ID (unique build ID bitstring)
    Build ID: dc941d6e3f77657bcbacf3d2d23c06b7a209e00d

Displaying notes found in: .note.Linux
  Owner                Data size        Description
  Linux                0x00000010       OPEN
   description data: 35 2e 31 30 2e 30 2d 31 30 2d 61 6d 64 36 34 00
```

atlas0fd00m, 2023-02-22:
is this resolved?

mr-tz, 2023-02-23:
Yeah, there's no SegmentationViolation on current master. Looking forward to the next release 😄

atlas0fd00m, 2023-02-23:
watch for it.  it's coming, probably still this week :)

https://github.com/vivisect/vivisect/pull/576

Closed 2023-02-23.

Thread 499 (2022-01-19):

UnicodeDecodeError on PE section names

mmaps, 2022-01-19:
There is a UnicodeDecodeError in vstruct when getting a PE file's section name that has non-ascii characters. To fix this, I'd like to see if Vivisect would be open to a possible breaking change where section names are returned as bytes instead of strings?

To repro the issue, run this script on a file with a non-ascii character in the section name. I created [a test case here](https://github.com/mmaps/HelloSection).
```
import PE
import sys
pe_fd = open(sys.argv[1])
pe = PE.PE(pe_fd)
[s.Name for s in pe.getSections()]
```
The first fix I tried was a try/except UnicodeDecodeError in VStruct.__getattr__. However, I'm not sure if this is acceptable because you will get back a mixed bag of types determined by UnicodeDecodeErrors:
```
420             try:
421                 return r.vsGetValue() # str
422             except UnicodeDecodeError:
423                 return r.vsEmit() # bytes
```
The mixed bag:
```
>>> [s.Name for s in pe.getSections()]
[b'\xffPX0\x00\x00\x00\x00', 'UPX1', '.rsrc']
```
There doesn't seem to me to be another place to handle the decoding issue and/or to avoid the type problem. The section Name property is resolved lazily via magic methods which then call vstruct primitives vsGetValue. And, consumers of pe.getSections don't have another way afaict to fetch the Name bytes without triggering the issue in the __getattr__ call. That's why I think to handle these weird cases, we should just get bytes back. Other libs do return bytes for section names, so there is some precedent.

rakuy0, 2022-01-20:
So I would recommend using the `PE.peFromFileName` API, because it handles what I think is the problem here.

Due to python 3 separating the types of `bytes` and `str` to two completely separate types (instead of in python 2 where they were synonymous with each other), all files that vivisect operates on have to be opened with the `b` flag enabled. So in this case, you should be able to change this line:
`pe_fd = open(sys.argv[1])`
To this:
`pe_fd = open(sys.argv[1], 'rb')`

And everything should work properly, because the `IMAGE_SECTION_NAME` struct in vstruct defines the name as a `v_str`, which when `vsGetValue` is called for the name, decodes it int a utf-8 string.

So try that fix out for your script and lemme know how it goes.

mmaps, 2022-01-21:
> vstruct defines the name as a v_str, which when vsGetValue is called for the name, decodes it int a utf-8 string

This is exactly the issue, though, isn't it? We can't decode this into a string:
```
>>> b"\xfftext".decode("utf-8")
Traceback (most recent call last):
  File "<stdin>", line 1, in <module>
UnicodeDecodeError: 'utf-8' codec can't decode byte 0xff in position 0: invalid start byte
```

I observe the same result when explicitly opening in binary read:
```
Python 3.8.10 (default, Nov 26 2021, 20:14:08)
[GCC 9.3.0] on linux
Type "help", "copyright", "credits" or "license" for more information.
>>> import PE
>>> fin=open("test.exe", "rb")
>>> pe=PE.PE(fin)
>>> print([s.Name for s in pe.getSections()])
Traceback (most recent call last):
  File "<stdin>", line 1, in <module>
  File "<stdin>", line 1, in <listcomp>
  File "/tmp/venv/lib/python3.8/site-packages/vstruct/__init__.py", line 420, in __getattr__
    return r.vsGetValue()
  File "/tmp/venv/lib/python3.8/site-packages/vstruct/primitives.py", line 618, in vsGetValue
    s = self._vs_value.split(b'\x00')[0].decode('utf-8')
UnicodeDecodeError: 'utf-8' codec can't decode byte 0xff in position 0: invalid start byte
```

williballenthin, 2022-01-21:
> That's why I think to handle these weird cases, we should just get bytes back

From a correctness perspective, I think I prefer this solution, as well. @mmaps demonstrates that invalid "strings" can be placed into section names and the Windows loader doesn't care, so we probably can't make any assumptions about the content of this field.

Downsides:
  - its not as convenient to render, but we could add a `section.getBestName()` method
  - its a breaking change

mmaps, 2022-01-21:
> Which binary is that one?
The wrong one. :)

Sorry about that, I uploaded the emoji case that I was messing around with. [This is the actual error program](https://github.com/mmaps/HelloSection/blob/main/HelloSection-err.exe). When executed it will print "text" i/o ".text" (or i/o of ☺).

rakuy0, 2023-02-24:
I believe this is fixed?

Thread 512 (2022-03-18):

emu memory patching doesn't work easily

williballenthin, 2022-03-18:
Its difficult/impossible for users to patch emulator instance memory, for example, to nop out instructions. A couple reasons:

  1. `protectMemory` isn't implemented for emulator instances (see #511)
  2. emulator `parseOpcode` reads from the underlying workspace imemory, not the emulator imemory

(1) I can fix and PR. (2) is not so easy: there's a opcode caching subsystem for vw - should this be duplicated in the emulator? why does the emulator even read from the underlying vw at all?

williballenthin, 2022-03-18:
i suppose this means self-modifying code doesn't work today

rakuy0, 2022-03-23:
Currently the emulator doesn't handle self-modifying code due to our opcode caching approach.  We're planning to fix it in v2.0.  Right now the emulator reads from the underlying vw memory to gain *significant* performance increase, and we're still working out some questions like how we want to stably represent new/edited code, overlapping code locations (which we still kinda have issues with right now), and multi-function codeblocks to name a few. Some of @atlas0fd00m's recent work helps with it, but I know there's a still a non-zero number of things we've gotta do before plumbing it all the way through the event system.  But that's more from the perspective of how VivWorkspace handles/see things, and less from the perspective of the WorkspaceEmulator

As for the caching, the emulator reading from the underlying workspace memory was part of me answering some performance problems related to emulation in the short term because I knew at the time a proper 2.0 was still a while away given the part time nature of both atlas and myself and the fact 1.0 was still fresh. The emulator was getting pretty bogged down on my end just running in the emulator, so the caching actually gave some decent speed ups because we finally have a cache that would actually have entries get hit.

But for emulating self-modifying code (and not pushing things through the event system) can be worked around though. We can work up a PR that bypasses reading the workspace's memory maps via an option or prepopulates the emulator cache with the values from the workspace. But I'd like to keep some level of caching because of how much it helps.

I'd love a PR for 1. though :smile:. I know @atlas0fd00m is busy on his end and I'm just getting back into things after moving. Maybe add an option (similar to strictops) for disabling the memory checking though?

atlas0fd00m, 2022-12-19:
fyi - we have a solution for self-modifying code issue (2).  it's in master as of October 25, but not cut in a release.  it requires setting the emulator "usecache" field to False or specifically calling `parseOpcode(..., skipcache=True)`

memory patching/self-modifying code is very important to the future of Viv, and hits my work pretty regularly as well.

would be interested in a PR for (1).

man, the year got away from us.  apologies for the long delay.  we've been working to become more regular with PR's and releases.  we'll continue to work toward consistency and timeliness.

Thread 538 (2022-08-04):

Pip install vivisect[gui] errors out on windows

TomSomerville, 2022-08-04:
When trying to install vivisect[gui] on windows 11 Pro and windows 11 Enterprise via `pip install vivisect[gui]`, the install fails during the 'preparing metadata (pyproject.toml)' step. Full install text from a fresh Windows 11 install below.

PS C:\Users\User> python --version
Python 3.10.6
PS C:\Users\User> python -m pip --version
pip 22.2.1 from C:\Users\User\AppData\Local\Programs\Python\Python310\lib\site-packages\pip (python 3.10)
PS C:\Users\User> pip install vivisect[gui]
Collecting vivisect[gui]
  Downloading vivisect-1.0.8-py3-none-any.whl (4.2 MB)
     ---------------------------------------- 4.2/4.2 MB 14.0 MB/s eta 0:00:00
Collecting pycparser>=2.20
  Downloading pycparser-2.21-py2.py3-none-any.whl (118 kB)
     ---------------------------------------- 118.7/118.7 kB 6.8 MB/s eta 0:00:00
Collecting cxxfilt<0.3.0,>=0.2.1
  Downloading cxxfilt-0.2.2-py2.py3-none-any.whl (3.9 kB)
Collecting pyasn1<0.5.0,>=0.4.5
  Downloading pyasn1-0.4.8-py2.py3-none-any.whl (77 kB)
     ---------------------------------------- 77.1/77.1 kB ? eta 0:00:00
Collecting pyasn1-modules<0.3.0,>=0.2.4
  Downloading pyasn1_modules-0.2.8-py2.py3-none-any.whl (155 kB)
     ---------------------------------------- 155.3/155.3 kB ? eta 0:00:00
Collecting msgpack<1.1.0,>=1.0.0
  Downloading msgpack-1.0.4-cp310-cp310-win_amd64.whl (61 kB)
     ---------------------------------------- 61.3/61.3 kB ? eta 0:00:00
Collecting pyqt5==5.15.1
  Downloading PyQt5-5.15.1.tar.gz (3.3 MB)
     ---------------------------------------- 3.3/3.3 MB 26.0 MB/s eta 0:00:00
  Installing build dependencies ... done
  Getting requirements to build wheel ... done
  Preparing metadata (pyproject.toml) ... error
  error: subprocess-exited-with-error

  × Preparing metadata (pyproject.toml) did not run successfully.
  │ exit code: 1
  ╰─> [29 lines of output]
      Traceback (most recent call last):
        File "C:\Users\User\AppData\Local\Programs\Python\Python310\lib\site-packages\pip\_vendor\pep517\in_process\_in_process.py", line 156, in prepare_metadata_for_build_wheel
          hook = backend.prepare_metadata_for_build_wheel
      AttributeError: module 'sipbuild.api' has no attribute 'prepare_metadata_for_build_wheel'

      During handling of the above exception, another exception occurred:

      Traceback (most recent call last):
        File "C:\Users\User\AppData\Local\Programs\Python\Python310\lib\site-packages\pip\_vendor\pep517\in_process\_in_process.py", line 363, in <module>
          main()
        File "C:\Users\User\AppData\Local\Programs\Python\Python310\lib\site-packages\pip\_vendor\pep517\in_process\_in_process.py", line 345, in main
          json_out['return_val'] = hook(**hook_input['kwargs'])
        File "C:\Users\User\AppData\Local\Programs\Python\Python310\lib\site-packages\pip\_vendor\pep517\in_process\_in_process.py", line 160, in prepare_metadata_for_build_wheel
          whl_basename = backend.build_wheel(metadata_directory, config_settings)
        File "C:\Users\User\AppData\Local\Temp\pip-build-env-b6fd2tnt\overlay\Lib\site-packages\sipbuild\api.py", line 46, in build_wheel
          project = AbstractProject.bootstrap('wheel',
        File "C:\Users\User\AppData\Local\Temp\pip-build-env-b6fd2tnt\overlay\Lib\site-packages\sipbuild\abstract_project.py", line 87, in bootstrap
          project.setup(pyproject, tool, tool_description)
        File "C:\Users\User\AppData\Local\Temp\pip-build-env-b6fd2tnt\overlay\Lib\site-packages\sipbuild\project.py", line 584, in setup
          self.apply_user_defaults(tool)
        File "C:\Users\User\AppData\Local\Temp\pip-install-mk03oxh7\pyqt5_f6c33d6e78a7445090d170531639feb9\project.py", line 64, in apply_user_defaults
          super().apply_user_defaults(tool)
        File "C:\Users\User\AppData\Local\Temp\pip-build-env-b6fd2tnt\overlay\Lib\site-packages\pyqtbuild\project.py", line 70, in apply_user_defaults
          super().apply_user_defaults(tool)
        File "C:\Users\User\AppData\Local\Temp\pip-build-env-b6fd2tnt\overlay\Lib\site-packages\sipbuild\project.py", line 236, in apply_user_defaults
          self.builder.apply_user_defaults(tool)
        File "C:\Users\User\AppData\Local\Temp\pip-build-env-b6fd2tnt\overlay\Lib\site-packages\pyqtbuild\builder.py", line 67, in apply_user_defaults
          raise PyProjectOptionException('qmake',
      sipbuild.pyproject.PyProjectOptionException
      [end of output]

  note: This error originates from a subprocess, and is likely not a problem with pip.
error: metadata-generation-failed

× Encountered error while generating package metadata.
╰─> See above for output.

note: This is an issue with the package mentioned above, not pip.
hint: See above for details.

[notice] A new release of pip available: 22.2.1 -> 22.2.2
[notice] To update, run: python.exe -m pip install --upgrade pip
PS C:\Users\User>

rakuy0, 2022-08-18:
Hmm. That's weird. I'll pull down a windows 11 vm later tonight to see what's going on. Some QT binary might not be being built/pulled down on windows. That's my current working theory at least.

TomSomerville, 2022-09-06:
So looking at this error again, it appears that the version installed via pip != main currently.
When I install via pip, install crashes on Collecting pyqt5==5.15.1

Main has pyqt5==5.15.7 in the setup file.

If I clone main > `cd ./vivisect/` > `pip install -e .[gui]`

install completes fine, and vivbin executes without issue.

If I `pip uninstall vivisect` > `cd  ~` > and then `pip install vivisect[gui]

install is back to pyqt5==5.15.1 and install crashes.

I THINK updating what is available in pip should fix the issue?

x00tox01, 2023-01-13:
When trying to PIP install vivisect[gui] on windows 10 x64 bit.
I am also getting same issue.
WHILE I am able to successfully install the PyQt==5.15.7 (latest) but not PyQt==5.15.1.

rakuy0, 2023-01-13:
So I think you're getting the same issue because I haven't had a chance to cut another release. I wanted to get #551 knocked out via the open PR, but real life stuff came up in December so that's taken longer than anticipated. Once that's in we can cut 1.1.0 since it's been far too long since a proper release and that should fix this issue for people installing things.

rakuy0, 2023-02-24:
Should be fixed in v1.1.0

Closed 2023-02-24.

Thread 551 (2022-11-14):

x86 Linux dissasembly broken

LesChats, 2022-11-14:
Very simple asm code:
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
`nasm -f elf32 foo.s -o foo.o && gcc -m32 -O2  foo.o`
what it is expected: (`r2 a.out`)
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
what I get: (`vivbin a.out)`
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

LesChats, 2022-11-14:
This is a simple example, but I get that type of bug on all my x86 samples. Part of op code are not interpreted, mostly after (int 80, ret, and calls)

rakuy0, 2022-11-15:
Oh. I see the issue. We just do a blanket "this interrupt doesn't have any branches" for any and all `int` instructions on x86 instead of falling through. We don't filter down any OS information, so interpreting `int 0x80` as a syscall specifically on linux-x86 isn't happening. That has ramifications down the line for whether or not we decide if `main` is a function or not after some emulation.

I'll poke at a fix for the `int 0x80` issue and have a PR up sometime this week.  Thanks for bringing this up!

Closed 2023-02-24.

Thread 574 (2023-02-09):

getBranches may return (None, flags) - expected

mr-tz, 2023-02-09:
`getBranches` returns a list of tuples with (target VA of the branch, possible set of flags).

I think we should guard against VA being `None` like in the example below or are callers expected to check this (some vivisect internal calls do so)? For the latter, the documentation should at least be updated.

```asm
.text:001A1325 68 00 80 00 00                    push    8000h
.text:001A132A 53                                push    ebx
.text:001A132B FF B5 A8 FC FF FF                 push    [ebp+lpParameters]
.text:001A1331 FF D6                             call    esi ; dword_1AC0EC
.text:001A1333
.text:001A1333                   loc_1A1333:                             ; CODE XREF: sub_1A1112+E5↑j
.text:001A1333                                                           ; sub_1A1112+211↑j
.text:001A1333 8B 4D FC                          mov     ecx, [ebp+var_4]
```
- from the sample linked in https://github.com/mandiant/flare-floss/issues/617#issuecomment-1381120965

`getBranches()` on the `call esi` returns `[(0x1A1333, 65552), (None, 65537)]`

`(None, 65537)` appears because `getOperValue()` returns `None` for `esi` (without an emulator).

atlas0fd00m, 2023-02-13:
this is intended behavior, and allows the code-flow engine to tag dynamic branches (which is later used to look for and analyze switch-cases).

atlas0fd00m, 2023-02-13:
you're correct about the documentation.

Closed 2023-03-26.

Thread 580 (2023-02-23):

load VSnap files into VDBBin for Emulation

atlas0fd00m, 2023-02-23:
see https://github.com/vivisect/vivisect/issues/579 for context around VSnaps

we have a rich emulation environment which we could use to provide a VDB-like interface to an emulator from a VSnap.
we've done something like a Emulation-backed VDB session in the distant past.  the concept has been ripe for a come-back.

VDB would want to add emulation-awareness, including the ability to make good use of the snapshotting capabilities of emulators, and deal with the fact that file descriptors and network sockets, etc... will no longer be connected, and handle Syscalls.
this is something currently provided (and constantly being developed) in the VivisectION plugin, but some of this functionality just belongs in Vivisect/VDB proper.

Thread 582 (2023-02-23):

make the CallGraph GUI window a sane starting size

atlas0fd00m, 2023-02-23:
currently it is tiny and in the upper left corner of the wrong screen!

Closed 2024-08-12.

Thread 590 (2023-03-15):

`v1.1.1` including dynamic import updates

mr-tz, 2023-03-15:
Opening this up here for better visibility. A small point release would great.

              Amazing, thanks for the quick fix. Can you please provide a `v1.1.1` release with these updates?

_Originally posted by @mr-tz in https://github.com/vivisect/vivisect/issues/587#issuecomment-1465234383_

mr-tz, 2023-04-03:
Friendly bump on this as we're prepping a new capa release and would like to include vivisect improvements.

williballenthin, 2023-04-03:
they may be patiently awaiting my fixes in #562

atlas0fd00m, 2023-04-08:
done.

Closed 2023-04-08.

Thread 601 (2023-03-29):

rework i386 calling convention analysis

atlas0fd00m, 2023-03-29:
there's a lot of thiscall_caller/thiscall/bfastcall mistakes.

recent example (cdecl misidentified as bfastcall due to "or eax, 0xffffffff" which is really setting it to -1):
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

this current project is misidentifying cdecl as thiscall_caller *all over*.  definitely want to tighten that up, as long as 32-bit intel is interesting.

Thread 616 (2023-05-20):

VDB - stubborn malware using system time

99bobster99, 2023-05-20:
I am a vivisect newbie, so please forgive me should my request be trivial or already implemented.

Would it be possible to add a "step into" feature which runs as a continuous cycle, without having to select "step into" each time? I tried using "continuous mode" to analyze a piece of malware, but I only see the loading and unloading of the binaries and not the individual assembler commands, as you do when you use the "step into" option.

The issue is, I'm encountering some smart malware that must reference the system clock to see how long it takes for the code execution. Obviously, this exits the code prematurely.

If possible adding (or letting me know how to do it in VDB) a feature that traces the assembler commands in real-time, as well as recording the state of each of the registers, would be a really nice feature for vivisect.

So far, your program looks amazing! I just stumbled upon it today.

99bobster99, 2023-05-22:
Hey atlas0fd00, thank you for the detailed response!

I've got "honey-do-list" chores to do today, but I'm looking forward to trying your suggestions out tomorrow! :)

I'm hoping that the "Stepi -A 0" option you suggested will give me a list of all the assembly instructions and addresses.

I'm not finding a lot of Vivisect tutorials on the web. I found this [one](https://github.com/vivisect/vivisect/issues/120), that directs you to a (3) part series done over at INAP, but it looks like only "part 1" is still available. Most of the references on this old 2016 vivisect issue response are dead. :(

Do you happen to have a copy of the other (2) INAP parts, or are there any other tutorials you'd recommend?

[INAP - Part 2](https://www.singlehop.com/blog/binary-vivisection-part-2/)
[INAP - Part 3](https://www.singlehop.com/blog/binary-vivisection-part-3/)

atlas0fd00m, 2023-05-24:
hey @99bobster99 ,

yes, it's common for the UI to stop responding, and the process as well, while single-stepping.  single-stepping it wildly inefficient, requiring the OS to get involved and return control back to VDB after each instruction.  using the non-GUI mode for this is at least somewhat better, since the GUI can have a bunch of windows that think they deserve to get updated after each stepi.

and please accept my apologies for the ugliness.  we've discovered a number of bugs in the VDB code that we have recently (or are working on) fixed but hasn't made it into a release.

i've been working on a list of tutorial things to make Vivisect more accessible.  i'm not sure how much will be Video or otherwise, but i'm interested in help.  care to help out?  it'd be great experience, and we might just make Vivisect/VDB better suit your needs in the process :)

currently the only docs i can point you to are at https://vivisect.readthedocs.io

@

atlas0fd00m, 2023-05-24:
wow, i just found this today.  it's not really about VDB, per se, but is a good intro to Vivisect itself:

https://www.youtube.com/watch?v=K55b8w39oC8

99bobster99, 2023-05-25:
Hey atlas0fd00,

No need to apologize, Vivisect looks awesome already! Absolutely, I'd love to help out, with whatever I can contribute. Send me any newer version you'd like me to test drive. I have a few other binaries I'm playing around with in order to learn more about reversing.

I've also been playing around with IDA Pro, x64dbg and Immunity Debugger. So far I like the "environment" isolation approach the best, that you've structured Vivisect around.

Thank you for the Youtube link to Vivisect/Vivida, I'm watching it now! :)

atlas0fd00m, 2024-01-08:
there are ways to break on various time-accessors, or analyze each step to identify things like the x86 RDTSC instruction, which is a common malware method of tracking time (for anti-debugging)

Thread 618 (2023-06-06):

Performance issues

Dobatymo, 2023-06-06:
Hi, I was suggested to post this issue here (see https://github.com/mandiant/flare-floss/issues/743). I am encountering very high ram usage and extremely long processing times when analyzing a sample.

I tried to analyze LINE.exe (version: 7.17.0.3035, sha256: 37aa29719c130e7b86d84253bd5fefa1ebeeb1b516bf7ea0c250ffeaa932833b, virus total: https://www.virustotal.com/gui/file/37aa29719c130e7b86d84253bd5fefa1ebeeb1b516bf7ea0c250ffeaa932833b) I get after installing https://desktop.line-scdn.net/win/new/LineInst.exe. I know this exe is Themida protected, which might complicate things.

atlas0fd00m, 2023-06-28:
sorry, this has been a crazy few weeks, and i'm just getting over being sick, but i wanted to check on this.  how good an analysis does IDA do?  they don't do emulation by default.  is there something else that they may not be doing?

i'm not trying to cast stones and i don't want to blow you off.  i want to get a good representation of ground truth so we can emulate apples to apples... ultimately allowing us to know when we are done.

thanks!
@

atlas0fd00m, 2023-06-29:
continuing to look into this, but here's probably the problem:

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

That 30MB function is simply not what Viv expects.  lol.

we'll check into what's really causing the delay, but it could be purely two things, neither of which are likely to change:
* Vivisect is Pure Python - it brings great benefits for making it easy to understand, extend, and write analysis tools for... but it's going to be slower than C/C++ tools
* Vivisect annotates *every* location in a database.  that takes time and memory to pre-calculate, but it makes xrefs and location finding super simple and cost-effective when looking up what lives at a given location and how big it is.  to ensure that i'm being clear, *every* asm opcode gets its own location entry.  i'm pretty sure IDA does block level tracking, which can cause it to get confused more easily when analyzing code that doesn't want to be analyzed.

still, we'll see if we can make this more performant...
it could be something completely different as well.

@rakuy0 : (for your awareness)

mr-tz, 2023-11-17:
Thanks for the work on #622. I now see vivisect analysis stuck for `37aa29719c130e7b86d84253bd5fefa1ebeeb1b516bf7ea0c250ffeaa932833b`:
```
...
[vivbin.py:main:128]
Beginning analysis...
Extended Analysis: vivisect.analysis.generic.linker
2023-11-17 10:01:19,706:INFO:vivisect.analysis.generic.linker: linking Imports with Exports[linker.py:analyze:19]
Extended Analysis: vivisect.analysis.generic.entrypoints
2023-11-17 10:01:19,707:DEBUG:vivisect: processEntryPoint: 0x3890058[__init__.py:processEntryPoints:804]
2023-11-17 10:01:19,707:DEBUG:vivisect: makeFunction(0x3890058, None, 0x0)[__init__.py:makeFunction:1552]
2023-11-17 10:01:19,707:DEBUG:envi.codeflow: addCodeFlow(0x3890058, 0x0)[codeflow.py:addCodeFlow:142]
2023-11-17 10:01:19,708:DEBUG:envi.codeflow: descending into function 0x38901a8 (from 0x3890058)[codeflow.py:addCodeFlow:251]
2023-11-17 10:01:19,708:DEBUG:envi.codeflow: addCodeFlow(0x38901a8, 0x10001)[codeflow.py:addCodeFlow:142]
2023-11-17 10:01:19,715:INFO:vivisect.analysis.generic.switchcase: 0x38901ed: reg != imagebase (0x4156d00f != 0x400000)[switchcase.py:getSwitchBase:94]
2023-11-17 10:01:19,732:DEBUG:vivisect: processEntryPoint: 0x144d3b0[__init__.py:processEntryPoints:804]
2023-11-17 10:01:19,732:DEBUG:vivisect: makeFunction(0x144d3b0, None, 0x0)[__init__.py:makeFunction:1552]
2023-11-17 10:01:19,732:DEBUG:envi.codeflow: addCodeFlow(0x144d3b0, 0x0)[codeflow.py:addCodeFlow:142]
```

Is that an unrelated issue? 0x144d3b0 is the address of an export.

`9cc387fd485e91fc58a626d2c64b85e0502ba60f3718afd7b5fd6e5b46721bb9` completes now 👍

Thread 635 (2023-11-08):

Memory exhaustion - likely due to incorrect section parsing

mr-tz, 2023-11-08:
Analyzing malware sample (sha256: c177e0a9e745a247a944f805189daf4c2f3f059340290c8c0ec0861bacaa8316) results in memory exhaustion.

```
vivbin.exe -vvvv -B c177e0a9e745a247a944f805189daf4c2f3f059340290c8c0ec0861bacaa8316
2023-11-08 14:17:21,380:DEBUG:vivisect.parsers.pe: initial file baseva: 0x400000  size: 0xe064d3a2[pe.py:loadPeIntoWorkspace:91]
2023-11-08 14:17:21,391:INFO:vivisect.parsers.pe: loadPeIntoWorkspace:  loading 'c177e0a9e745a247a944f805189daf4c2f3f059340290c8c0ec0861bacaa8316' (size: 0xe064d3a2) at 0x400000[pe.py:loadPeIntoWorkspace:93]
2023-11-08 14:17:21,418:INFO:vivisect.parsers.pe: PE loader: Arch: 'i386'       Format: pe      Platform: 'windows'     Filename: 'c177e0a9e745a247a944f805189daf4c2f3f059340290c8c0ec0861bacaa8316'       BaseAddr: 0x400000[pe.py:loadP
eIntoWorkspace:118]
2023-11-08 14:17:21,418:INFO:vivisect.parsers.pe: PE Imagebase: 0x400000        entry: 0x40859e codebase: 0x1000        codesize: 0x8000[pe.py:loadPeIntoWorkspace:134]
2023-11-08 14:17:21,420:INFO:vivisect.parsers.pe: PE dllname: None      fvivname: 'c177e0a9e745a247a944f805189daf4c2f3f059340290c8c0ec0861bacaa8316'       md5: '5afcd5cc66ab0ddf68b1368d356bcea3' sha256: 'C177E0A9E745A247A944F805189DA
F4C2F3F059340290C8C0EC0861BACAA8316'[pe.py:loadPeIntoWorkspace:150]
2023-11-08 14:18:22,404:ERROR:vivisect.base: Traceback (most recent call last):
  File "\vivisect\vivisect\base.py", line 636, in _fireEvent
    self.ehand[event](einfo)
  File "\vivisect\vivisect\base.py", line 424, in _handleADDMMAP
    self.blockmap.initMapLookup(va, blen)
  File "\vivisect\envi\pagelookup.py", line 53, in initMapLookup
    marray = [obj] * size
MemoryError
```

The issue seems to be that the section table (section headers) offset gets identified as 480 (0x1E0) instead of 488 (0x1E8) which then leads to parsing a section with VirtualSize 2019914798.

atlas0fd00m, 2023-11-09:
confirmed:

```
$ vivbin -vvvvvvvvvv -B c177e0a9e745a247a944f805189daf4c2f3f059340290c8c0ec0861bacaa8316
2023-11-09 14:14:47,837:DEBUG:vivisect.parsers.pe: initial file baseva: 0x400000  size: 0xe064d3a2[pe.py:loadPeIntoWorkspace:91]
2023-11-09 14:14:47,838:INFO:vivisect.parsers.pe: loadPeIntoWorkspace:  loading 'c177e0a9e745a247a944f805189daf4c2f3f059340290c8c0ec0861bacaa8316' (size: 0xe064d3a2) at 0x400000[pe.py:loadPeIntoWorkspace:93]
2023-11-09 14:14:47,861:INFO:vivisect.parsers.pe: PE loader: Arch: 'i386'       Format: pe      Platform: 'windows'     Filename: 'c177e0a9e745a247a944f805189daf4c2f3f059340290c8c0ec0861bacaa8316'    BaseAddr: 0x400000[pe.py:loadPeIntoWorkspace:118]
2023-11-09 14:14:47,861:INFO:vivisect.parsers.pe: PE Imagebase: 0x400000        entry: 0x40859e codebase: 0x1000        codesize: 0x8000[pe.py:loadPeIntoWorkspace:134]
2023-11-09 14:14:47,864:INFO:vivisect.parsers.pe: PE dllname: None      fvivname: 'c177e0a9e745a247a944f805189daf4c2f3f059340290c8c0ec0861bacaa8316'    md5: '5afcd5cc66ab0ddf68b1368d356bcea3' sha256: 'C177E0A9E745A247A944F805189DAF4C2F3F059340290C8C0EC0861BACAA8316'[pe.py:loadPeIntoWorkspace:150]
2023-11-09 14:14:47,864:DEBUG:vivisect.base: Adding Memory Map: 0x400000(0x1000 big) name: 'c177e0a9e745a247a944f805189daf4c2f3f059340290c8c0ec0861bacaa8316'  (align: None)[base.py:_handleADDMMAP:421]
getting struct 'pe.IMAGE_DOS_HEADER':  IMAGE_DOS_HEADER
getting struct 'pe.IMAGE_FILE_HEADER':  IMAGE_FILE_HEADER
getting struct 'pe.IMAGE_OPTIONAL_HEADER':  IMAGE_OPTIONAL_HEADER
getting struct 'pe.IMAGE_SECTION_HEADER':  IMAGE_SECTION_HEADER
2023-11-09 14:14:49,627:DEBUG:vivisect.base: Adding Memory Map: 0x400074(0x7865742e big) name: 'c177e0a9e745a247a944f805189daf4c2f3f059340290c8c0ec0861bacaa8316'  (align: 4096)[base.py:_handleADDMMAP:421]
getting struct 'pe.IMAGE_SECTION_HEADER':  IMAGE_SECTION_HEADER
2023-11-09 14:15:01,050:DEBUG:vivisect.base: Adding Memory Map: 0x7f406174(0x6164722e big) name: 'c177e0a9e745a247a944f805189daf4c2f3f059340290c8c0ec0861bacaa8316'  (align: 4096)[base.py:_handleADDMMAP:421]
Killed
```

still uncertain why it's loading that map.  will have to schedule some time to investigate.  any input/context you may be able to add about this bin would be awesome.  otherwise, we'll have to look through the PE parser and look for ways it differs from the PE Loader.  if there's simply logic as to why this is misreading or why this map wouldn't normally be loaded into RAM on a target, that would speed resolution ;)
(yes, i'm asking if you've done part of my job for me already ;)

thx either way!

atlas0fd00m, 2023-11-09:
sorry, you already did give great context.
anything else is welcome, but i don't want to forget to appreciate this:
```
The issue seems to be that the section table (section headers) offset gets identified as 480 (0x1E0) instead of 488 (0x1E8) which then leads to parsing a section with VirtualSize 2019914798.
```

atlas0fd00m, 2023-11-09:
the reason i ask for anything else is because malware tends to exploit how an OS works in undocumented ways to make our jobs harder.   obviously you know that already  :)
so it could be us parsing the size wrong, or missing some other oddity that would use intentionally corrupted headers in a way that works on real hardware but breaks tools like ours.

mr-tz, 2023-11-10:
`PE.PE.parseSections()` calculates the offset to the start of the section headers.

In my limited testing and per my understanding [1] this should suffice to get the offset:
`off = self.IMAGE_DOS_HEADER.e_lfanew + len(self.IMAGE_NT_HEADERS)`

For the sample above that's 488 (0x1E8).

The issue here seems to be that the used calculation then subtracts the length of the `DataDirectory` before adding the `NumberOfRvaAndSizes * sizeof(IMAGE_DATA_DIRECTORY)`.

Here:
`len(self.IMAGE_NT_HEADERS.OptionalHeader.DataDirectory)` is `128`

and

`self.IMAGE_NT_HEADERS.OptionalHeader.NumberOfRvaAndSizes * len(vstruct.getStructure("pe.IMAGE_DATA_DIRECTORY"))` is `120` (where the last 8 bytes [Reserved, must be zero] are missing?)

Obviously, this is a core parsing part and worked well so far. So more testing and reading is necessary. I wanted to provide what I had so far though.

[1] The PE file header consists of a Microsoft MS-DOS stub, the PE signature, the COFF file header, and an optional header. A COFF object file header consists of a COFF file header and an optional header. **In both cases, the file headers are followed immediately by section headers.** - via https://learn.microsoft.com/en-us/windows/win32/debug/pe-format

atlas0fd00m, 2023-11-11:
thank you, @mr-tz !  that's truly very helpful analysis.

Thread 666 (2024-08-12):

archId not available for ARMv7A

jpsnyder, 2024-08-12:
When the architecture name is "ARMv7A", the arch constant is unable to be detected using `vw.arch.getArchId()`.

```fish
(vivisect) jon@fluffy ~/d/vivisect > file strings_arm                                                                           3.977s
strings_arm: ELF 32-bit LSB executable, ARM, EABI5 version 1 (SYSV), dynamically linked, interpreter /lib/ld-linux.so.3, BuildID[sha1]=36f857a4e75f227a253c7c70886a00cf51cc732d, for GNU/Linux 3.2.0, not stripped

(vivisect) jon@fluffy ~/d/vivisect > bpython                                                                                  288.314s
bpython version 0.24 on top of Python 3.12.4 /home/jon/.local/share/virtualenvs/vivisect-9xCeL38c/bin/python
>>> import vivisect
>>> vw = vivisect.VivWorkspace()
>>> vw.loadFromFile("strings_arm")
...
>>> vw.analyze()
...
>>> vw.arch.getArchId() is None
True
```

:imp: :imp: :imp:

atlas0fd00m, 2024-08-12:
see #668

i'm just gonna label this the SatanBug

atlas0fd00m, 2024-08-12:
sorry!  i didn't realize you submitted a PR or i would have just used that...

jpsnyder, 2024-08-12:
No worries, just care about it being fixed. :)

jpsnyder, 2024-08-12:
Also, unrelated, but I do run into errors analyzing my file.
It is trying to emulate `uhsaxvc`, but that address is actually suppose to be data not code.

```
0x102d4: opval=0x21008: brflags is BR_DEREF, but loctup is None.  Don't know what to do. skipping.  taint:None ('None')
0x102bc: FAIL: could not resolve name for 0x0.  Skipping.
PLT: 0x1030c - Could not find a branch!
Error emulating function 0x102c8
        []
Traceback (most recent call last):
  File "/home/jon/dev/vivisect/vivisect/analysis/arm/thunk_reg.py", line 109, in analyzeFunction
    emu.runFunction(fva, maxhit=1)
  File "/home/jon/dev/vivisect/vivisect/impemu/platarch/arm.py", line 298, in runFunction
    raise e
  File "/home/jon/dev/vivisect/vivisect/impemu/platarch/arm.py", line 239, in runFunction
    self.executeOpcode(op)
  File "/home/jon/dev/vivisect/envi/archs/arm/emu.py", line 348, in executeOpcode
    raise envi.UnsupportedInstruction(self, op)
envi.exc.UnsupportedInstruction: Unsupported Instruction: 0x00021038 uhsaxvc r6, r1, r6
0x102d4: opval=0x21008: brflags is BR_DEREF, but loctup is None.  Don't know what to do. skipping.  taint:None ('None')
0x102c8: FAIL: could not resolve name for 0x0.  Skipping.
Error in PLT-late analysis: TypeError("'NoneType' object is not iterable")
Traceback (most recent call last):
  File "/home/jon/dev/vivisect/vivisect/analysis/elf/elfplt_late.py", line 31, in analyze
    analyzePLT(vw, pltva, pltsz)
  File "/home/jon/dev/vivisect/vivisect/analysis/elf/elfplt_late.py", line 106, in analyzePLT
    fillPLTviaGOTXrefs(vw, jmpheur, pltva, pltsz)
  File "/home/jon/dev/vivisect/vivisect/analysis/elf/elfplt_late.py", line 149, in fillPLTviaGOTXrefs
    if isGOT(vw, xrto):
       ^^^^^^^^^^^^^^^
  File "/home/jon/dev/vivisect/vivisect/analysis/elf/elfplt_late.py", line 318, in isGOT
    for gotva, gotsz in gots.get(fname):
TypeError: 'NoneType' object is not iterable
_getNameParts('__TMC_END__'): fname is None (and shouldn't be)
_getNameParts('__TMC_END__'): fname is None (and shouldn't be)
```

Let me know if you would like me to create a separate issue.

atlas0fd00m, 2024-08-12:
yes, thank you for that.  please create a separate issue, just for better tracking down the road.

Closed 2024-08-12.

Thread 669 (2024-08-13):

Errors while trying to analyze non-code data in ARM

jpsnyder, 2024-08-13:
I am running into errors analyzing an ARM sample.
It is trying to emulate `uhsaxvc`, but that address is actually suppose to be data not code.

Sample can be found here: https://github.com/dod-cyber-crime-center/Dragodis/blob/master/tests/data/strings_arm

```
0x102d4: opval=0x21008: brflags is BR_DEREF, but loctup is None.  Don't know what to do. skipping.  taint:None ('None')
0x102bc: FAIL: could not resolve name for 0x0.  Skipping.
PLT: 0x1030c - Could not find a branch!
Error emulating function 0x102c8
        []
Traceback (most recent call last):
  File "/home/jon/dev/vivisect/vivisect/analysis/arm/thunk_reg.py", line 109, in analyzeFunction
    emu.runFunction(fva, maxhit=1)
  File "/home/jon/dev/vivisect/vivisect/impemu/platarch/arm.py", line 298, in runFunction
    raise e
  File "/home/jon/dev/vivisect/vivisect/impemu/platarch/arm.py", line 239, in runFunction
    self.executeOpcode(op)
  File "/home/jon/dev/vivisect/envi/archs/arm/emu.py", line 348, in executeOpcode
    raise envi.UnsupportedInstruction(self, op)
envi.exc.UnsupportedInstruction: Unsupported Instruction: 0x00021038 uhsaxvc r6, r1, r6
0x102d4: opval=0x21008: brflags is BR_DEREF, but loctup is None.  Don't know what to do. skipping.  taint:None ('None')
0x102c8: FAIL: could not resolve name for 0x0.  Skipping.
Error in PLT-late analysis: TypeError("'NoneType' object is not iterable")
Traceback (most recent call last):
  File "/home/jon/dev/vivisect/vivisect/analysis/elf/elfplt_late.py", line 31, in analyze
    analyzePLT(vw, pltva, pltsz)
  File "/home/jon/dev/vivisect/vivisect/analysis/elf/elfplt_late.py", line 106, in analyzePLT
    fillPLTviaGOTXrefs(vw, jmpheur, pltva, pltsz)
  File "/home/jon/dev/vivisect/vivisect/analysis/elf/elfplt_late.py", line 149, in fillPLTviaGOTXrefs
    if isGOT(vw, xrto):
       ^^^^^^^^^^^^^^^
  File "/home/jon/dev/vivisect/vivisect/analysis/elf/elfplt_late.py", line 318, in isGOT
    for gotva, gotsz in gots.get(fname):
TypeError: 'NoneType' object is not iterable
_getNameParts('__TMC_END__'): fname is None (and shouldn't be)
_getNameParts('__TMC_END__'): fname is None (and shouldn't be)
```

_Originally posted by @jpsnyder in https://github.com/vivisect/vivisect/issues/666#issuecomment-2284873453_

Thread 679 (2025-01-02):

.NET sample analysis

mr-tz, 2025-01-02:
In https://github.com/mandiant/flare-floss/issues/1087 a .NET sample causes vivisect issues:

```
INFO: vivisect: Beginning analysis...
INFO: vivisect: Extended Analysis: vivisect.analysis.generic.linker
INFO: vivisect.analysis.generic.linker: linking Imports with Exports
INFO: vivisect: Extended Analysis: vivisect.analysis.generic.entrypoints
DEBUG: vivisect: processEntryPoint: 0x47b39e
DEBUG: vivisect: makeFunction(0x47b39e, None, 0x0)
DEBUG: envi.codeflow: addCodeFlow(0x47b39e, 0x0)
```

I haven't looked too closely yet, but the issue seems to arise from `addCodeFlow` via `addEntryPoint`.

rakuy0, 2025-01-02:
Probably the bigger issue is that .NET binaries are kind their own thing sorta separate from i386/arm/ppc/etc. The CLR section gets populated with a big database of type info and the actual instructions are their own virtual machine bytecode instructions.

I've been poking at .NET support in #673, but it's all in my free time, so it might still be a while till that's fully fleshed out.

mr-tz, 2025-01-02:
Yes, absolutely. What do you think of an approach to initially detect .NET early on and not go down the standard path of code flow analysis that results in errors like this one?

rakuy0, 2025-01-06:
I'm not against bailing early if it's an architecture we know we don't properly support. @atlas0fd00m you have any thoughts?
