vivisect/vivisect/(list of files, drawings)

Other design files:
vivisect/qt/default.lyt
