vivisect/vivisect/(commit log)

2014-11-14 initial import from hg
    [_c_ast.cfg, default.lyt]
2014-11-14 killing off debug prints (and derping git)
2014-11-17 abstract listdir and readfile vtrace to prep for 'wiretrace'
2014-12-11 x86 jmp reg instruction now should return constraints for each known xref, allowing switch-cases to flow
2014-12-11 Viv Gui: if setting comment or name and current one exists, prepopulate the dialog box with the current one for editing.
2014-12-13 python3 print fiexs
2014-12-13 track dynamic branches in codeflow callbacks. (dual mode commit... both methods currently exist. pick one and remove loser before merging upstream)
2014-12-18 viv: dump QWebView-derived MemCanvas classes to HTML files (Memory View and FuncGraph View and Symboliks View). Sadly, we can't currently easily do this for the CallGraph or Tree Views (eg. Functions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
2015-02-05 revamp using signals and slots (G rated, i promise)
2015-02-06 signal/slot version
2015-02-06 cleanup and rework signal/slot connect/disconnect
2015-02-26 add i386 emulation for instruction 'lahf'
    using description of instruction found here: http://x86.renejeschke.de/html/file_module_x86_id_148.html
2015-02-27 ARM MSR decode bug and unit test
2015-02-27 enhancing ARM Register and Emulator/CConv data
2015-02-28 add initStackMemory method to emulator baseclass
    Call initStackMemory prior to readMemory/writeMemory to configure
    stack memory. Currently, this is only the stack size.
    If no explicit call to this new method, lazily call the method on
    first invocation of readMemory/writeMemory. This way we avoid
    making any breaking changes to the existing API.
2015-03-02 arm emulator tweaks: i_mov, fixed import
2015-03-03 massive ARM tweaks and bugfixes. ongoing. SAVE GAME. msr and flags and conditionals seem to work again.
2015-03-07 more arm emu tweaks. conditionals should work now, including those based on carry flag. carry flag was being incorrectly calculated for subtractions due to misreading the spec.
2015-05-09 fixed bug in suspend/resume thread on win32
2015-05-21 __dir__() for chaining proxies and basic introspection
2015-07-03 updates to ARM registers and emulator
2015-08-30 arm test stuffs
2015-09-25 update to codeflow that sets the location where the envi opcode things it's VA is. this allows for architectures like ARM/Thumb where the actual opcode VA may be different than the address handed int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
2015-09-25 codeflow improvements for Arm/Thumb
2015-09-25 bugfix for thumb mode 11bit offset branch true-up codeflow architecture-switching logic, collapsed b/bl/bx/blx logic blocks in ArmOpcode.getBranches
2015-10-04 arm - improved codeflow, bug fixes for calls
2015-10-28 commented print statement
2015-10-28 sample code to exercize code graphing with conditionals
2015-11-20 allow ARM PE binaries
2015-12-22 Partial rewrite of msp430 emulator. Multiple fixes.
    - Partial rewrite of the msp430 emulator:
    - Implement all the instruction set based on msp430 spec
    - Set status flags based on msp430 spec
    - TODO: Tests!
    - Encoding: Add helpers for bcd encoding (used by dadd in msp430)
    - Fix: Set architecture when creating a TraceEmulator
    - Fix: Fix boundary checks in probeMemory, which fixes an issue when
    searching in all memory maps
2015-12-30 Modify CobraProxy's _cobra_getsock method to allow caller to specify the thread the socket should be pulled from (defaulting to currentThread(), which was always the thread used before this change.
2016-01-02 Add tests for ADC, ADD, ADDC and AND
2016-01-15 stylistic (mostly) changes to tighten the code
2016-01-27 removed samplecode.py mods.
2016-01-27 logging updates for envi.archs.arm.emu.
2016-02-16 get rid of default tuple for props on graph.delNodesProps()
2016-03-17 make vw.parseOpcode use getCodeBlock to hand the entire memory map into archParseOpcode() so that ARM/THUMB MODE can make sense of parsing opcodes that start on odd VA's
2016-04-06 arm thumb adv simd/fp updates.
2016-04-09 stake in sand... arm emulation pass making great progress. just lost ground. savegame, and head back to find where we went wrong.
2016-04-14 ARM emulation analysis improvements.
2016-04-14 renamed arm thunk analysis module
2016-04-14 fixing set/getOper* functions for a couple Operands. implementing a few new instructions, and handling coprocessors/interrupts better.
2016-05-02 platforms/win32: convert print to logger.warn call
2016-05-06 pe parser: fix export parsing
    this patch fixes a bug in the PE parser identified when analyzing the Zeus sample with MD5 hash EA039A854D20D7734C5ADD48F1A51C34. This sample has a bunch of entries in the export name and ordinal tables, but no entries in the export address table.
    vivisect already correctly handles the case when the address table is smaller than the function table, but missed the edge case when the address table has no size.
2016-05-12 numerous arm decoding and emulation bugs and unittest fodder, including push/pop directionality bugs, branch-link LR bugs, and others. includes mainlined StringMemoryCanvas bug (reverted from commit 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
2016-05-12 fodder for arm unittests
2016-05-13 unify arm get/setOperValue/Addr and ArmOpcode.getOperValue() to universally support "update=" so we can set that across the board based on index-usage
2016-05-27 don't chop the .py extension if it exists. do we want to filter at all? scripts don't need the .py extension to be valid.
2016-05-29 fix pointer-location delete on codeblock analysis. if we run into a location that's a pointer during code-flow, most times it will not be identified on the location of the instruction, but offset. th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
2016-06-10 Removed extra spaces and updated init to read in current version from instantiation of the class.
2016-06-11 Slight updates and changes to unittest emulations. Special case works! Mostly.
2016-06-13 Added _IF_PSR_S_SIL for silent s, tagged emu issues for current commands, cleaned up the tests and fixed some comments.
2016-06-14 removed a couple extra spaces that showed up
2016-06-27 Fixed diff arm versions armModule thumbModule
2016-06-30 mods to make Arm*OffsetOpers use a particular pointer size (for getOperAddr)
2016-07-08 parse invalid resource section case
2016-08-17 cut most cost of revisiting the same symbolik objects in _reduce
2016-08-22 Turned print statement back off
2016-11-03 Addressing issue #160: self.attached = False
2016-11-09 temporary work on various approaches to non-recursively perform walkTree. currently walkTree5() is functionally equivalent to the original recursive walkTree().
    testing code (using an outdated version of KernelBase.dll.viv. selected a function which created a tenable but sufficiently complex AST for testing. ymmv):
    $ ipython
    >>> def cb_astNodeCount(path,obj,ctx):
    ctx['count'] += 1
    if len(path) > ctx['depth']:
    ctx['depth'] = len(path)
    print "\n\t%r\n\t\t%s" % (obj, '\n\t\t'.join([repr(x) for x in path]))
    # first show original recursive results
    >>> fva=0x7ff388ae060 ; ctx = {'count': 0, 'depth': 0};\
    spaths=sctx.getSymbolikPaths(fva);spath=spaths.ne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
2016-11-17 plumb architecture endianness support through envi, vivisect. allows setting endianness through the config setting "bigend" as it was intended. current code simply sets the metadata but ignores it fr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
2016-11-22 update ARM Operands unit test
2016-11-23 ARM MOVT instruction decoding
2016-11-23 working on Advanced SIMD for ARM
2016-11-28 All NON V ARM commands disassemble correctly now. Plus some housekeeping
2016-12-02 clean up print
2016-12-05 ran out of iflags space (>64bits makes msgpack choke) so we introduced simdflags. plumbed it through the decoders in arm/thumb.
2016-12-06 Safeguard in case of corrupt recsize
2016-12-17 crap. progress in vector decoding, improvement in Indexing/Writeback handling... but Arm->Thumb mode seems broken and i can't decode the actual vector instructions. still need to port vector to Arm m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
2016-12-20 make adv simd both thumb and arm. bug fixes, add F8, F16, F32, F64.
2016-12-30 more work on arm vector instructions
2017-01-05 a few more attempts at walkTree(). walkTree5() was not the guy. now it looks like it should be good, but the current test is going weird.
2017-01-20 clean up old and printing statements
2017-01-21 fix envi codeflow bug for ARM/THUMB switching
2017-01-21 code-flow improvements, added instructions
2017-01-21 more code-flow improvements, added instructions
2017-01-23 further improvements to arm/thumb
2017-01-25 mega blx bug (ARM Unconditional encoding requires switch to THUMB, even though the address specified is even) "swi" clean up to have all encodings translated to UAL 'svc'
2017-01-26 arm/thumb decoding improvements
2017-01-26 starting the mods for ARM Emulation helpers
2017-01-26 adding ARM emulation and disabling pointer discovery for BLOBs
2017-01-30 Bugfix: handle the event where func_args doesn't have info for function when deleting. currently, delFunction simply fails.
2017-02-15 ARM/THUMB decode/emulation improvements
2017-02-22 ARM/THUMB using architecture-dependent BadOps
2017-02-22 emulating more arm instrs
2017-03-01 lots of updates. just discovered floating point instructions aren't hard-wired into ARM yet, fixing next.
2017-03-03 floating point instruction wiring into arm, and thumb. lots of "opcode" rightness fixes. still decoding bugs to iron out.
2017-03-16 ARM INS_* used for opcodes, instead of calculated IENC_* based numbers (yech!)
2017-03-22 make parseOpcode() prototype consistent in the import emulator
2017-05-24 emulation and code-flow improvements, additional arm emu instructions covered.
2017-05-24 continued improvement: arm emulation
2017-05-24 updates to arm emu
2017-05-26 codeflow needs to hand flags/arch information around to correctly handle switches in architecture (like ARM/THUMB, etc...)
2017-05-26 watchdog reuses the same thread instead of creating a new thread every time watchdog() is called.
2017-06-02 remove threading/locking from PathGenerator. simply have the timeout be counted within the path generators.
2017-06-08 archModifyFuncAddr() now returns (va, {}) by default (ARM as well)
2017-08-23 ARM emu bug fixes
2017-08-23 arm function emulation analysis module.
2017-08-23 arm emu cleanup
2017-08-23 arm workspace emulator cleanup ad troubleshooting
2017-08-25 ARM emu fixes (primarily, Post-Indexing should work now)
2017-08-25 missed a couple.
2017-09-30 arm canvas updates
2018-03-09 arm/thumb decoding bug-fixes
2018-03-09 arm/thumb emulation enhancements/bug-fixes
2018-03-09 thumb decode, arm emu bugfixes.
2018-03-10 arm emulation improvement
2018-03-30 a couple logic bugs in detectUnicode. changed so that the charset-code can be anything but it better be the same thing (instead of 0x00)
2018-03-30 unsure of these ARM flags... FIXME:
2018-04-04 initial cleanup of ARM stuff.
2018-04-05 clean up and attempt at joint PyQt4 and PyQt5
2018-04-10 couple missed bugs
2018-04-13 updated arm/thumb archGetNopInstr
2018-08-20 arm/thumb bugfixes and enhancements
2018-08-22 arm elf plt tables use addition to calculate the got address. engage special arm emulator-based plt analysis!
2018-08-22 cleanup arm thunk_reg output (only display if verbose==True)
2018-08-30 thumb support wrapped into ELF parser and analysis modules (thumb-architecture, not the thumb part of arm... ie. Cortex-M series processors)
2018-08-30 basics of Thumb switchcases (TBH/TBB) analysis wrapped in. still refinement necessary. perhaps migrate this analysis into getbranches(emu) if that does the trick...
2018-08-30 clean up some print statements, and add name to branch table.
2018-09-06 lots of arm/thumb disasm and emulation bugfixes/improvements
2018-09-07 arm small bugfixes and cleanups.
2018-11-28 keyPress event handler bugfix.
    also, discovered the reason for having to explicitly handle all exceptions or crash:
    http://pyqt.sourceforge.net/Docs/PyQt5/incompatibilities.html
    as of PyQt5.5, PyQt no longer gracefully handles exceptions by printing a stack trace and continuing. this is *designed* behavior. i've handled as many exceptions as i know to, particularly in areas where users may extend Viv (including Interactive Python window execution). i'm looking into a way to reverse this behavior, in case visi would prefer the old safety-net, but for the time-being, this is the path forward. We have to explicitly handle our exceptions!
2018-11-30 no print!
2018-12-05 start for wrapping logging through vivisect and vdb. with a test message intended to show the logging format. currently:
    $ vivbin -vvv /bin/bash
    Skipping: [ Entry for header table itself] VMA: 0x00000040 offset: 64 memsize: 504 align: 8 (filesz: 504) flags: 4
    Skipping: [ Program interpreter] VMA: 0x00000238 offset: 568 memsize: 28 align: 1 (filesz: 28) flags: 4
    Loading: [ Loadable program segment] VMA: 0x00000000 offset: 0 memsize: 1060920 align: 2097152 (filesz: 1060920) flags: 5
    Loading: [ Loadable program segment] VMA: 0x00303d90 offset: 1064336 memsize: 86904 align: 2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
2018-12-30 initial solution:
    >>> import envi.expression as e_expr
    >>> x={'foo(bar)': 0x40, 'foo':0x60}
    >>> print e_expr.evaluate('foo(bar) + 1', x)
    65
    >>> print e_expr.evaluate('foo + 1', x)
    97
    >>> print e_expr.evaluate('32 + 1', x)
    33
    the question is whether we want this, where an effort is made first to resolve the expression without help, before performing replacement... or if we want to simply make evaluate() do replacement first.
2019-01-07 Names are hard. Also handle case where length of bytes to match is shorter than the final signature hit (and add test for it).
2019-01-11 print cleanup.
2019-01-15 cleanup (largely of print statements), and bugfix/better parsing/handling of UNDEFINED instructions.
2019-02-11 basic change to allow new files to be easily added to a workspace with a specified baseaddr. no linking is currently done.
2019-02-22 massive cleanup of arm regs... test cases bug-fixes in decoding and emulation.
2019-02-23 arm unit test enhancements (more coming...)
2019-02-27 improvements in ordering, ARM reloc coverage, and logging.
2019-03-18 So many little flake8 cleanups as I track down this unittest failure
2019-04-23 Add more relocations types to PE files (need moar). Fix potential bug in reloc analysis pass (that thankfully never triggered b/c we never used that case. flake8 fixes. moar instructions for symboliks
2019-04-23 Flake8 til the day I die. Also UI updates (open a file from just vivbin, hotkey shortcuts)
2019-04-25 A couple quality of life improvements for working in vivisect UI
2019-04-29 Decided to cut features off of this branch. It's growing out of control
2019-06-04 First cut at better prefix handling
2019-06-27 add a couple more no-return function names.
2019-07-11 __libc_start_main analysis mod for Elf. a couple options here for discussion and posterity. while the emulator approach for fmod is appealing, the one-shot mod is more practical... perhaps a merging 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
2019-07-31 ARM doesn't currently decode very well... unit tests cannot succeed. reverting.
2019-08-28 ARM bug which is likely fixed in the atlas_arm_fixes branch
2019-09-10 Test clean up (#250)
    * Still WIP. need to check on perf_update. Core concept for splitting a jump table on encountering another pointer to somewhere inside it is there. need to del codeblock refs on differing functions and add tests
    * vivbins isn't a thing anymore
    * handle case of differing functions for two consecutive jump tables
    * More tests for vivgraph and add comment to jump cases to tell us what other cases fall through to this one
    * test cleanup
    * Fix slight bug and add tests for vdir
    * moar long path tests
    * More tests
    * making things purty
    * Spelling
    * cut out some of the aesthetic changes for now
    * Carving out bugfix to new branch
    * Remove refs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
2019-09-18 convert print -> logger.warn
2019-12-28 one option for fixing... open to suggestions
    add "codeflow" argument to getOperValue() for both Opcode and Operand. VivWorkspace.makeOpcode() uses this option to avoid getting PC (or whatever PC's value is) when PC is referenced by opcodes such as ARM's "mov pc, lr". this delta is intended to fix erroneous XREFs which are getting put in whenever PC is used as an operand. due to ARM's pipelining, PC at the time of execution is +8, causing "mov pc, lr" to cause an XREF two instructions after the opcode, even though this instruction is IF_NOFALL.
2020-01-03 ARM updates to avoid making XREFS to PC+8
2020-02-19 amd64 decoding fixes (#269)
    * mark down codeflow note
    * Test clean up mostly
    * WIP
    * wip. but more fixed
    * stash current working state to do some other reviews
    * moar vm instructions
    * removing unnecessary tables and further fixups
    * the basic tests pass whaaaaaat
    * The VEX portion just...works? BLACK MAGIC
    * save working state. a lot more things line up now, but the 67 prefix isn't being honored at all, and I need to double check a ton of vex things
    * even more tests
    * addr shouldn't be a prefix anymore. It should just do it's effects. Working towards that
    * moar fixups. shelving 67 prefix stuff for another PR
    * the amd64 tests pass. But I need more. T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
2020-03-20 some responses to @rakuyo, a bunch of polish, a new instruction (mls), and some code-flow issues
2020-03-25 event handlers: tweak logging (#275)
    changes:
    - reduce verbosity of handle reloc log messages
    - uses logging instead of print for warning about deprecation
2020-03-25 cleanup and changed interrupt handling to use a dict instead of a list, enabling easier default handler configuration.
2020-03-25 added arm/elfplt analysis mod back into repo for now. improved it a bit... working toward improving elf/elfplt analysis mod to make this unnecessary. SAVEGAME
2020-03-27 updates to the ELF parser (for ARM Relocs)
2020-03-31 allow architecture to fixup Xrefs in vw._handleADDRELOC() (was causing all the THUMB relocations to completely screw up the locations database).
2020-04-10 bugfixes and normalizing emulation, elfplt and ARM ELF relocations...
2020-04-11 a few oddball non-ARM-specific fixes
2020-04-12 make pointers.py obey architecture-dependent pointer-alignment rules. (really nailed some horrible bugs in ARM analysis)
2020-06-08 Amd64 emulator updates (#276)
    AMD64 updates galore.
    Shortlist of features and fixes:
    * Experimental ieee754 decoder/encoder for intel
    * Vast additions to the emulators (symbolik and real) for i386/amd64
    * register updates for st* to have the mm* map to them like the manual says.
    * more opcodes
    * Better handling of the split size optypes
    * vtrace updates for getting the full ymm* registers
    * Better switchcase detection as a stopgap until the symbolik swithcase PR is in
    * reduce Call args for symboliks
    * A few more PE noret functions
    * Repr a loc when printing the location in the UI
    * Make the lockstepper work in 2020
    * Highlight fva when we navigate to it in the funcgraph from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
2020-07-17 Py3 Task #1 (#289)
    * no more xrange
    * travis ci
    * cleanup per review. And a test to prove that pycparser still works as intended.
    * msgpack 1.0 compat and pin requirements
    [_c_ast.cfg]
2020-08-03 WIP-minor ARM ELF tweaks (#290)
    * comment update
    * minor update to elfplt.
    * mostly added documentation, but start from bridx=0 for analyzing PLT info (we only need the first one, and sometimes there is only one)
    * improvements to ELFPLT: finding starting function (bugfix)
    * ELFPLT: rearrange location loading for "branch-reverse PLT Start" analysis
    * bugfix: codeblocks analyis: if running into an instruction previously described as LOC_POINTER, the call to makeCode didn't include any architecture context. this doesn't work for ARM when in Thumb mode. added "previous opcode" mode.
    also, rearranging "pointers" analysis module logging and error handling.
    * fixing the pointe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
2020-08-13 Plumb Caller Cleanups all the way through (#301)
    * forgot about these when doing the merge
    * TESTS
    * super small decoding fix
    * forget that print
    * moar tests per atlas
2020-08-18 minor bug fixes in ARM disassembly and emulation. helps get rid of some of the unittest error messages (yes, that's why they're there ;) (#305)
2020-09-08 Even More Syntax Cleanup (#293)
    A lot of cleanup things in prep for a python 3 transition. Getting rid of the old exception syntax, converting prints over to logging, cutting random scraps of code to be proper unit tests, cut away some older bits of code, etc.
    This still works in python2. It's just a lot of tidying up. There are no major functionality changes.
2020-09-25 getOperAddr normalization (#316)
    * normalizing the prototype for getOperAddr() in i386, and returning None for non-deref operand (default).
    * might as well update the "abstract" base class
    * more in line with other getOperAddr()
2020-09-25 minor change to allow access to the tuple and lists of ARM registers … (#315)
    * minor change to allow access to the tuple and lists of ARM registers (used in external tools). this brings the ARM regs.py more inline with the other architectures' regs.py
    * made the changes to arm_regs and arm_regs_tup, but didn't update the references. this actually makes accessing registers more efficient :)
2020-09-28 import emulator to handle dynamic branches (switchcases) using only xrefs (#314)
    * modify import emulator to handle dynamic branches (switchcases) using only xrefs.
    * bugfix: forgot that getBranches returns REF_CODE/BR_DEREF options which are *not* direct code branches (eg. PLT).
    added __ctype_b_loc to impapi
2020-11-20 November bughunt (#329)
    * We decode ud* correctly, but never really added a INS_* definition on it. So added those.
    * int1/icebp support since we apparently never had that
    * Making sure we don't codeflow past those and bring in a fix from my py3 branch on not code flowing past hlt instructions.
    * Even if we fail on codeblock addition, we at least we can add the metadata to the function dictionary.
    * We parse but do not make accessible the fixed file info from a PE file (should it be
    * Enable ARM analysis on PE
    * Pathcount in the UI had succumbed to bitrot and needed
    * Some symbolik reduction code coverage
    * Address #322
2021-01-13 Yet another grabbag o' stuff (#333)
    Feature list:
    * Better noreturn detection (and associated codeflow/api support)
    * Refreshing a couple public apis (updateCallsFrom and isProbablyCode)
    * Intel decoding updates for sfence and pmovmskb
    * Updating intel decoding tests
    * Some tweaks to emucode analysis for dealing with hydra functions and small switchcase blocks
    * More unit tests for imports and symboliks
    * thumb16 flag fixes
    * Making ARM emulator consistent with base emulator
    * Exception handling on IMAGE_RUNTIME_FUNCTION_ENTRY (since invalid values for that before would take down viv)
    * Remove deprecation warning on getGraphNodeByVa
2021-02-12 fixed viv memory view rendering single printable bytes (#355)
    * fixed memory view render bugs.
    * fixed viv memory view rendering single printable bytes
2021-02-13 Py3 Cleanup (#353)
    * clean up the emulators a bit. tried to use safemem to fix the bug, but that didn't work as intended.
    * ton of cleanup and test cleanup. and also emulator fix
    * found the edge case
    * Make the dirs on a save just in case
    * fix issue with v_zwstr in vstruct parsing and cleanup
    * Bunch of little fixups from division fixes for py2/3 stuff, a set of new intel instructions (from decoding all the way up to symboliks), to PE loading
    * Docstring updates, more unittests for vstruct, extension fix, memcanvas fix for certain edge cases. Overall: incorporating feedback from @willi and @atlas
    * custom log level
    * envi config encoding per @willi, getting memoryvi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
2021-02-19 renderer fix: don't want to print hex for undefined bytes since the hex of the byte is already there. (#364)
    debugging js addon.
2021-03-29 Cleanup (#385)
    * cleanup ELF parsing
    * minor ARM (embedded) bugfix on infinite-loop detection
    * cobra.cluster made usable after py3 upgrade.
    converting from str to bytes for network comms, but leaving everything
    as str's otherwise.
2021-04-02 More Intel Updates (#384)
    * Oh Boy. Doozy of an update.
    * Bunch of symboliks updates to make amd64/i386 play nicely together
    * A lot of decoding/emulator updates in support of the above
    * Small cobra change to make the tests not intermittently fail on grabbing a port
    * Shut the _findMemoryMaps traceback up. We shouldn't be trying to read from vsyscall anyway
    * fix some of the resource warnings that unittest was screaming about
    * fix some issues in vdb when using it from cmdline and address review comments
    * that shouldn't be there
    * comments and bump up vtrace test time
2021-04-06 Visgraph bug older than dirt (#387)
    * initial fixes.
    * ye old ancient visgraph del*Prop bugs... and unittests!
2021-04-06 Version Engineering (#388)
    Make verion bumping easier.
    [.bumpversion.cfg]
2021-04-19 FIX Issue #391, added check to prevent divide by zero error in "printDiscoveredStats". (#392)
2021-05-03 Prepare for v1.0.2 release (#398)
    [.bumpversion.cfg]
2021-05-03 Loosen requirements (#399)
    * bring requirements and setup in line with each other and loosen the exact version we need so that we at least get patch versions and make interopt-ing a thing
    * stop bump version from auto committing and tagging
    * bump version
    * CHANGELOG
    [.bumpversion.cfg]
2021-07-01 Fix Funcgraph UI Issues (#409)
    Fixes a pair of ancient UI issues in the funcgraph view
    * In the Py3/PyQt5 cutover, edge lines no longer highlighted on mouseover due to some event filtering that needed to take place. We returned true in the eventFilter and that stopped other handlers from running. We return false now so that other handlers can run.
    * Since the Qt cutover many years ago, edge lines have never fully highlighted on mouse over. They've only highlighted portions of them. This was due to the DynadagLayout class adding in ghost edges and nodes that would end up getting their own polylines and onmouseover handlers. Those all have been collapsed down.
2021-08-12 impapi windows/arm and winkern/arm (#431)
2021-08-19 Elf/Intel/Codeblocks fixes (#411)
    * missing instr
    * more tweaks while I track down some of these graph build messages
    * another sprawling commit. Lots of cleanup. decoding fix for intel, qgraphtree fix atlas pointed out that I had initially mised, more better thunk detection, slightly more accurate emucode, and working on but not finished elf relocation additions
    * back that out for now
    * more tweaks as I try and get elf tests passing again
    * tons of test data mostly and a reloc fix
    * test update
    * Make it slick thanks to willi
    * clean up a bunch of exception related stuff and doc the new function thunke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
2021-08-22 V104 release prep (#442)
    Prep for releasing v1.0.4
    [.bumpversion.cfg]
2021-09-22 V1.0.5 Release Prep (#449)
    v1.0.5 Release Prep
    [.bumpversion.cfg]
2021-11-11 fixing Viv/Vdb bridge and specifically ARM's extensions for Vdb (#469)
    * initial work. some nuancing still to be done...
    major: changed from using CLI to jumping to GUI. probably change to using CLI again, but make do_gui not crash...
    * rework getEmulator to add the ability to set the Program Counter at initialization. this allows us to use the VivWorkspace to set the ARM/THUMB mode if defined.
    * make VDB GUI available (but not default) from Vivisect's CLI :)
    * bugfix
2021-11-11 Various bugfixes mostly cli oriented (#467)
    * basic bugfixes to make the Viv CLI work again. not done just yet. savegame.
    and logging of traceback for "onecmd()" exceptions (duh)
    * config and argtrack (argtrack hasn't worked since 2013...)
    * bugfix: vdbbin (FAIL!)
    bugfix: getEndian() needs to be in IMemory, since other IMemory functions reference it.
    improvement: Removing non-GUI vprint() which uses logging instead of memory canvas. this is setting us up to make unittests for the CLI functions by patching in a StringMemoryCanvas and comparing the results.
    * change back VivWorkspace.vprint() and modify VivCli's inheritance so that EnviCli.vprint() wins
    * thought you might li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
2021-11-11 cleanup: remove "thread" from the logging format. that should save a few kb each run :)
2021-11-11 bugfix: ARM emulation analsyis pass - make stop when calling NoRet funcs
2021-11-16 bunch of little bugfixes (#470)
    * minor bugfix from Vdb/Viv/Emu bridge pr
    * adding a new posix noret
    * minor exception handling
    * bugfix: make elfplt analysis use makeFunctionThunk() in a way that actually catches norets using the fmcb_Thunk() analysis hook.
    bugfix: redo how pointers are incremented
    * cleanup: remove "thread" from the logging format. that should save a few kb each run :)
    * bugfix: ARM emulation analsyis pass - make stop when calling NoRet funcs
    * make function headers display "NORET" for functions that have been categorized as such.
    * cleanup makeFunctionThunk issues
    cleanup coloration of NORET
    * tweak testelf (yay, no longer cares about "unique" n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
2021-12-01 a couple related bugfixes found floating around.
2021-12-07 Envi intel idiv fix (#476)
    * touch ups and unittests
    * fix i386 idiv bug (see https://github.com/vivisect/vivisect/issues/414)
    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
2021-12-09 (simple)Viv gui memcanvas render filter bugfix (#474)
    * tweak testelf (yay, no longer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
2021-12-23 Emulation taint comments (crazy simple) (#490)
    * Envi intel idiv fix (#476)
    * (simple)Viv gui memcanvas render filter bugfix (#474)
    * bugfix: make elfplt analysis u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
2021-12-23 (simple) Interactive IPython update (#487)
    * bugfix: make elfplt analysis use m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
2021-12-27 make LC_UNIXTHREAD/thread_command work with .flavor (and getEntryPoints()) updates to work with bigendian (and wonky git-shit)
2021-12-29 docs update: dev intros and further "rapid learning curve" (#475)
    * still working on it, but savegame and share with friends.
    * mods per @rakuy0 (and a couple additions)
    * updates per @rakuy0
2022-01-03 V1.0.6 Release Prep (#492)
    v1.0.6 release prep (and some unit test fix-ups)
    [.bumpversion.cfg]
2022-01-13 V1.0.7 Release Prep (#496)
    v1.0.7 release prep
    [.bumpversion.cfg]
2022-02-11 EASY: fix string naming (which often chops off the last letter of t… (#502)
    * simple: fix string naming (which often chops off the last letter of the string)
    * unittest fix per @rakuy0
2022-04-15 fix sequencing for _snapInAnalysisModules() (#508)
    * fix sequencing for _snapInAnalysisModules(): it has to happen *after* starting the client thread.
    * use of a semaphore to ensure waiting for messages to be loading before setting up analysis modules for a remote connection.
    * slightly more sane: 10sec timeout
    * move semaphore triggers into the _mcb_* for Architecture and Platform, which is basically what we're waiting for *anyway*. remove from "if you ever process an event"
    * rework using threading.Event and a configurable timeout
2022-04-28 V1.0.8 Release Prep (#520)
    V1.0.7 Release Prep
    [.bumpversion.cfg]
2022-05-23 straggler remote gui-bugs (EASY, Before 5/15/22) (#525)
    * Break On Library Init (and stub for Library Load)
    and bugfix for clicking EFLAGS gui buttons.
    * modified flaky unittest
    * removed prints
    * bugfix for event/threading for notify/breakpoints
    * Finally! LockStepper Class moving into vtrace.envitools. Raw move here... updates to follow (for easy diffing between commits)
    * revamped the LockStepper class (still have to remove LockStepEmulator class and revamp "lockStepEmulator" when we're done)
    * oops
    * bugfix: make elfplt analysis use make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
2022-08-26 SymSwitches - fka. symbolik switchcase analysis (#112)
    here marks the end of an era...
    fairwell oh long-toothed PR. long live symbolik switchcase analysis!
    much love and pain hath gone into thy creation and refinement. go forth and make life better for all viv users.
    * symboliks-based switch-case analysis for arbitrary platforms. breaks on
    some graph core changes, but will fix that before making a pull request.
    * still truing up switch cases after merge. added thunk_bx detection as
    it is helpful in identifying variables used in switch case analysis
    * more truing
    * GitEye .gitignore
    * DynamicBranches analysis turned into a default VaSet for every architecture, and clean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
2022-09-30 Arm minor bugfixes (#546)
    * minor bugfixes in ARM disassembly and emulation
    * py3 hold-outs from the testing toolset
    * bugfix: bcc 24-bit branch calculation
    * ARM bugfixes and unittests
    * ARM unittest for first bugfix in the PR
2022-09-30 Reg Groups into Dicts (#542)
    * initial changes for envi.Architecture, and arch impls amd64/i386 and arm
    * oops.
    * start of copy modifications
    * Update envi/__init__.py: deepcopy for _regGrps
    * Update envi/__init__.py: deepcopy for the particular regGrp
2022-09-30 Arm fixes (easy) (#473)
    * tweak testelf (yay, no longer cares about "unique" names lik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
2022-10-27 omg, really? this bug has persisted since before switching to git, how? (#549)
2022-10-29 Enabling POSIX Library Load notifications (since PTRACE event model doesn't alert on library loads like Windows does). a couple other general bugfixes/deprecation-cleanup "because we're in the area."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
2023-02-06 Update Windows library APIs (#572)
    * Update Windows library APIs
    * msx64call and rettype
    TODO: rearrange the parts into an api/ directory
    TODO: update arm.py to work like amd64.py
    ---------
2023-02-24 V1.1.0 Release Prep (#576)
    It's about time.
    [.bumpversion.cfg]
2023-03-17 Migrate away from some deprecated functions (#593)
    * Migrate away from deprecated `assertRaisesRegexp`
    In Python 3.12 `assertRaisesRegexp` will no longer work. Replace it with
    `assertRaisesRegex`.
    * Migrate deprecated threading.currentThread
    * Migrate from deprecated `threading.Thread.setDaemon`
2023-03-25 cli: update regex that has an invalid escape sequence (currently a warning; to become a SyntaxError in a future version of Python) (#596)
    thanks @kastonework !
2023-03-29 ELF_Resiliency (#592)
    * have ELF not fall over if stuff doesn't go correctly (say, ELF Section headers are borked... which is not uncommon)
    * update to calculation
    * special case of 0-length memory maps with alignment (hint: make the map aligned-sized).
    in this approach, we make the zero-byte map actually have a byte, which in the event of an alignment setting, will make an aligned-size map instead of empty.
    alternate approach would be:
    * check if getMemoryMap() returns None at the end
    * if so, and the len(bytes) == 0:
    * return 0
    * print -> logger
    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
2023-04-07 V1.1.1 Release Prep
    [.bumpversion.cfg]
2023-07-20 minidump: parse Threads from MiniDumpThreadListStream (#625)
    currently a single thread is parsed, independent of `NumberOfThreads`. this PR parses all the threads.
2023-09-01 LEG architecture aliases (#628)
2023-10-01 ready: Cobra dcode upgrade and bugfix (#610)
    * open xrefs and menu items in a new Memory/FuncGraph view
    * working on making Cobra work on Python 3.11/3.12, checking to make sure dcode works properly again (currently seems like it does not)
    * dcode server worky again.
    typo, misvariabled `mod` and `module` mismatch.
    * make Dcode a runnable module
    add several core elements to the helper functions to start a CobraDaemon
    * usability enhancements for cobra Dcode
    Dcode unittests which actually make use of Dcode core functionality
    * remove `imp` dependency
    shore up unittest
    * updates to make unittests work on CircleCi like they do locally
    * cobra bugfixes and cleanup
    cobra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
2023-10-03 give a default name of "loc_########" so the address shows up while editing (in case you want to keep it there). displaying always defaults to that naming convention. (#630)
2024-03-23 Arm improvements (#631)
    * new emulation for orn instruction and unittest
    enhancement for archModXref
    mrs, msr register enhancements (supporting Cortex-M registers like BASEPRI)
    fix for a minor example_gui_extension.py bug (import bug)
    * enhancement for archModXref
    a few minor logging messages
    * tweaks (thanks unittests!)
    * improvements to ARM disasm, emu, and unittests :)
    * more touchups
    * touch-ups, thumb bugfixes, and unittests
    * more improvements: arm/thumb and unittests
    * bugfixes and test improvements
    * more updates and improvements for arm/thumb, especially MSR/MRS special registers
    * more work done on t32 and a32 MSR/MRS registers. more work to be done,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
2024-05-10 (easy) Save and Restore History for MemoryWindows and FuncGraphs (#648)
    * Save and Restore History for MemoryWindows and FuncGraphs
    * bugfix: create another deque, not [], so that appendleft() works
    wrap a little sanity around history (in case of badness)
2024-06-15 tag tracking in fg/memview (#646)
    * initial tag plumbing
    * straglers to the delta
    * first use-case for tagging.
    open to suggestions for improvement.
2024-07-15 V1.2.0 Release Prep (#652)
    * prep for release
    * bump2version change
    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
    [.bumpversion.cfg]
2024-08-12 Fix missing ARM alias in arch_defs (#666) (#667)
    * Fix missing ARM alias in arch_defs (#666)
    * Update envi/__init__.py
    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
2024-08-21 ARM arch name normalization (fka: arm _arch_id bugfix) (#668)
    * fix `ARMv7A` not having/being a valid archname, so `getArchByName()` returns None... causing `ArmModule.getArchId()` to return `None`
    * undo the work that @jpsnyder submitted
    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
2024-08-28 V1.2.1 Release Prep (#658)
    [.bumpversion.cfg]
2024-12-18 arm improvements (#672)
    * more
    * more
    * more
    * more arm improvements
    * updates for undefined and arch='arm'
    * unittests
    * more ARM disasm coverage
    * undefined, so let's not test :)
    * test count
2026-01-16 V1.3.0 Release Prep (#688)
    [.bumpversion.cfg]
